metodiev/nikolaevo-house/3d/images/10-vatreshna-kuhnya-s-mebel.png

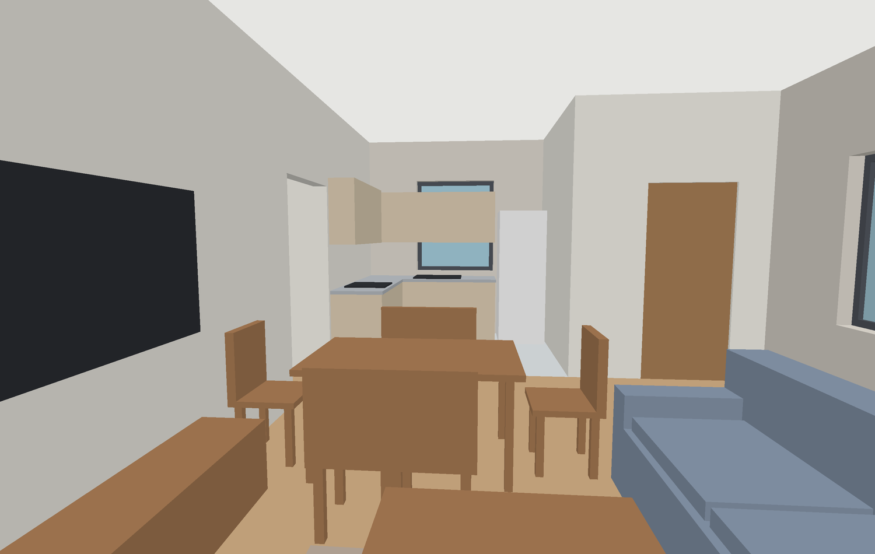
3d/images/10-vatreshna-kuhnya-s-mebel.png
