metodiev/nikolaevo-house/README.md

# Nikolaevo House

Проект за едноетажна ICF къща в Николаево.

## Концепция

Едноетажна, самостоятелна къща с ICF (изолирани бетонни кофражни) стени, максимално
правоъгълна форма, спални и хол на юг, вход от изток.

| Параметър | Стойност |
|---|---|
| Габарит | 12,00 × 8,20 m |
| Застроена площ | 98,4 m² |
| Чиста използваема площ | ≈ 80,3 m² |
| Спални | 2, двете с южно изложение |
| Хол + кухня | 30,8 m² отворено пространство |
| Баня | 1 |
| Мокро помещение / килер | 1 (пералня, съхранение, техника) |
| Ориентация | спални и хол – юг; кухня, баня, мокро – север; вход – изток |
| Покрив | двускатен, било изток–запад |
| Веранда (изток) | 1,80 × 8,20 = 14,76 m², отворена, дървена, собствен покрив |

## Площи на къщата

Едноетажна сграда, габарит **12,00 × 8,20 m** по външните стени.

| Показател | Как се получава | Площ |
|---|---|---|
| **Застроена площ (по външен контур)** | 12,00 × 8,20 | **98,40 m²** |
| Вътрешна площ в светли отвори | 11,30 × 7,50 | **84,75 m²** |
| **Чиста използваема площ** | сума на помещенията | **≈ 80,3 m²** |

Разликата от 98,40 до 80,3 m² е 18,1 m²: външните ICF стени (0,35 m по периметъра)
заемат ~13,7 m², а вътрешните прегради — ~4,4 m².

### По помещения

| Помещение | Размери (m) | Площ |
|---|---|---|
| Хол + трапезария | 4,70 × 5,28 | 24,8 m² |
| Кухня (отворена зона) | 2,68 × 2,22 | 5,95 m² |
| **Хол + кухня общо** | **отворено пространство** | **30,8 m²** |
| Спалня 1 | 3,15 × 4,10 | 12,9 m² |
| Спалня 2 | 3,15 × 4,10 | 12,9 m² |
| Коридор | 6,45 × 1,10 | 7,1 m² |
| Баня | 3,15 × 2,00 | 6,3 m² |
| Мокро помещение / килер | 3,15 × 2,00 | 6,3 m² |
| Антре | 1,90 × 2,10 | 4,0 m² |
| **Общо (чиста използваема)** | | **80,3 m²** |

Пълна площна сметка и координатна мрежа: [architecture/02-areas.md](./architecture/02-areas.md)

Всички числа се проверяват автоматично с `python tools/check_areas.py` —
скриптът изчислява площите от геометрията и обхожда целия проект за остарели
стойности ([tools/check_areas.py](./tools/check_areas.py)).

### За общината

Общината иска **застроена площ** и **разгъната застроена площ (РЗП)**. За тази
едноетажна къща двете са практически еднакви — няма втори етаж.

| Показател | Стойност |
|---|---|
| Застроена площ по външен контур (за нашия проект) | **98,40 m²** |
| РЗП (едноетажна, без сутерен и таван) | ≈ 98,40 m² |
| Веранда — по външен контур | 14,76 m² |
| **Общо с верандата** | **113,16 m²** |

> Верандата е **долепена и отворена**, не вградена. Дали влиза в застроената площ
> зависи от начина на отчитане — виж
> [architecture/05-veranda.md](./architecture/05-veranda.md).

> **Внимание:** точната дефиниция на „застроена площ“ и начинът на отчитане
> (по външен контур или по вътрешни стени, как се броят терасата и навесът) се
> определят от **проектанта по действащия ЗУТ и ПУП** — това **не е сигурно** без
> проверка и **се препоръчва консултация с общината**. Не попълвай тези числа в
> документи сам.

Плюс това общината следи и **процент на застрояване** и **КИНТ** за парцела — те
зависят от неговата площ, която още не е известна (виж
[отворените въпроси](./documentation/02-open-questions.md)).

## Структура на repository-то

| Папка | Съдържание |
|---|---|
| [architecture](./architecture) | Концептуален план, площи, дограма, диаграми, чертежи |
| [furniture](./furniture) | Обзавеждане — схеми и списък с размери |
| [electrical](./electrical) | Електроинсталация — план, табло, кръгове |
| [icf](./icf) | Пакет за доставчика на ICF панелите (задание, количества, скици) |
| [structure](./structure) | ICF конструктивна логика и детайли |
| [budget](./budget) | Оценка на разходите и бюджет „до ключ“ |
| [3d](./3d) | **3D модел** — интерактивен изглед, OBJ файлове, рендери |
| [materials](./materials) | Спецификация на основните материали |
| [documentation](./documentation) | Задание за проектанта, отворени въпроси |
| [plumbing](./plumbing) | ВиК (предстои) |
| [hvac](./hvac) | Отопление и вентилация (предстои) |
| [landscaping](./landscaping) | Двор и ландшафт (предстои) |
| [site](./site) | Парцел: кадастър, карти, измервания |
| [photos](./photos) | Снимки |

## Бърз достъп

**Архитектура**
- [Концептуален план](./architecture/01-concept-plan.md)
- [Площи](./architecture/02-areas.md)
- [Дограма и отвори](./architecture/03-openings.md)
- [Диаграми](./architecture/04-diagrams.md)
- [План 1:100 (SVG)](./architecture/plans/floor-plan.svg)
- [Ориентация в парцела (SVG)](./architecture/plans/site-orientation.svg)
- [Дограма и врати (SVG)](./architecture/plans/A-03-dograma.svg)
- [Веранда — описание и площи](./architecture/05-veranda.md)
- [Веранда — план 1:100 (SVG)](./architecture/plans/A-04-veranda.svg)
- [CAD план (DXF + PNG/SVG)](./architecture/cad/README.md) — генератор с ezdxf

**Обзавеждане**
- [Схеми и списък](./furniture/README.md)
- [Общ план (SVG)](./furniture/plans/F-01-obzor.svg)
- [Дневна зона (SVG)](./furniture/plans/F-02-dnevna.svg)
- [Спални (SVG)](./furniture/plans/F-03-spalni.svg)
- [Баня, мокро, антре (SVG)](./furniture/plans/F-04-mokri.svg)

**Електро**
- [Електро план и кръгове](./electrical/01-elektro-plan.md)
- [План на контактите (SVG)](./electrical/plans/E-01-plan.svg)
- [Схема на таблото (SVG)](./electrical/plans/E-02-tablo.svg)

**Конструкция**
- [ICF конструктивна логика](./structure/01-icf-structure.md)
- [Разрез на стена и подова плоча (SVG)](./structure/details/wall-section.svg)

**ICF доставчик**
- [Пакет за ICF доставчика](./icf/README.md)
- [Задание](./icf/01-zadanie.md) · [Стени и отвори](./icf/02-steni-i-otvori.md) · [Количества](./icf/03-kolichestva.md)
- [План на ICF стените (SVG)](./icf/plans/icf-plan.svg)
- [Фасади с отворите (SVG)](./icf/plans/icf-elevations.svg)
- [Детайли (SVG)](./icf/plans/icf-details.svg)

**3D модел**
- [Интерактивен 3D изглед](./3d/model.html) — отваря се в браузър, без интернет
- [3D модел (OBJ) с обзавеждане](./3d/house-full.obj) · [без обзавеждане](./3d/house-shell.obj)
- [Рендери: вън/вътре, с и без обзавеждане](./3d/README.md)

**Бюджет и документи**
- [Оценка на разходите (строителство)](./budget/01-cost-estimate.md)
- [Бюджет „до ключ“ с обзавеждане — таван ≈ 250 000 €](./budget/02-turnkey-max.md)
- [Задание за проектанта](./documentation/01-design-brief.md)
- [Отворени въпроси](./documentation/02-open-questions.md)

## Статус

Концепция — за обсъждане с проектант. Не е строителен проект и не замества
архитектурен и конструктивен проект по действащите изисквания.
