metodiev/nikolaevo-house/architecture/README.md

# Архитектура

Концептуален план на едноетажна ICF къща, 12,00 × 8,20 m (98,4 m² застроена площ).

## Документи

| Файл | Съдържание |
|---|---|
| [01-concept-plan.md](./01-concept-plan.md) | Концептуален план — зониране, разположение на помещенията, обосновка |
| [02-areas.md](./02-areas.md) | Списък на площите и площна сметка |
| [03-openings.md](./03-openings.md) | Дограма — прозорци, врати, позиции, размери |
| [04-diagrams.md](./04-diagrams.md) | Диаграми: зониране, циркулация, разпределение на площта |
| [05-veranda.md](./05-veranda.md) | Отворена веранда 1,80 × 8,20 m по цялата източна фасада |

## Чертежи

| Файл | Съдържание |
|---|---|
| [plans/floor-plan.svg](./plans/floor-plan.svg) | План на разположението, мащаб 1:100 при печат, с размери |
| [plans/site-orientation.svg](./plans/site-orientation.svg) | Ориентация и положение в парцела (схема, не е в мащаб) |
| [plans/A-03-dograma.svg](./plans/A-03-dograma.svg) | Дограма и врати — фасади на отворите с посока на отваряне |
| [plans/A-04-veranda.svg](./plans/A-04-veranda.svg) | Веранда — план 1:100 с обзавеждане за 6 души |

## CAD / DXF

| Файл | Съдържание |
|---|---|
| [cad/generate_plan.py](./cad/generate_plan.py) | Python скрипт (ezdxf) — генерира плана като DXF |
| [cad/house.dxf](./cad/house.dxf) | Генериран план, слоеве `WALLS` / `DOORS` / `WINDOWS` / `ROOMS` / `DIMENSIONS` |
| [cad/house.png](./cad/house.png) | Растерно изображение (200 dpi) |
| [cad/house.svg](./cad/house.svg) | Векторно изображение |

Скриптът чертае **същата къща** като останалите чертежи — 12,00 × 8,20 m и
стени 0,35 m. При стартиране проверява дали сметнатите площи съвпадат с
останалите документи и спира с грешка при разминаване. Подробности:
[cad/README.md](./cad/README.md).

## Основни решения

- Правоъгълник 12,00 × 8,20 m — без еркери, криви и ъгли, различни от 90°.
- Дългата ос е изток–запад: 12 m южен фасад за двете спални и хола.
- Вход от изток (достъпът до парцела е от изток), антре в североизточния ъгъл.
- Мокри функции (кухня, мокро помещение, баня) са групирани по северната стена —
  къси ВиК трасета.
- Спалните са отделени от дневната зона с коридор.

## Свързани папки

- [ICF пакет за доставчика](../icf) — задание, количества и скици за фирмата с панелите
- [Конструкция](../structure)
- [Бюджет](../budget)
- [Задание за проектанта](../documentation/01-design-brief.md)
