metodiev/nikolaevo-house/furniture/README.md

# Обзавеждане

Схеми и списък на обзавеждането за едноетажната ICF къща.

> Всички размери са **примерни** — показват, че мебелите се побират и че
> проходите са разумни. Не са проект за изработка на мебели.

---

## Схеми

| Лист | Съдържание | Мащаб |
|---|---|---|
| [F-01-obzor.svg](./plans/F-01-obzor.svg) | общ план с обзавеждане, всички помещения | 1:100 |
| [F-02-dnevna.svg](./plans/F-02-dnevna.svg) | хол + трапезария + кухня | 1:50 |
| [F-03-spalni.svg](./plans/F-03-spalni.svg) | двете спални | 1:50 |
| [F-04-mokri.svg](./plans/F-04-mokri.svg) | баня, мокро помещение, антре | 1:50 |

PNG версии за имейл и телефон: [images/](./images).

---

## Основна логика на разположението

| Помещение | Ключово решение |
|---|---|
| **Кухня** | Г-образен плот 600 mm: мивка под прозореца, котлони на западния плот, хладилник в североизточния ъгъл |
| **Трапезария** | Маса 1400 × 900 с 6 стола в западната част на хола, изтеглена на юг — проходът до коридора остава свободен |
| **Хол** | Диван 2200 mm с гръб на изток, срещу телевизора на западната преграда; северната ивица на хола е свободна за придвижване |
| **Спалня 1** | Легло 1600 × 2000 с табла на вътрешната преграда, гардероб 1600 mm, без скрин |
| **Спалня 2** | Легло 1600 × 2000 с табла на западната стена, гардероб 1200 mm, без скрин |
| **Баня** | Душ 1200 × 900, WC, мивка с шкаф 1000 mm |
| **Мокро** | Пералня, сушилня, плот с мивка, бойлер, вентилация |
| **Антре** | Гардероб 400 mm, пейка, електрическо табло |

Пълен списък с размери: [01-obzavezhdane.md](./01-obzavezhdane.md).

---

## Важни ограничения

1. **Гардеробите са с плъзгащи врати** — при 550 mm дълбочина крилата не могат да
   се отварят навън без да блокират прохода.
2. **Леглата са с табла на вътрешна стена** — не под прозорец.
3. **Пред плъзгащата врата на юг** се оставя свободна зона поне 1200 mm.
4. **Кухнята е на север** — плотът е под прозореца, но осветлението над плота
   трябва да е изкуствено и достатъчно.
5. Размерите на мебелите в схемите са типични за българския пазар — при поръчка
   се проверяват спрямо избрания модел.

---

## Как се генерират

```bash
python furniture/generate_furniture.py       # SVG в plans/
python tools/export_png.py furniture         # PNG в images/
```

Скриптът държи геометрията на сградата и обзавеждането на едно място — при
промяна на план се редактира само той.

---

**Виж още:** [концептуален план](../architecture/01-concept-plan.md) ·
[площи](../architecture/02-areas.md) ·
[дограма](../architecture/03-openings.md) ·
[електро](../electrical)
