metodiev/nikolaevo-house/3d/README.md

# 3D модел на къщата

Обемен модел на едноетажната ICF къща — за оглед отвън и отвътре, със и без
обзавеждане. Геометрията се строи от **същите размери**, използвани в 2D
чертежите, така че не може да се разминава с тях.

> Това е **концептуален обемен модел**, не работен проект. Мебелите са с
> примерни размери и форми; покривът е опростен; няма конструктивни детайли,
> инсталации и точно осветление.

---

## 1. Какво има в папката

| Файл | Какво е |
|---|---|
| [model.html](./model.html) | **Интерактивен 3D изглед** — отваря се с двоен клик в браузър |
| `model-data.js` | Геометрията, която `model.html` зарежда (генерира се) |
| `model-data.json` | Същата геометрия като JSON — за други инструменти |
| `house-full.obj` + `.mtl` | 3D модел **с обзавеждане** — за Blender, SketchUp, Revit и др. |
| `house-shell.obj` + `.mtl` | 3D модел **само конструкция** — без обзавеждане |
| [generate_3d.py](./generate_3d.py) | Скриптът, който строи всичко и рендира картинките |
| `images/` | Рендерите (виж по-долу) |

Всичко се пресъздава с една команда:

```
python generate_3d.py
```

---

## 2. Интерактивният изглед

Отвори [model.html](./model.html) с двоен клик — работи без интернет и без
инсталация (данните са в `model-data.js`).

- **Влачене с мишката** — завъртане
- **Колело** — увеличение
- **Десен бутон** — преместване
- Отметки: обзавеждане / покрив / таван / стени и дограма / основа и подове
- Бутони за готови гледни точки: външна югоизток и североизток, план отгоре,
  вътре в хол, кухня и спалня
> При избор на вътрешна гледна точка покривът се скрива автоматично, а таванът
> остава — иначе се вижда само небето.

---

## 3. Рендерите

| Файл | Какво показва |
|---|---|
| `01-aksonometriya-s-mebel.png` | разрез-аксонометрия от югоизток **с** обзавеждане |
| `02-aksonometriya-bez-mebel.png` | същата, **без** обзавеждане |
| `03-aksonometriya-severoiztok.png` | аксонометрия от североизток |
| `04-fasada-yug.png` | южна фасада (прав изглед) |
| `05-fasada-iztok.png` | източна фасада — входът |
| `06-perspektiva-yugoiztok.png` | външна перспектива от югоизток |
| `07-perspektiva-severoiztok.png` | външна перспектива от североизток |
| `08-vatreshna-dnevna-s-mebel.png` | хол + трапезария **с** обзавеждане |
| `09-vatreshna-dnevna-bez-mebel.png` | хол **без** обзавеждане |
| `10-vatreshna-kuhnya-s-mebel.png` | изглед към кухнята **с** обзавеждане |
| `11-vatreshna-kuhnya-bez-mebel.png` | кухня **без** обзавеждане |
| `12-vatreshna-spalnya-s-mebel.png` | спалня **с** обзавеждане |
| `13-vatreshna-spalnya-bez-mebel.png` | спалня **без** обзавеждане |
| `14-veranda-s-mebel.png` | отворената веранда отвън, с пейката |
| `15-veranda-otvorena.png` | верандата отгоре, без собствения покрив |

„Разрез-аксонометрия" означава, че стените са отрязани на 1,35 m — така се
вижда разпределението от птичи поглед.

---

## 4. Как е построен моделът

| Елемент | Стойност | Източник |
|---|---|---|
| Габарит | 12,00 × 8,20 m | [architecture/02-areas.md](../architecture/02-areas.md) |
| Външни стени | 0,35 m ICF | [structure/01-icf-structure.md](../structure/01-icf-structure.md) |
| Вътрешни прегради | 0,15 m и 0,12 m | същото |
| Височина до стреха | 3,00 m | [architecture/cad](../architecture/cad) |
| Покрив | двускатен, наклон 25°, надвес 0,60 / 0,50 m | [structure/01-icf-structure.md](../structure/01-icf-structure.md) |
| Отвори | П1–П9 и В1–В6 с точни размери и подпрозорци | [architecture/03-openings.md](../architecture/03-openings.md) |
| Обзавеждане | координатите от 2D листовете F-01…F-04 | [furniture/](../furniture) |
| Веранда | 1,80 × 8,20 m отворена, по цялата източна фасада | [architecture/05-veranda.md](../architecture/05-veranda.md) |

Дебелината на покрива (0,20 m) и надвесът са **работни допускания** —
окончателните стойности се определят от конструктор.

---

## 5. Ограничения

- **Покривът е опростен** — без ферми, улуци, снегозадържачи.
- **Обзавеждането е блоково** — правоъгълници с правилните размери и позиции,
  но без форми и детайли. За покупка се ползва [furniture/01-obzavezhdane.md](../furniture/01-obzavezhdane.md).
- **Няма инсталации** — тръби, кабели и въздуховоди не са моделирани.
- **Няма терен** — земята е равна равнина.
- **Осветлението е условно** — два посоки + околна светлина, не е фотореализъм.
- Файловете `.obj` са с метрични единици. Ако нормалите изглеждат обърнати в
  дадена програма, пусни „Recalculate Outside" (Blender: Shift+N).
