metodiev/nikolaevo-house/budget/README.md

# Бюджет

Ориентировъчна оценка на разходите за едноетажната ICF къща (98,4 m² застроена площ).

## Документи

| Файл | Съдържание |
|---|---|
| [01-cost-estimate.md](./01-cost-estimate.md) | Груба оценка: конструкция и базова завършеност, допускания, изключени разходи |
| [02-turnkey-max.md](./02-turnkey-max.md) | **Бюджет „до ключ“ с обзавеждане — таван ≈ 250 000 €** |

## Важно

Всички стойности са **ориентировъчни диапазони**, а не оферти.

> Това е само ориентировъчна стойност, действителната цена зависи от местната оферта.

## Свързани папки

- [Архитектура](../architecture)
- [Конструкция](../structure)
- [ICF оферта](../icf/README.md)
- [Обзавеждане](../furniture/01-obzavezhdane.md)
