metodiev/nikolaevo-house/electrical/README.md

# Електроинсталация

Концептуален план на електричеството — контакти, ключове, осветление и табло.

## Документи и схеми

| Файл | Съдържание |
|---|---|
| [01-elektro-plan.md](./01-elektro-plan.md) | описание: табло, кръгове, точки по помещения, ICF специфика |
| [plans/E-01-plan.svg](./plans/E-01-plan.svg) | план на контактите и осветлението, 1:75 |
| [plans/E-02-tablo.svg](./plans/E-02-tablo.svg) | едносхемна схема на таблото |

PNG версии: [images/](./images).

## Накратко

- **Табло:** в антрето, на южната стена до вратата, височина 1400–1800 mm.
- **12 кръга** в таблото (2 от тях резервни), две дефектнотокови защити.
- Кухнята е на отделен кръг — котлони и фурна не се комбинират с контактите.
- Баня, мокро и външните консуматори са на ДЗТ 2 (30 mA).

## ICF специфика

- В ICF стена **не се къртят канали** — трасетата се планират предварително.
- Контакти на външните стени изискват заложени тръби в кофража.
- Таблото е на вътрешна преграда — по-лесно обслужване.

## Виж още

- [Обзавеждане](../furniture) — как мебелите определят позициите на контактите
- [ICF конструкция](../structure/01-icf-structure.md)
- [Отворени въпроси](../documentation/02-open-questions.md)
- [Бюджет „до ключ“](../budget/02-turnkey-max.md)
