metodiev/nikolaevo-house/documentation/README.md

# Документация

Работни документи за комуникация с проектант, изпълнител и институции.

## Документи

| Файл | Съдържание |
|---|---|
| [01-design-brief.md](./01-design-brief.md) | Задание за проектанта — изисквания, приети решения, ограничения |
| [02-open-questions.md](./02-open-questions.md) | Отворени въпроси и липсваща информация (чеклист) |

## Свързани папки

- [Архитектура](../architecture)
- [Конструкция](../structure)
- [Бюджет](../budget)
- [Парцел](../site)
