metodiev/nikolaevo-house/landscaping/README.md

# Двор и ландшафт

Предстои.

## Връзка с концепцията

- Достъпът е от **изток** → паркинг и подход от изток.
- Южната фасада е свободна за **тераса** (препоръчително ~4,0 × 3,0 m) и градина.
- Засенчване на южните отвори — надвес или пергола.
- Западната фасада е минимално отворена.

## Виж още

- [Ориентация в парцела](../architecture/plans/site-orientation.svg)
- [Концептуален план](../architecture/01-concept-plan.md)
