metodiev/nikolaevo-house/photos/README.md

# Снимки

Снимки на терена, на съседни сгради и на референтни ICF обекти.

- Снимки на парцела (за контекст и засенчване)
- Снимки на подхода от изток
- Референтни сгради с ICF конструкция

**Все още няма качени снимки.**
