metodiev/nikolaevo-house/structure/README.md

# Конструкция

ICF (изолирани бетонни кофражни) конструкция на едноетажната къща.

## Документи

| Файл | Съдържание |
|---|---|
| [01-icf-structure.md](./01-icf-structure.md) | Конструктивна логика, слоеве, фундамент, покрив, отвори, инсталации |

## Чертежи

| Файл | Съдържание |
|---|---|
| [details/wall-section.svg](./details/wall-section.svg) | Схематичен разрез: външна стена, подова плоча, фундамент, покрив |

## Накратко

- **Външни стени** — носещи ICF стени с бетонно ядро, затворен правоъгълен контур.
- **Вътрешни стени** — неносещи прегради (газобетон или гипсокартон).
- **Покрив** — двускатен, дървена конструкция, стъпва само на външните стени.
- **Под** — плоча върху земя с непрекъсната топлоизолация под нея.

## Свързани папки

- [Архитектура](../architecture)
- [Бюджет](../budget)
