metodiev/nikolaevo-house/architecture/03-openings.md

# Дограма и отвори

Спецификация на прозорци и врати за концептуалния план.

> Размерите са **номинални** (отвор в светъл размер). Реалните размери зависят от
> избраната дограма, монтажната система и ICF системата. Всички отвори в ICF стена
> изискват проектирана надгреда и армировка — уточнява се от конструктор.

---

## 1. Координатна система

Позициите са в **mm**, мерени от външния северозападен ъгъл на сградата:

- `x` — на изток от западната фасада (0 → 12 000)
- `y` — на юг от северната фасада (0 → 8 200)

---

## 2. Прозорци

| № | Помещение | Фасада | Ш × В (mm) | Подпрозорец (mm) | Позиция | Функция |
|---|---|---|---|---|---|---|
| П1 | Спалня 1 | юг | 1 500 × 1 400 | 800 | x 1 175 – 2 675 | Основна светлина, изглед |
| П2 | Спалня 2 | юг | 1 500 × 1 400 | 800 | x 4 475 – 5 975 | Основна светлина, изглед |
| П3 | Хол / трапезария | юг | **плъзгаща врата 2 800 × 2 250** | 0 | x 7 900 – 10 700 | Изход към тераса, основна светлина |
| П4 | Кухня | север | 1 200 × 1 400 | 1 000 | x 7 690 – 8 890 | Над плота, работна светлина |
| П5 | Баня | север | 600 × 600 | 1 600 | x 1 625 – 2 225 | Вентилация + дискретна светлина |
| П6 | Мокро помещение | север | 600 × 600 | 1 500 | x 4 925 – 5 525 | Вентилация + светлина |
| П7 | Трапезария | изток | 1 600 × 1 400 | 800 | y 3 500 – 5 100 | Сутрешна светлина |
| П8 *(опция)* | Спалня 1 | запад | 1 000 × 1 400 | 800 | y 5 200 – 6 200 | Кръстосано проветряване |
| П9 | Хол (югоизток) | изток | 1 400 × 1 400 | 800 | y 5 900 – 7 300 | Допълнителна светлина в хола |

**Обща площ на остъкляването в южния фасад:** 2 × 2,10 + 6,30 = **10,5 m²**
(при южна стена ~12,0 × 3,0 m). Това е сериозно количество — виж т. 5.

**Източно остъкляване:** П7 (2,24 m²) + П9 (1,96 m²) = **4,2 m²**.
Общо за сградата (без опцията П8): **17,1 m²**; с П8 — 18,5 m².

---

## 3. Врати

| № | Помещение | Фасада / стена | Ш × В (mm) | Позиция | Бележка |
|---|---|---|---|---|---|
| В1 | Входна | изток | 1 050 × 2 100 | y 700 – 1 750 | Навес отвън, прагово осветление |
| В2 | Антре → хол | преграда | 900 × 2 100 | x 10 400 – 11 300 | Стъклена врата по избор |
| В3 | Коридор → спалня 1 | преграда | 900 × 2 000 | x 900 – 1 800 | Отваря се в стаята |
| В4 | Коридор → спалня 2 | преграда | 900 × 2 000 | x 4 700 – 5 600 | Отваря се в стаята |
| В5 | Коридор → баня | преграда | 900 × 2 000 | x 2 200 – 3 100 | Отваря се в банята |
| В6 | Коридор → мокро помещение | преграда | 900 × 2 000 | x 3 800 – 4 700 | Отваря се в помещението |
| – | Коридор → хол | преграда | **отвор 1 100, без врата** | y 2 500 – 3 600 | Широк проход |

Бележки по вратите:

- Всички вътрешни врати са с **праг, равен на пода** (без преход) — удобно за
  почистване и за достъпност.
- Входната врата е на **източната** фасада — предвижда се **навес** или издадена плоча,
  защото валежите и вятърът там са чести.
- В банята и мокрото помещение — влагоустойчиви врати с долен вентилационен процеп.

---

## 4. Изисквания към дограмата

| Аспект | Препоръка | Статус |
|---|---|---|
| Профил | PVC или алуминий с термомост; **по енергиен проект** | за уточняване |
| Стъклопакет | двоен или троен; **ниска слънчева пропускливост (g) на юг**, по-висока на север | за уточняване |
| Топлинни характеристики | по енергийния проект/сертификат на сградата | **не е сигурно** — изисква проект |
| Монтаж | в зоната на изолацията, с монтажни ленти и правилен преход към ICF слоевете | критично за херметичност |
| Сенници/ролетки | касета, скрита в преградата или в тавана — съгласува се с дебелината на стената | за уточняване |
| Подпрозоръчни первази | външен каперезлив профил + вътрешен перваз | – |

**Важно за ICF:** отворите се правят в кофража, а не се изрязват след бетониране.
Плъзгащата врата 2,80 m изисква стоманобетонна надгреда — нормално решение, но
трябва да е предвидено в конструктивния проект.

---

## 5. Слънце и засенчване

| Фасада | Риск | Мярка |
|---|---|---|
| Юг | лятно прегряване през 10,5 m² стъкло | надвес/пергола ≥ 1,0–1,2 m; външно засенчване; стъкло с нисък g |
| Изток | сутрешно нагряване | умерен отвор 1,60 m; щора/външна жалузия |
| Запад | следобедно прегряване | без отвор или само малък, със задължително засенчване |
| Север | топлинни загуби | малки отвори, високо разположени |

Точният размер на надвеса се изчислява от проектант според географската ширина и
желаното засенчване — **тук не се дават конкретни стойности, защото зависят от
изчисление**.

---

## 6. Вентилация

- Баня, мокро помещение и кухня: **механично изсмукване** (не разчитайте само на
  прозорците).
- ICF къщата е практически херметична → препоръчва се **вентилация с рекуперация**,
  като агрегатът се позиционира в мокрото помещение.
- Въздуховодите се планират предварително — в ICF стена не се къртят канали.

---

**Виж още:** [концептуален план](./01-concept-plan.md) · [площи](./02-areas.md) ·
[конструкция](../structure/01-icf-structure.md)
