metodiev/nikolaevo-house/architecture/05-veranda.md

# Веранда (изток) — отворена

Отворена дървена веранда по **цялата източна фасада** на къщата.
**1,80 × 8,20 m = 14,76 m²** — покрит навес с подова скара, подпори и парапет.

> Това е **концепция**, не строителен чертеж. Конструкцията, фундирането и
> захващането към къщата се оразмеряват от проектант.

---

## 1. Позиция

Координатите са в mm от северозападния ъгъл на къщата (x — изток, y — юг):

| Ръб | Координата |
|---|---|
| Западен (до къщата) | x = **12 000** |
| Източен | x = **13 800** |
| Северен | y = **0** |
| Южен | y = **8 200** |

Верандата минава по цялата дължина на сградата и **покрива входната врата В1**
(y 700–1 750) — входът става защитен от дъжд и сняг. Прозорците **П7** и **П9**
също са под навеса, което ги пази от пряко слънце и валежи.

Не изменя ICF стените — долепена е, с дилатационна фуга.

---

## 2. Площи

| Показател | Стойност |
|---|---|
| Къща (застроена) | 98,40 m² |
| Веранда (по външен контур) | **14,76 m²** |
| **Общо с верандата** | **113,16 m²** |

**За общината:** отворената веранда **обикновено не се брои** към застроената
площ по същия начин, както затворено помещение, но точната дефиниция и начинът
на отчитане **не са сигурни** — уточняват се с проектанта и общината. Затова
двете числа са дадени отделно. Не попълвай тези числа в документи сам.

---

## 3. Конструкция

| Елемент | Решение |
|---|---|
| Основа | точкови фундаменти под подпорите — **не е оразмерено** |
| Под | дървена скара с дъски, ~80 mm под котата на къщата |
| Подпори | дървени **100 × 100 mm**, на ~2,0 m (5 бр.) |
| Парапет | дървен, **1,00 m**, по външния ръб; започва след входа (y > 2,30) |
| Покрив | **собствен едноскатен**: 2,90 m при къщата → 2,45 m при външния ръб |
| Покривно покритие | по избор — битумни керемиди, метал, поликарбонат |
| Стъпало | при северния край, до входната врата |
| Връзка с къщата | дилатационна фуга; **без пробиване на ICF стената** |

Покривът на верандата минава **под** стрехата на къщата — двете покривни
плоскости не се пресичат. Проверява се на място според изпълнението.

---

## 4. Обзавеждане

| # | Артикул | Размер | Бр. |
|---|---|---|---|
| 1 | Пейка до стената | 440 × 1500 | 1 |

> **Внимание:** при дълбочина 1,80 m **маса за 6 души не се побира** — за
> хранене трябва или по-дълбока веранда (≥ 2,60 m), или масата остава в хола.
> Верандата е за сянка, кафе и престой, не за хранене.

---

## 5. Какво печели къщата

- **Покрит вход** — В1 е защитен от валежи, а изтокът е ветровит.
- **Сянка** за източната фасада през лятото → по-малко прегряване на хола.
- **Връзка двор ↔ хол** без стъпала и кал по пода.
- Навесът пази дограмата от пряко слънце и удължава живота ѝ.

---

## 6. Ограничения и отворени въпроси

- [ ] **Достъп от вътре** — сега от хола се излиза само през прозорци. Ако искаш
      врата, **П7 трябва да стане врата** (1600 × 2200) — това променя ICF пакета
      и надгредата.
- [ ] **Ширина 1,80 m** — достатъчна за проход и пейка, но не за маса.
      Ако искаш хранене навън, нужна е дълбочина ≥ 2,60 m.
- [ ] **Основа** — нивото на терена при източната фасада не е измерено.
- [ ] **Отводняване** — покривът на верандата събира вода; трябва улук и
      отвеждане, иначе пада на входа.
- [ ] **ПУП** — дали навесът е допустим на това разстояние от съседната граница,
  се проверява по ПУП.

---

**Виж още:** [концептуален план](./01-concept-plan.md) · [дограма](./03-openings.md) ·
[план на верандата (SVG)](./plans/A-04-veranda.svg) ·
[3D модел](../3d/README.md)
