metodiev/nikolaevo-house/architecture/01-concept-plan.md

# Концептуален план

Едноетажна, самостоятелна ICF къща · 12,00 × 8,20 m · 98,4 m² застроена площ ·
вход от изток · спални и хол на юг.

> Концепция за обсъждане с проектант. Не е строителен чертеж. Всички размери са
> номинални и подлежат на проверка и оразмеряване от лицензиран архитект и конструктор.

---

## 1. Обобщение

| Параметър | Стойност |
|---|---|
| Габарит (външен) | 12,00 m изток–запад × 8,20 m север–юг |
| Застроена площ | 98,40 m² |
| Вътрешна площ в светли отвори | 11,30 × 7,50 = 84,75 m² |
| Чиста използваема площ | ≈ 80,3 m² |
| Външни ICF стени | ≈ 350 mm (работно допускане) |
| Вътрешни прегради | 150 mm; 120 mm около антрето |
| Периметър на външните стени | 40,4 m |
| Покрив | двускатен, било по оста изток–запад |
| Етажност | 1 |

## 2. Защо 98,4 m², а не 96 m²

Първоначалната концепция беше 12,00 × 8,00 m = 96 m² с **вход от север**. След
уточнението, че **достъпът до парцела е от изток**, входът се мести на източната
фасада и това променя геометрията:

- Антрето трябва да е на източната фасада. То заема ~4,0 m² плюс преградите си от
  дневната зона.
- При 96 m² дневната зона е 4,30 × 7,30 m = 31,4 m². След отделяне на антре остават
  под 30 m² — не изпълнява изискването „хол + кухня ≥ 30 m²“.
- Затова къщата се увеличава с 0,20 m по дълбочина: **12,00 × 8,20 m = 98,4 m²**.
  Дневната зона става 4,70 × 7,50 m = 35,25 m², а след антрето остават **30,8 m²**
  отворено пространство.

98,4 m² е в горната част на зададения диапазон 75–99 m², но е най-малката площ,
при която всички изисквания се изпълняват без компромис.

## 3. Форма и ориентация

- **Правоъгълник**, съотношение 1,46 : 1 — компактен, нисък периметър спрямо площта.
- Само ъгли 90° → стандартни ICF ъглови блокове, без еркери, криви и скосявания.
- Дългата ос е **изток–запад**, за да се получи максимален южен фасад — 12 m.
- **Юг:** двете спални + холът (голяма плъзгаща врата към тераса).
- **Север:** кухня, мокро помещение, баня — малки отвори, без прегряване.
- **Изток:** вход + един прозорец за трапезарията (сутрешна светлина).
- **Запад:** почти затворен фасад (следобедно прегряване), само опционален малък
  прозорец в спалня 1.

Чертеж: [plans/floor-plan.svg](./plans/floor-plan.svg) · Схема на парцела:
[plans/site-orientation.svg](./plans/site-orientation.svg)

## 4. Зониране

Къщата е разделена на две зони по дължина и на три ленти по дълбочина.

| Зона | Ширина | Съдържание |
|---|---|---|
| **Източна — дневна** | 4,70 m | хол, трапезария, кухня, антре — едно отворено пространство |
| **Западна — спална и обслужваща** | 6,45 m | две спални, коридор, баня, мокро помещение |

| Лента (от север) | Дълбочина | Съдържание |
|---|---|---|
| Северна | 2,00–2,10 m | баня, мокро помещение, кухненска зона, антре |
| Средна | 1,10 m | коридор |
| Южна | 4,10 m | спалня 1, спалня 2, хол |

**Принцип на групиране:** всички мокри функции (кухня, мокро помещение, баня) лежат
на една линия по северната стена, съседни една на друга. Това дава къси ВиК трасета,
обща водопроводна стена и един излаз за канализационните сонди.

## 5. Разположение на помещенията

Координатите по-долу са в mm, измерени от **външния северозападен ъгъл**:
`x` — на изток от западната фасада, `y` — на юг от северната фасада.
Пълната координатна мрежа е в [02-areas.md](./02-areas.md).

### 5.1 Дневна зона — хол, трапезария, кухня (отворено)

**Източният край на къщата, 4,70 m широка, по цялата дълбочина 7,50 m.**
Без вътрешни прегради — едно пространство.

- **Хол + трапезария** (южна част, ≈ 24,8 m²): южният фасад е плъзгаща врата 2,80 m
  към тераса. Трапезната маса е в зоната пред кухнята, към източния прозорец.
- **Кухня** (северна част, ≈ 5,95 m² под + плотове): Г-образен плот по северната стена
  (~2,7 m) и по преградата към мокрото помещение (~2,0 m). Мивката е на преградата —
  плътно до мокрото помещение, за да е къс водопроводът. Плотът по северната стена е
  под прозореца.
- **Мека граница** между кухня и хол: маркирана само с линия на пода/таван — без
  преграда, за да остане пространството отворено.

### 5.2 Антре

**Североизточен ъгъл, 1,90 × 2,10 m (4,0 m²).**

- Входна врата на **източната** фасада (достъпът е от изток).
- Врата на юг към хола.
- Гардероб/закачалка по западната стена.
- Задължителен **навес** над входа отвън (източен вятър/дъжд).

Антрето е отделно затворено помещение — това е и топлинен шлюз за ICF къщата.

### 5.3 Спалня 1

**Югозападен ъгъл, 3,15 × 4,10 m (12,9 m²).**

- Южен прозорец 1,50 m.
- Опционален западен прозорец 1,00 m за кръстосано проветряване.
- Врата от коридора, в северната част на стаята.
- Място за двуспално легло с глава на западната или източната стена (без прозорец
  зад главата), гардероб по северната стена.

### 5.4 Спалня 2

**Южна лента, в средата, 3,15 × 4,10 m (12,9 m²).**

- Южен прозорец 1,50 m.
- Врата от коридора.
- Единствен фасад — юг (вж. ограниченията в т. 8).

### 5.5 Коридор

**Средна лента, 6,45 × 1,10 m (7,1 m²).**

- Свързва антрето/хола с двете спални, банята и мокрото помещение.
- Източният край се отваря широко (1,10 m) към хола.
- Възможно вградено ниско шкафче по дължината (дълбочина ~0,35 m).

### 5.6 Баня

**Северозападен ъгъл, 3,15 × 2,00 m (6,3 m²).**

- Душ (или вана), WC, мивка, шкаф.
- Малък северен прозорец 0,60 × 0,60 на високо ниво.
- Задължителна механична вентилация.
- Дължината 3,15 m позволява душът и WC да са в единия край, а мивката и шкафът —
  в другия.

### 5.7 Мокро помещение / килер

**Северна лента, до банята, 3,15 × 2,00 m (6,3 m²).**

- Пералня, сушилня (по избор), стелажи, техника.
- Тук се позиционират: бойлер/термопомпа, вентилационен агрегат с рекуперация,
  евентуален колектор.
- Малък северен прозорец 0,60 × 0,60 + механично изсмукване.
- Плот за пране и мивка за ръце (по избор).

## 6. Циркулация

```
Вход (изток) → антре → хол/трапезария/кухня (отворено)
                   ↘
                     хол → коридор → спалня 1
                                  → спалня 2
                                  → баня
                                  → мокро помещение
```

- Най-дългият път от входа до най-далечната стая е ~9 m.
- Коридорът е единственият „тъмен“ участък; осветява се от хола в източния си край.
  Ако е важно, може да се добави покривен тунел/светлинен тунел над коридора.

## 7. Връзка с парцела

- Достъпът е от **изток** → вход, паркинг и обслужване от изток.
- Южната фасада е свободна за тераса и градина.
- Северната фасада е „обслужваща“ — там са малките отвори; подходяща за
  климатични тела, ВиК разклонения и складиране.
- Западната фасада е минимално отворена — предпазва от следобедно слънце.
- Тераса: препоръчително ~4,0 × 3,0 m пред плъзгащата врата (извън 98,4 m²).

Разположението спрямо границите на парцела **не е определено** — изисква кадастрална
скица и проверка на отстоянията по ПУП.

## 8. Ограничения на концепцията

1. **Спалня 2 има само един фасад (юг).** Няма кръстосано проветряване — изтокът е
   зает от хола, северът от коридора. Компенсация: проветряване през вратата и
   вентилация с рекуперация.
2. **Коридорът е 7,1 m² (≈ 9 % от чистата площ)** — цената на отделянето на спалните
   от дневната зона. Ако приватността не е приоритет, спалните могат да се отворят
   директно към хола и да се спечелят ~5 m².
3. **Кухнята е на север** — по-малко пряко слънце, но и без прегряване; изисква добро
   изкуствено осветление над плота.
4. **Голямата южна плъзгаща врата (2,80 m)** създава риск от лятно прегряване.
   Задължително външно засенчване (надвес ≥ 1,0 m или пергола) и стъклопакет с ниска
   слънчева пропускливост. Точният размер на надвеса се изчислява от проектант.
5. **Площта е близо до горната граница на диапазона (99 m²).** Намаляване до ~88 m² е
   възможно само с отказ от едно от изискванията.
6. **12 m дължина** може да не се събере на тесен парцел с отстоянията по ПУП.
7. **Антрето е малко (1,90 × 2,10 m).** Достатъчно е за гардероб и обувки, но не за
   място за сядане.
8. Всичко, свързано с **геология, ниво на подпочвени води, ПУП, отстояния, височина
   и наклон на покрива**, е **неизвестно** и трябва да се провери.

Пълен списък: [02-open-questions.md](../documentation/02-open-questions.md).

## 9. Следващи стъпки

1. Проверка на разположението в парцела (кадастър + ПУП).
2. Избор на ICF система и на нейния геометричен модул.
3. Геоложки доклад.
4. Архитектурен проект (фази: идеен → технически → работен).
5. Конструктивен проект.
6. Оферти от 2–3 изпълнители с опит в ICF.

---

**Свързани документи:** [площи](./02-areas.md) · [дограма](./03-openings.md) ·
[диаграми](./04-diagrams.md) · [конструкция](../structure/01-icf-structure.md) ·
[бюджет](../budget/01-cost-estimate.md)
