metodiev/nikolaevo-house/architecture/02-areas.md

# Площи

Площна сметка на концепцията. Всички размери в **mm**, площите в **m²**.

> Номинални стойности по концептуалния план. Подлежат на преизчисляване в
> архитектурния проект (особено след избор на конкретна ICF система и нейната
> дебелина).

---

## 1. Обща площна сметка

| Показател | Изчисление | m² |
|---|---|---|
| Застроена площ | 12,00 × 8,20 | **98,40** |
| − Външни ICF стени (в план) | 98,40 − 84,75 | −13,65 |
| Вътрешна площ в светли отвори | 11,30 × 7,50 | **84,75** |
| − Преградни стени | 84,75 − 80,28 | ≈ −4,47 |
| **Чиста използваема площ** | | **≈ 80,3** |

---

## 2. Площи по помещения

| № | Помещение | Размери (mm) | Площ (m²) | Ориентация |
|---|---|---|---|---|
| 01 | Хол + трапезария | 4700 × 5280 | **24,8** | юг, изток |
| 02 | Кухня (отворена зона) | 2680 × 2220 | **5,95** | север |
| | **Общо отворено пространство 01 + 02** | 4700 × 7500 − антре − стени | **30,8** | |
| 03 | Спалня 1 | 3150 × 4100 | **12,9** | юг |
| 04 | Спалня 2 | 3150 × 4100 | **12,9** | юг |
| 05 | Коридор | 6450 × 1100 | **7,1** | – |
| 06 | Баня | 3150 × 2000 | **6,3** | север |
| 07 | Мокро помещение / килер | 3150 × 2000 | **6,3** | север |
| 08 | Антре | 1900 × 2100 | **4,0** | изток |
| | **Сума (чиста използваема)** | | **80,3** | |

Сума на чистата използваема площ:

24,80 + 5,95 + 12,92 + 12,92 + 7,10 + 6,30 + 6,30 + 3,99 = **80,28 ≈ 80,3 m²**

---

## 3. Преградни стени

| Преграда | Дебелина | Дължина | m² |
|---|---|---|---|
| Дневна зона / спална зона (с проход) | 150 | 7 500 | 1,13 |
| Баня / мокро помещение | 150 | 2 000 | 0,30 |
| Северна лента / коридор | 150 | 6 450 | 0,97 |
| Коридор / спални | 150 | 6 450 | 0,97 |
| Между спалните | 150 | 4 100 | 0,62 |
| Антре — стени (2 бр.) | 120 | ~3 950 | 0,47 |
| **Общо** | | | **≈ 4,45** |

Разликата от 4,47 в общата сметка идва от закръглянето на дължините в таблицата.

---

## 4. Координатна мрежа на осите

Начало: **външен северозападен ъгъл**. `x` расте на изток, `y` расте на юг.

### Вертикални оси (по x)

| Оса | x (mm) | Описание |
|---|---|---|
| A | 0 | външна фасада запад |
| B | 350 | вътрешна повърхност на западната стена |
| C | 3 500 | преграда баня / мокро (западна страна) |
| D | 3 650 | преграда баня / мокро (източна страна) |
| E | 6 800 | преграда дневна / спална зона (западна страна) |
| F | 6 950 | преграда дневна / спална зона (източна страна) |
| G | 9 630 | антре, западна стена |
| H | 9 750 | антре, вътрешна западна повърхност |
| I | 11 650 | вътрешна повърхност на източната стена |
| J | 12 000 | външна фасада изток |

### Хоризонтални оси (по y)

| Оса | y (mm) | Описание |
|---|---|---|
| 1 | 0 | външна фасада север |
| 2 | 350 | вътрешна повърхност на северната стена |
| 3 | 2 350 | преграда северна лента / коридор (северна страна) |
| 4 | 2 500 | преграда северна лента / коридор (южна страна) |
| 5 | 3 600 | преграда коридор / спални (северна страна) |
| 6 | 3 750 | преграда коридор / спални (южна страна) |
| 7 | 7 850 | вътрешна повърхност на южната стена |
| 8 | 8 200 | външна фасада юг |

Допълнително, само за антрето: `y = 2 450` (северна страна на антрейната стена),
`y = 2 570` (южна страна).

---

## 5. Полезна площ по зони

| Зона | m² | Дял |
|---|---|---|
| Дневна (хол, трапезария, кухня) | 30,8 | 38 % |
| Спални | 25,8 | 32 % |
| Мокри (баня + мокро) | 12,6 | 16 % |
| Циркулация (коридор + антре) | 11,1 | 14 % |
| **Общо** | **80,3** | 100 % |

Циркулация ~14 % е нормална стойност за компактна едноетажна къща. Под 10 % се
постига само ако спалните се отварят директно към дневната зона.

---

## 6. Обем и височина (за ориентир)

| Параметър | Стойност |
|---|---|
| Светла височина | 2,80–3,00 m (по избор) |
| Височина на стената до стрехата | ~3,20–3,50 m (следва модула на ICF блока) |
| Наклон на покрива | 20–30° (по ПУП и съседна застройка) |

Точната височина на стената се определя от **височината на ICF блока** — стената се
изгражда на цял брой редове. Това се уточнява с производителя/изпълнителя.

---

**Виж още:** [концептуален план](./01-concept-plan.md) · [дограма](./03-openings.md) ·
[диаграми](./04-diagrams.md)
