metodiev/nikolaevo-house/architecture/04-diagrams.md

# Диаграми

Схематични диаграми към концепцията. Рендират се директно в GitHub и в VS Code
(Markdown Preview). Чертежите в мащаб са в [plans/](./plans).

---

## 1. Зониране

Геометричното разположение е в [плана 1:100](./plans/floor-plan.svg). Тази диаграма
показва йерархията зона → лента → помещения.

```mermaid
flowchart TB
    K["ЕДНОЕТАЖНА ICF КЪЩА<br/>98,4 m² застроена · ≈ 80,3 m² чиста"]

    K --> W["ЗАПАДНА ЗОНА — 6,45 m<br/>спални и обслужване"]
    K --> E["ИЗТОЧНА ЗОНА — 4,70 m<br/>дневна"]

    W --> W1["северна лента · 2,00 m<br/>баня 6,3 + мокро 6,3 = 12,6 m²"]
    W --> W2["средна лента · 1,10 m<br/>коридор 7,1 m²"]
    W --> W3["южна лента · 4,10 m<br/>спалня 1 + спалня 2 = 25,8 m²"]

    E --> E1["север · кухня ≈ 5,95 m² — отворена"]
    E --> E2["юг · хол + трапезария ≈ 24,8 m²"]
    E --> E3["североизток · антре 4,0 m² — затворено"]

    E1 -.-> E4["ОТВОРЕНО ПРОСТРАНСТВО<br/>хол + кухня = 30,8 m²"]
    E2 -.-> E4
```

---

## 2. Циркулация

```mermaid
flowchart LR
    IN(["ВХОД<br/>изток"]) --> ANT["АНТРЕ<br/>4,0 m²"]
    ANT --> HOL["ХОЛ + ТРАПЕЗАРИЯ + КУХНЯ<br/>30,8 m² отворено"]
    HOL --> KOR["КОРИДОР<br/>7,1 m²"]
    KOR --> SP1["СПАЛНЯ 1<br/>12,9 m²"]
    KOR --> SP2["СПАЛНЯ 2<br/>12,9 m²"]
    KOR --> BANQ["БАНЯ<br/>6,3 m²"]
    KOR --> MOKRO["МОКРО / КИЛЕР<br/>6,3 m²"]
    HOL -.->|"плъзгаща врата"| TER["ТЕРАСА<br/>юг"]
```

Най-дълъг маршрут: вход → антре → хол → коридор → спалня 1 ≈ **9 m**.

---

## 3. Разпределение на чистата площ

```mermaid
pie showData
    title Чиста използваема площ по помещения (m²)
    "Хол + трапезария" : 24.8
    "Спалня 1" : 12.9
    "Спалня 2" : 12.9
    "Коридор" : 7.1
    "Баня" : 6.3
    "Мокро помещение" : 6.3
    "Антре" : 4.0
    "Кухненска зона (в отвореното)" : 5.95
```

---

## 4. Ориентация по фасади

```mermaid
flowchart LR
    subgraph S["ЮГ — 12,0 m фасад"]
        direction TB
        S1["Спалня 1<br/>прозорец 1,50 m"]
        S2["Спалня 2<br/>прозорец 1,50 m"]
        S3["Хол<br/>плъзгаща врата 2,80 m"]
    end
    subgraph N["СЕВЕР — 12,0 m фасад"]
        direction TB
        N1["Баня<br/>0,60 m, високо"]
        N2["Мокро помещение<br/>0,60 m, високо"]
        N3["Кухня<br/>1,20 m над плот"]
        N4["Антре<br/>входна врата + навес"]
    end
```

| Фасада | Отвори | Площ на стъклото | Стратегия |
|---|---|---|---|
| Юг | 3 броя | ≈ 10,5 m² | максимум светлина + задължително засенчване |
| Север | 3 малки + вход | ≈ 2,2 m² | минимум загуби, вентилация |
| Изток | вход + 1 прозорец | ≈ 2,2 m² | сутрешна светлина |
| Запад | 0–1 малък | 0–1,4 m² | защита от следобедно слънце |

---

## 5. Площна сметка (от застроена към чиста)

```mermaid
flowchart LR
    A["Застроена площ<br/>98,40 m²"] -->|"− 13,65 m²<br/>външни ICF стени"| B["Вътрешна площ<br/>84,75 m²"]
    B -->|"− 4,43 m²<br/>преградни стени"| C["Чиста използваема<br/>≈ 80,3 m²"]
```

---

## 6. Ориентировъчно разпределение на разходите

Средни стойности от диапазона в [бюджета](../budget/01-cost-estimate.md) — **само за
илюстрация на пропорциите**, не са оферта.

```mermaid
pie showData
    title Дял на разходите (средни стойности, хил. €)
    "Фундаменти и подова плоча" : 17.5
    "ICF стени" : 19.5
    "Покрив" : 15.5
    "Дограма" : 11.5
    "Инсталации" : 17.5
    "Довършителни работи" : 22.5
```

Общо ≈ 104 000 € — в средата на диапазона 72 000 – 136 000 €.

---

## 7. Алтернативи, които бяха разгледани

| Вариант | Площ | Причина да не се избере |
|---|---|---|
| 12,00 × 8,00 m, вход от север | 96,0 m² | не отговаря на достъпа от изток |
| 12,00 × 8,00 m, вход от изток | 96,0 m² | отвореното пространство пада на ~27 m² (под 30) |
| 11,00 × 8,00 m | 88,0 m² | хол + кухня ~29 m² или спални под 11 m² |
| 12,30 × 8,00 m | 98,4 m² | равностойно; по-дълъг фасад, по-плитки стаи |
| **12,00 × 8,20 m** | **98,4 m²** | **избран** — по-добри пропорции на стаите |
| Спални, отворени към хола | ~93 m² | губи се приватност и звукоизолация |
