metodiev/nikolaevo-house/documentation/01-design-brief.md

# Задание за проектанта

Едноетажна, самостоятелна ICF къща · Николаево

Този документ е кратко задание за архитект/проектант. Описва **какво искаме**, кое е
вече решено и кое оставяме за професионална преценка.

---

## 1. Обект

| Параметър | Изискване |
|---|---|
| Тип | едноетажна, самостоятелна, еднофамилна къща |
| Конструкция | ICF (изолирани бетонни кофражни) панели |
| Застроена площ | 75–99 m²; **предложено 98,4 m²** |
| Форма | максимално правоъгълна, без сложни ъгли и криви |
| Спални | 2, двете с южно изложение |
| Бани | 1 баня |
| Мокро помещение | 1 малко (пералня + съхранение + техника) |
| Хол + кухня | отворено пространство, **≥ 30 m²** |
| Покрив | двускатен, просто решение |

## 2. Парцел

| Данни | Статус |
|---|---|
| Местоположение | Николаево |
| Достъп | **от изток** (улица/алея) |
| Размери и граници | **неизвестни** — по кадастрална скица |
| Отстояния по ПУП | **неизвестни** — за проверка |
| Геология / подпочвени води | **неизвестни** — нужен сондаж |
| Ориентация на парцела | север–юг (приема се) |

## 3. Функционална програма

| Помещение | Изискване | В концепцията |
|---|---|---|
| Хол + трапезария | отворено с кухнята | ≈ 24,8 m² |
| Кухня | отворена към хола | ≈ 5,95 m² под + плотове |
| **Общо хол + кухня** | **≥ 30 m²** | **30,8 m²** |
| Спалня 1 | юг | 3,15 × 4,10 = 12,9 m² |
| Спалня 2 | юг | 3,15 × 4,10 = 12,9 m² |
| Баня | душ/WC/мивка + шкаф | 3,15 × 2,00 = 6,3 m² |
| Мокро помещение / килер | пералня, сушилня, съхранение, техника | 3,15 × 2,00 = 6,3 m² |
| Антре | вход от изток, гардероб | 1,90 × 2,10 = 4,0 m² |
| Коридор | достъп до спални и мокри | 6,45 × 1,10 = 7,1 m² |

Няма изискване за гараж, изба или втори етаж. Няма изискване за достъпност за
инвалидни колички — ако се налага, да се предвиди.

## 4. Ориентация и отвори

| Фасада | Изискване |
|---|---|
| **Юг** | спалните и холът; **голяма плъзгаща врата** от хола; стандартни прозорци в спалните |
| **Север** | кухня, баня, мокро помещение; **малки прозорци или само вентилация** |
| **Изток** | вход; допустим прозорец за трапезарията |
| **Запад** | без отвори или един малък (защита от прегряване) |

- Обща площ на остъкляването на юг ≈ 10,5 m² → **задължително външно засенчване**.
- Баня и мокро помещение: малки прозорци на високо ниво + механична вентилация.

Пълна спецификация: [03-openings.md](../architecture/03-openings.md)

## 5. Вече решено (да се запази)

1. Правоъгълна форма, ъгли само 90°.
2. Дългата ос изток–запад, южен фасад 12 m.
3. Вход от изток, антре в североизточния ъгъл.
4. Мокрите функции (кухня, мокро, баня) са групирани по северната стена.
5. Двете спални и холът са на юг.
6. Отвореното пространство хол + кухня е ≥ 30 m² и е без прегради.
7. Покрив: двускатен, било изток–запад.

## 6. Свободно за проектанта

- Точни размери на помещенията (в рамките на ±10 % от концепцията).
- Дебелина и вид на ICF системата (250–400 mm) — с отражение върху чистата площ.
- Конструкция на покрива, наклон, надвеси.
- Позиция и размери на отворите — в рамките на логиката по т. 4.
- Интериорни решения, настилки, цветове.
- Озеленяване и тераса (извън 98,4 m²).
- Отоплителна система и вентилация (в съгласуване с инженер).

## 7. Ограничения и рискове

| Тема | Бележка |
|---|---|
| Площ | 98,4 m² е близо до горната граница 99 m² — **да не се увеличава** |
| Спалня 2 | само един фасад; да се предвиди проветряване през вратата |
| Коридор | ~7,1 m²; да не се увеличава за сметка на стаите |
| ICF | отворите се правят в кофража — да се съобразят с модула на блока |
| Инсталации | не се къртят канали в ICF — да се планират предварително |
| Херметичност | задължителна вентилация с рекуперация |
| Топлинни мостове | изолацията на плочата трябва да е непрекъсната с тази на стената |

## 8. Очаквани резултати от проектанта

- [ ] Проверка на концепцията спрямо ПУП и парцела
- [ ] Идеен проект (планове, разфасади, разрези, визуализация)
- [ ] Технически проект — архитектура
- [ ] Конструктивен проект (с конструктор)
- [ ] Проект ВиК, Ел., ОВК
- [ ] Енергийна характеристика на сградата
- [ ] Количествени сметки за оферти
- [ ] Координация с изпълнител за ICF детайли

## 9. Първи въпроси към проектанта

1. Побира ли се 12,00 × 8,20 m в парцела при отстоянията по ПУП?
2. Какви са изискванията за височина, наклон на покрива и плътност?
3. Коя ICF система препоръчва и каква дебелина?
4. Какъв надвес е нужен за засенчване на южната плъзгаща врата?
5. Каква вентилационна схема е подходяща при тази херметичност?
6. Каква е ориентировъчната цена на проектирането?

---

**Приложения:** [концептуален план](../architecture/01-concept-plan.md) ·
[план 1:100](../architecture/plans/floor-plan.svg) ·
[площи](../architecture/02-areas.md) ·
[дограма](../architecture/03-openings.md) ·
[конструкция](../structure/01-icf-structure.md) ·
[бюджет](../budget/01-cost-estimate.md)
