metodiev/nikolaevo-house/budget/02-turnkey-max.md

# Бюджет „до ключ“ с обзавеждане — таван

Колко **най-много** може да струва къщата, ако се изпълни изцяло — от терена до
мебелите и уредите.

> ## ⚠️ Това е само ориентировъчна стойност, действителната цена зависи от местната оферта.
>
> Числата са **горна граница за планиране**, а не оферта. Реалната цена може да е
> значително по-ниска — виж и [01-cost-estimate.md](./01-cost-estimate.md) за
> диапазона само на строителството.

---

## 1. Отговорът накратко

| Въпрос | Отговор |
|---|---|
| Реалистичен диапазон „до ключ + обзавеждане“ | **≈ 135 000 – 250 000 €** |
| **Таван за планиране (най-високото)** | **≈ 250 000 €** |
| Таван **с верандата** (добавка, виж по-долу) | **≈ 262 000 €** |
| Цена на m² при тавана | ≈ 2 540 €/m² (при 98,4 m²) |
| Дата на оценката | 24.10.2026 |

**250 000 € е цифрата, с която е разумно да се планира**, ако искаш да си
сигурен, че няма да останеш без пари по средата на строежа. Всичко над нея е
резервен буфер.

---

## 2. Разбивка

| № | Позиция | Ниско (€) | Високо (€) | Бележка |
|---|---|---|---|---|
| 1 | Геология, геодезия, проект, разрешение, надзор | 8 000 | 18 000 | проектът е 5–10 % от строежа |
| 2 | Присъединявания (ток, вода, канал) | 3 000 | 10 000 | зависи от разстоянието до мрежите |
| 3 | Изкоп, фундамент, подова плоча | 13 000 | 22 000 | зависи от геологията |
| 4 | ICF стени | 13 000 | 26 000 | виж [icf](../icf) |
| 5 | Покрив | 10 000 | 21 000 | пролет 8,20 m |
| 6 | Дограма | 8 000 | 15 000 | виж [A-03](../architecture/plans/A-03-dograma.svg) |
| 7 | Инсталации (ВиК, ел, ОВК) | 12 000 | 23 000 | виж [electrical](../electrical) |
| 8 | Довършителни (замазки, мазилки, настилки) | 16 000 | 29 000 | |
| 9 | Кухня — мебели и плот | 3 500 | 9 000 | |
| 10 | Кухня — уреди | 2 500 | 9 000 | |
| 11 | Обзавеждане (хол, спални, баня, антре) | 7 000 | 26 000 | виж [furniture](../furniture) |
| 12 | Осветление и текстил | 800 | 3 000 | |
| 13 | Тераса, навес, ограда, двор | 6 000 | 20 000 | извън 98,4 m² |
| | **Междинна сума** | **102 800** | **231 000** | |
| 14 | Непредвидени (≈ 8 %) | 8 200 | 18 500 | **задължително** |
| | **Общо** | **≈ 111 000** | **≈ 250 000** | |

> **Веранда (по избор, извън сумата по-горе).** 14,76 m² отворена дървена
> веранда по цялата източна фасада (навес, подпори, парапет) — ориентировъчно
> **+6 000 – 12 000 €** (≈ 400–800 €/m²). Не е включена в тавана 250 000 €,
> защото е добавка след първоначалната оценка.
> Това е **само ориентировъчна стойност** — действителната цена зависи от
> избраното покритие и местната оферта. Виж
> [architecture/05-veranda.md](../architecture/05-veranda.md). |

Забележка: редовете 9–12 са разбивка на обзавеждането от
[furniture/01-obzavezhdane.md](../furniture/01-obzavezhdane.md).

---

## 3. Какво вдига цената към тавана

| Фактор | Ефект |
|---|---|
| Терен с наклон или високи подпочвени води | +20–40 % на фундамента |
| Липса на ICF екип в района | +20–30 % на труда |
| Троен стъклопакет и алуминий с термомост | дограмата стига горната граница |
| Подово отопление + термопомпа + вентилация с рекуперация | +8 000 – 15 000 € |
| Качествени настилки (естествен камък, масивен паркет) | +5 000 – 12 000 € |
| Кухня по поръчка с вградени уреди | 18 000 € вместо 6 000 € |
| Тераса с настилка и пергола | +8 000 – 15 000 € |
| Ограда, алеи, озеленяване | +5 000 – 12 000 € |
| Фотоволтаици | +6 000 – 12 000 € |
| Дълъг строеж (закъснения, зимни условия) | +5–10 % |

---

## 4. Какво НЕ влиза и в тавана

- Закупуване на парцела
- Данъци, нотариални такси, банкови разходи по кредит
- Допълнителни сгради (гараж, навес за кола, лятна кухня)
- Басейн
- Промени в проекта по време на строежа (те са основната причина за
  преразход — затова се плащат отделно)

---

## 5. Как да не се стигне до тавана

1. **Реши всичко преди да започнеш.** Промяна по време на строеж струва
   3–5 пъти повече от същата промяна на хартия.
2. **Вземи 3 оферти по един и същ обхват** — виж
   [icf/05-sravnenie.md](../icf/05-sravnenie.md).
3. **Договори фиксирана цена** с ясно описан обхват и клауза за непредвидени.
4. **Дръж 10 % резерв** отделно от бюджета и не го пипай до края.
5. **Купи обзавеждането след строежа**, не преди — размерите на стаите се
   уточняват с мазилките и замазката.
6. **Не пести от хидроизолация, покрив и дограма** — това са скъпите ремонти.

---

## 6. Ако бюджетът е под 135 000 €

Реалистичните варианти:

| Вариант | Ефект |
|---|---|
| Намали площта до ~85 m² | −10–15 % от строителството |
| Опростено обзавеждане (IKEA-клас) | −20 000 € спрямо горната граница |
| Откажи се от терасата в първия етап | −8 000 € |
| Направи двора сам, на етапи | −10 000 € |
| Изчакай с фотоволтаиците | −10 000 € |
| Кухня от готови модули | −10 000 € |

**Не намалявай:** фундамента, хидроизолацията, покрива и дограмата.

---

## 7. Контролна таблица

| Етап | Планирано | Договорено | Платено | Остатък |
|---|---|---|---|---|
| Проект и разрешителни | | | | |
| Присъединявания | | | | |
| Фундамент | | | | |
| ICF стени | | | | |
| Покрив | | | | |
| Дограма | | | | |
| Инсталации | | | | |
| Довършителни | | | | |
| Обзавеждане | | | | |
| Двор | | | | |
| **Общо** | | | | |

---

## 8. Източници на несигурност

Изрично **не е сигурно**:

- колко ще струва трудът в конкретния момент;
- дали има ICF екип в района и на каква цена;
- каква е геологията (без сондаж);
- какви са изискванията на ПУП и дали няма да наложат промени;
- какви ще са цените на материалите след 6–12 месеца.

За всичко това **се препоръчва консултация с местен изпълнител** и с проектант,
преди да се фиксира бюджет.

---

**Виж още:** [строителна оценка](./01-cost-estimate.md) ·
[обзавеждане](../furniture/01-obzavezhdane.md) ·
[ICF оферта](../icf/README.md) ·
[отворени въпроси](../documentation/02-open-questions.md)
