metodiev/nikolaevo-house/furniture/01-obzavezhdane.md

# Списък на обзавеждането

Подробен списък по помещения с размери и бележки за покупка.

> Размерите са **типични**, не са поръчкови. При избор на конкретен модел се
> проверява дали се побира в оставащото място (виж [схемите](./plans)).
> Всички размери в mm.

---

## 1. Кухня и трапезария

Помещение: отворена зона 4700 × 7500 (заедно с хола). Кухненският ъгъл е
2680 × 2220 в северната част.

| # | Артикул | Размер | Бр. | Бележка |
|---|---|---|---|---|
| 1.1 | Кухненски плот, северен ред | 1950 × 600 | 1 | под прозореца |
| 1.2 | Кухненски плот, западен ред | 1500 × 600 | 1 | Г-образно свързване |
| 1.3 | Мивка | 700 × 500 | 1 | под прозореца, център ~8050 |
| 1.4 | Котлони (4 зони) | 500 × 500 | 1 | на западен плот, не под прозорец |
| 1.5 | Хладилник | 650 × 700 | 1 | североизточен ъгъл |
| 1.6 | Горни шкафове | 1950 × 300 | 1 | височина 1400–2200 |
| 1.7 | Горни шкафове, западен ред | 1500 × 300 | 1 | височина 1400–2200 |
| 1.8 | Абсорбатор | 600 | 1 | над котлоните |
| 1.9 | Трапезна маса | 1400 × 900 | 1 | западната част на хола, южно от кухнята |
| 1.10 | Стол | 450 × 450 | 6 | по 2 на дългите страни, 1 на челата |

**Проверки:**
- Разстоянието мивка → котлони е ~1300 mm — достатъчно за работна зона.
- Хладилникът е до входа на антрето — отваря се без да пречи.
- Около масата остава ≥ 900 mm за придвижване.
- Северната ивица на хола (**y 2570–3560**) остава свободна — проходът от входа
  към коридора не се блокира от масата и столовете.

---

## 2. Хол

| # | Артикул | Размер | Бр. | Бележка |
|---|---|---|---|---|
| 2.1 | Диван 3-местен | 2200 × 900 | 1 | гръб на изток, срещу ТВ |
| 2.2 | Фотьойл | 850 × 850 | 1 | до източния прозорец |
| 2.3 | Холна маса | 1100 × 600 | 1 | пред дивана |
| 2.4 | ТВ шкаф / плот | 1650 × 400 | 1 | на западната преграда, изтеглен на юг |
| 2.5 | Телевизор | 1400 (55–60″) | 1 | стенен монтаж на преградата |
| 2.6 | Килим | 2100 × 1500 | 1 | под холната маса |
| 2.7 | Растение | ~400 | 1 | югоизточен ъгъл |
| 2.8 | Подова лампа | – | 1 | до фотьойла |

**Проверки:**
- Диван → телевизор: ~2450 mm — подходящо за 55–60″.
- Проходът от антрето към коридора минава по северната ивица на хола
  (y 2570–3560) и е свободен по цялата си дължина.
- Пред плъзгащата врата (юг) остава ≥ 950 mm.

---

## 3. Спалня 1 (3150 × 4100)

| # | Артикул | Размер | Бр. | Бележка |
|---|---|---|---|---|
| 3.1 | Легло 1600 × 2000 | 2000 × 1600 | 1 | табла на източната преграда |
| 3.2 | Нощно шкафче | 450 × 400 | 2 | от двете страни на таблата |
| 3.3 | Гардероб | 1600 × 550 | 1 | плъзгащи врати, северна стена |
| 3.4 | Килим | 700 × 1200 | 1 | до леглото |

**Проверки:**
- Леглото е до таблата на преградата — без прозорец зад главата.
- Гардеробът е извън зоната на вратата (врата на x 900–1800).
- Проходът западно от леглото е ~1150 mm; пред гардероба — ~450 mm.
- Скрин няма — съхранението е изцяло в гардероба.

---

## 4. Спалня 2 (3150 × 4100)

| # | Артикул | Размер | Бр. | Бележка |
|---|---|---|---|---|
| 4.1 | Легло 1600 × 2000 | 2000 × 1600 | 1 | табла на западната стена |
| 4.2 | Нощно шкафче | 400 × 450 | 2 | от двете страни на таблата |
| 4.3 | Гардероб | 1200 × 550 | 1 | плъзгащи врати, североизточен ъгъл |

**Проверки:**
- Вратата (x 4700–5600) се отваря в стаята без да удря леглото.
- Проходът източно от леглото е ~1150 mm; пред гардероба — ~450 mm.
- Скрин няма — съхранението е изцяло в гардероба.

---

## 5. Баня (3150 × 2000)

| # | Артикул | Размер | Бр. | Бележка |
|---|---|---|---|---|
| 5.1 | Душ с корито | 1200 × 900 | 1 | северозападен ъгъл |
| 5.2 | Душ параван (стъкло) | 1200 | 1 | |
| 5.3 | Тоалетна чиния | 400 × 800 | 1 | до западната стена |
| 5.4 | Мивка с шкаф | 1000 × 500 | 1 | срещу вратата, южна стена |
| 5.5 | Огледало | 1000 | 1 | над мивката |
| 5.6 | Дръжка за кърпи | 600 | 1 | |

**Проверки:**
- Вратата се отваря в банята без да удря мивката.
- Душът е далеч от вратата.
- Прозорецът е на високо ниво (подпрозорец 1600) — над душ зоната.

---

## 6. Мокро помещение / килер (3150 × 2000)

| # | Артикул | Размер | Бр. | Бележка |
|---|---|---|---|---|
| 6.1 | Пералня | 600 × 600 | 1 | до прозореца |
| 6.2 | Сушилня | 600 × 600 | 1 | до пералнята |
| 6.3 | Плот с мивка | 1300 × 600 | 1 | източен край |
| 6.4 | Стелаж | 400 × 400 | 1 | западна стена |
| 6.5 | Бойлер / термопомпа | 600 × 600 | 1 | югоизточен ъгъл |
| 6.6 | Вентилационен агрегат | 600 × 600 | 1 | на стена, височина > 1800 |

**Проверки:**
- Пералнята и сушилнята са близо до прозореца — вентилация.
- Бойлерът е до източния ъгъл — къс път до мивката и банята.
- Вратата се отваря в помещението; свободната зона пред нея е запазена.

---

## 7. Антре (1900 × 2100)

| # | Артикул | Размер | Бр. | Бележка |
|---|---|---|---|---|
| 7.1 | Гардероб за връхни дрехи | 900 × 400 | 1 | западна стена |
| 7.2 | Пейка за обувки | 500 × 450 | 1 | под гардероба |
| 7.3 | Огледало | 500 × 900 | 1 | до вратата |
| 7.4 | Електрическо табло | 500 × 250 | 1 | южна стена, височина 1400–1800 |

---

## 8. Обобщено — ориентировъчен бюджет на обзавеждането

Само за планиране. Реалните цени зависят от марката и модела.

| Група | Ниско (€) | Високо (€) |
|---|---|---|
| Кухня — мебели и плот | 3 500 | 9 000 |
| Кухня — уреди | 2 500 | 9 000 |
| Трапезария — маса и столове | 800 | 3 000 |
| Хол — диван, фотьойл, маси | 1 800 | 7 000 |
| Спални — легла, гардероби, шкафове | 2 500 | 9 000 |
| Баня — санитария и мебели | 1 500 | 5 000 |
| Мокро — пералня, сушилня, стелажи | 1 200 | 3 500 |
| Антре — гардероб, пейка, огледало | 400 | 1 500 |
| Осветление и текстил | 800 | 3 000 |
| **Общо** | **15 000** | **50 000** |

Пълният бюджет „до ключ“: [budget/02-turnkey-max.md](../budget/02-turnkey-max.md)

---

**Виж още:** [схеми](./plans) · [бюджет](../budget/02-turnkey-max.md) ·
[електро](../electrical/01-elektro-plan.md)
