metodiev/nikolaevo-house/icf/02-steni-i-otvori.md

# Стени и отвори

Пълна таблица на ICF стените и отворите в тях. Това е основният документ, по
който доставчикът калкулира.

> Всички размери са в **mm**. Височините се мерят от кота ±0,00 (готов под).
> Скиците са в [plans/](./plans): [план](./plans/icf-plan.svg) ·
> [фасади](./plans/icf-elevations.svg).

---

## 1. Стени

| Код | Стена | Дължина | Височина | Дебелина | Отвори | Мерени от |
|---|---|---|---|---|---|---|
| **W1** | Южна | 12 000 | 3 000 | 350 | O1, O2, O3 | западен ъгъл |
| **W2** | Северна | 12 000 | 3 000 | 350 | O4, O5, O6 | западен ъгъл |
| **W3** | Западна | 8 200 | 3 000 | 350 | O9 *(опция)* | северен ъгъл |
| **W4** | Източна | 8 200 | 3 000 | 350 | O7, O8 | северен ъгъл |

Дължините са по **външния габарит** на сградата. При изчисляване по оста на
стената: 2 × (11 650 + 7 850) = **39 000 mm**.

---

## 2. Отвори

`Отстъп` е разстоянието от референтния ъгъл на стената до **началото** на отвора
(виж колоната „Мерени от“ в таблицата на стените).

| Код | Стена | Отстъп | Ширина | Височина | Подпрозорец | Горен ръб | Площ | Вид |
|---|---|---|---|---|---|---|---|---|
| **O1** | W1 | 1 175 | 1 500 | 1 400 | 800 | 2 200 | 2,10 m² | прозорец — спалня 1 |
| **O2** | W1 | 4 475 | 1 500 | 1 400 | 800 | 2 200 | 2,10 m² | прозорец — спалня 2 |
| **O3** | W1 | 7 900 | 2 800 | 2 250 | 0 | 2 250 | 6,30 m² | **плъзгаща врата** — хол |
| **O4** | W2 | 1 625 | 600 | 600 | 1 600 | 2 200 | 0,36 m² | прозорец — баня |
| **O5** | W2 | 4 925 | 600 | 600 | 1 500 | 2 100 | 0,36 m² | прозорец — мокро помещение |
| **O6** | W2 | 7 690 | 1 200 | 1 400 | 1 000 | 2 400 | 1,68 m² | прозорец — кухня |
| **O7** | W4 | 700 | 1 050 | 2 100 | 0 | 2 100 | 2,21 m² | **входна врата** |
| **O8** | W4 | 3 500 | 1 600 | 1 400 | 800 | 2 200 | 2,24 m² | прозорец — трапезария |
| **O10** | W4 | 5 900 | 1 400 | 1 400 | 800 | 2 200 | 1,96 m² | прозорец — хол, югоизток |
| **O9** | W3 | 5 200 | 1 000 | 1 400 | 800 | 2 200 | 1,40 m² | прозорец — спалня 1 *(опция)* |

**Сумарно:** 9 отвора = **19,31 m²** · опция O9 = 1,40 m²

---

## 3. Проверка на размерните вериги

Всяка верига трябва да дава дължината на стената — това е контрола срещу
грешка в координатите.

**W1 (юг), от запад:**
1 175 + 1 500 + 1 800 + 1 500 + 1 925 + 2 800 + 1 300 = **12 000** ✓

**W2 (север), от запад:**
1 625 + 600 + 2 700 + 600 + 2 165 + 1 200 + 3 110 = **12 000** ✓

**W4 (изток), от север:**
700 + 1 050 + 1 750 + 1 600 + 800 + 1 400 + 900 = **8 200** ✓

**W3 (запад), от север:**
5 200 + 1 000 + 2 000 = **8 200** ✓

---

## 4. Сечение на стената

| № | Слой (отвън навътре) | Дебелина |
|---|---|---|
| 1 | външно фасадно покритие | ~20 mm |
| 2 | EPS — външен слой на блока | ~80 mm |
| 3 | стоманобетонно ядро + армировка | ~150 mm |
| 4 | EPS — вътрешен слой на блока | ~80 mm |
| 5 | вътрешна мазилка | ~20 mm |
| | **общо** | **≈ 350 mm** |

Дебелините на EPS и ядрото се **уточняват по конкретната система**. Дадените
стойности са работно допускане, не изискване.

---

## 5. Какво да НЕ се включва

| Елемент | Защо |
|---|---|
| Вътрешни прегради | не са ICF — газобетон / гипсокартон |
| Фронтони над кота +3000 | лека конструкция |
| Фундамент и подова плоча | друг изпълнител |
| Подпрозоръчни первази | част от дограмата |
| Дограма | отделна поръчка |

---

## 6. За доставчика — какво да върне

- [ ] Потвърждение на дебелината и модула на вашата система
- [ ] Схема за подреждане на блоковете (ако се различава от типовата)
- [ ] Указание за клас и консистенция на бетона
- [ ] Указание за армировката (за конструктора)
- [ ] Начин на изпълнение на надгредата над O3 (2 800 mm)
- [ ] Решение на ъглите и на ръбовете на отворите
- [ ] Количество и цена по позиции

---

**Виж още:** [задание](./01-zadanie.md) · [количества](./03-kolichestva.md) ·
[въпроси](./04-vaprosi.md) · [план](./plans/icf-plan.svg) ·
[фасади](./plans/icf-elevations.svg)
