metodiev/nikolaevo-house/icf/03-kolichestva.md

# Количества

Ориентировъчни количества за калкулация на офертата.

> **Всичко тук е изчислено по геометрията на концепцията, а не по работен
> проект.** Формулите са показани, за да може доставчикът да провери и коригира
> със своите данни. Окончателните количества се валидират от доставчика.

---

## 1. Обобщена таблица

| № | Позиция | Формула | Стойност | Мерна единица |
|---|---|---|---|---|
| 1 | Външен контур | 2 × (12,00 + 8,20) | **40,40** | m |
| 2 | Контур по ос на стената | 2 × (11,65 + 7,85) | **39,00** | m |
| 3 | Височина на стената | – | **3,00** | m |
| 4 | Брутна площ на стените (по ос) | 39,00 × 3,00 | **117,00** | m² |
| 5 | Площ на отворите (9 бр.) | виж т. 2 | **19,31** | m² |
| 6 | **Нетна площ ICF стена** | 117,00 − 19,31 | **≈ 97,69** | m² |
| 7 | Бетон в ядрото | 97,69 × 0,15 | **≈ 14,65** | m³ |
| 8 | EPS в стените (2 × 80 mm) | 97,69 × 0,16 | **≈ 15,63** | м³ |
| 9 | Външни ъгли 90° | – | **4** | бр. |
| 10 | Вертикални ръбове на отвори | 9 отвора × 2 | **18** | бр. |
| 11 | Отвори — общо | 9 + 1 опция | **9 (+1)** | бр. |

---

## 2. Площ на отворите

| Код | Ширина (m) | Височина (m) | Площ (m²) |
|---|---|---|---|
| O1 | 1,50 | 1,40 | 2,10 |
| O2 | 1,50 | 1,40 | 2,10 |
| O3 | 2,80 | 2,25 | 6,30 |
| O4 | 0,60 | 0,60 | 0,36 |
| O5 | 0,60 | 0,60 | 0,36 |
| O6 | 1,20 | 1,40 | 1,68 |
| O7 | 1,05 | 2,10 | 2,21 |
| O8 | 1,60 | 1,40 | 2,24 |
| O10 | 1,40 | 1,40 | 1,96 |
| | | **Сума** | **19,31** |
| O9 *(опция)* | 1,00 | 1,40 | 1,40 |

---

## 3. Брой блокове — само ориентир

Броят зависи изцяло от модула на конкретната система.

**Пример** при блок 0,50 × 0,25 m (0,125 m² лицева площ):

```
97,69 m² ÷ 0,125 m²/блок ≈ 782 блока
+ отпадък от рязане (обикновено 5–10 %) → ≈ 820–860 блока
```

**Това НЕ е поръчково количество.** Доставчикът изчислява по своя модул и по
схемата за подреждане. От нас се иска да посочи:

- точен брой по вид елемент;
- процент отпадък, който прилага;
- брой ъглови, челни и затварящи елементи.

---

## 4. Брой курсове

При модул **0,25 m** по височина:

```
3,00 m ÷ 0,25 m = 12 курса
```

При друг модул броят курсове е различен. Височината 3,00 m е избрана така, че да
се дели на 0,25 — ако вашата система е с друг модул, посочете най-близката
възможна височина.

---

## 5. Бетон и армировка

| Позиция | Стойност | Забележка |
|---|---|---|
| Обем на бетона в ядрото | ≈ 14,7 m³ | по нетна площ × 0,15 m |
| Клас на бетона | **не е определен** | по конструктивен проект |
| Армировка | **не е изчислена** | по конструктивен проект |
| Консистенция / максимална фракция | **не е определена** | по указание на доставчика |

Обемът включва и участъците над отворите (надгреди), защото нетната площ е
изчислена като брутна минус отворите — ивицата над всеки отвор остава в сметката.

**Армировката не се оценява тук.** Тя е задължение на конструктора и не трябва
да влиза в офертата на доставчика на блокове, освен ако изрично не е договорено.

---

## 6. Фронтони (габъли) — извън обхвата

| Параметър | Стойност |
|---|---|
| Основа на фронтона | 8,20 m |
| Височина при наклон 25° | ≈ 1,91 m |
| Площ на един фронтон | ≈ 7,8 m² |
| Два фронтона | ≈ 15,7 m² |

**Не е включено** в количествата по-горе. Ако се изпълнят с ICF — да се оферират
отделно.

> Височината на фронтона зависи от наклона на покрива, който **не е уточнен** с
> ПУП. Числото е ориентировъчно.

---

## 7. Контролна сметка

Ако доставчикът получи различно число, причината може да е в:

| Причина | Ефект |
|---|---|
| Друга дебелина на стената | промяна на контура по ос и на чистата площ |
| Друга височина (различен модул) | правопропорционална промяна на брутната площ |
| Мерене по външен контур вместо по ос | +3,6 % (40,40 вместо 39,00 m) |
| Включване на фронтоните | +15,7 m² |
| Включване на вътрешни прегради | **неправилно** — те не са ICF |

**Моля, посочете по кой начин мерите**, за да е сравнимо с други оферти.

---

**Виж още:** [задание](./01-zadanie.md) · [стени и отвори](./02-steni-i-otvori.md) ·
[въпроси](./04-vaprosi.md)
