metodiev/nikolaevo-house/icf/04-vaprosi.md

# Въпросник към доставчика

Изпраща се заедно с офертата. Целта е да се сравнят оферти при **еднакви
допускания** — иначе най-ниската цена често е най-скъпата.

Моля, отговорете писмено. Ако нещо не е приложимо — напишете „не“.

---

## 1. Система

| # | Въпрос | Отговор |
|---|---|---|
| 1.1 | Търговско име и производител на системата | |
| 1.2 | Дебелина на стената (mm) | |
| 1.3 | Дебелина на външния / вътрешния EPS (mm) | |
| 1.4 | Дебелина на бетонното ядро (mm) | |
| 1.5 | Модул на блока: дължина × височина (mm) | |
| 1.6 | Има ли ляво/дясно ориентирани елементи | |
| 1.7 | Температурен клас на EPS | |
| 1.8 | Има ли добавка срещу насекоми / гризачи | |
| 1.9 | Реакция на огън (клас по EN 13501-1) | |
| 1.10 | Топлопроводимост λ на системата (W/m·K) | |
| 1.11 | Колко години системата е на пазара в България | |
| 1.12 | Референтни обекти в района (адреси или снимки) | |

---

## 2. Доставка

| # | Въпрос | Отговор |
|---|---|---|
| 2.1 | Срок от поръчка до доставка (седмици) | |
| 2.2 | Минимално количество за поръчка | |
| 2.3 | Включен ли е транспортът до обекта | |
| 2.4 | Начин на разтоварване (кран, ръчно) | |
| 2.5 | Условия за съхранение на обекта | |
| 2.6 | Процент отпадък, който прилагате в сметката | |
| 2.7 | Могат ли да се поръчат допълнително малки количества | |

---

## 3. Монтаж

| # | Въпрос | Отговор |
|---|---|---|
| 3.1 | Предлагате ли монтаж с ваш екип | |
| 3.2 | Цена за м² монтаж | |
| 3.3 | Колко души и колко дни за ≈ 100 m² стена | |
| 3.4 | Как се осигурява вертикалността на първия ред | |
| 3.5 | Как се решават ъглите (ъглови блокове или рязане) | |
| 3.6 | Как се оформят ръбовете на отворите | |
| 3.7 | Как се изпълнява надгреда над отвор 2 800 mm | |
| 3.8 | Как се укрепва кофражът срещу изкривяване при бетониране | |
| 3.9 | Максимална височина на един етап на бетониране | |
| 3.10 | Давате ли схема за подреждане на блоковете | |

---

## 4. Бетон и армировка

| # | Въпрос | Отговор |
|---|---|---|
| 4.1 | Клас бетон, който препоръчвате | |
| 4.2 | Максимална фракция на добавъчните материали | |
| 4.3 | Консистенция (слягане / клас) | |
| 4.4 | Изисквания към вибрирането | |
| 4.5 | Диаметър и стъпка на вертикалната армировка | |
| 4.6 | Диаметър и брой на хоризонталната армировка в ред | |
| 4.7 | Допълнителна армировка около отворите | |
| 4.8 | Допълнителна армировка в ъглите | |
| 4.9 | Нужна ли е армировка в надгредата над O3 | |
| 4.10 | Има ли изискване за защитен слой на бетона | |

---

## 5. Цени

Моля, попълнете **по позиции**. Обща сума без разбивка не може да се сравни.

| # | Позиция | Единица | Количество | Ед. цена | Общо |
|---|---|---|---|---|---|
| 5.1 | Прави блокове | m² стена | ≈ 97,69 | | |
| 5.2 | Ъглови елементи | бр. | 4 | | |
| 5.3 | Челни / затварящи елементи | бр. | 16 | | |
| 5.4 | Елементи за надгреда | m | ≈ 10,85 | | |
| 5.5 | Транспорт до обекта | курс | 1 | | |
| 5.6 | Монтаж | m² | ≈ 97,69 | | |
| 5.7 | **Опция O9** (доп. прозорец) | бр. | 1 | | |
| 5.8 | Фронтони с ICF (по избор) | m² | ≈ 15,7 | | |
| | **Общо** | | | | |

Дължината по 5.4 е сумата от ширините на 8-те отвора (10,85 m) — ориентировъчно.

---

## 6. Търговски условия

| # | Въпрос | Отговор |
|---|---|---|
| 6.1 | Валидност на офертата | |
| 6.2 | Начин на плащане | |
| 6.3 | Авансово плащане (%) | |
| 6.4 | Гаранция — срок | |
| 6.5 | Какво покрива гаранцията | |
| 6.6 | Кой отговаря при дефект в блока | |
| 6.7 | Кой отговаря при грешка в монтажа | |
| 6.8 | ДДС включено ли е | |

---

## 7. Свободни бележки на доставчика

_(място за вашите коментари, резерви и алтернативни предложения)_

---

## 8. Какво правим ние след това

1. Попълваме [05-sravnenie.md](./05-sravnenie.md) с всички получени оферти.
2. Сравняваме **при еднакъв обхват** — ако някоя оферта включва повече или помалко, коригираме.
3. Избираме доставчик и го въвеждаме в проекта през проектанта.
4. Финалните количества се потвърждават по работен проект.

---

**Виж още:** [задание](./01-zadanie.md) · [стени и отвори](./02-steni-i-otvori.md) ·
[количества](./03-kolichestva.md)
