metodiev/nikolaevo-house/icf/05-sravnenie.md

# Сравнение на оферти

Работен документ за теб — не се изпраща на доставчиците.

> Попълва се след като получиш офертите. Целта е да се сравни **един и същ
> обхват**, а не обща сума.

---

## 1. Кой е в обхвата

| Критерий | Доставчик A | Доставчик B | Доставчик C |
|---|---|---|---|
| Име на фирмата | | | |
| Система / производител | | | |
| Дебелина на стената (mm) | | | |
| Брутна площ, която оферира (m²) | | | |
| Включва ли транспорт | | | |
| Включва ли монтаж | | | |
| Включва ли ъглови елементи | | | |
| Включва ли челни елементи | | | |
| Включва ли надгреди | | | |
| Включва ли опция O9 | | | |
| Включва ли фронтони | | | |
| Срок на доставка | | | |
| Гаранция | | | |
| Валидност на офертата | | | |

**Правило:** ако някоя оферта не включва позиция, която другите включват —
добави приблизителна стойност, преди да сравниш общите суми.

---

## 2. Цени по позиции

| Позиция | Ед. | Кол. | A — ед. цена | A — общо | B — ед. цена | B — общо | C — ед. цена | C — общо |
|---|---|---|---|---|---|---|---|---|
| Прави блокове | m² | ≈ 97,69 | | | | | | |
| Ъглови елементи | бр. | 4 | | | | | | |
| Челни елементи | бр. | 16 | | | | | | |
| Елементи за надгреда | m | ≈ 10,85 | | | | | | |
| Транспорт | курс | 1 | | | | | | |
| Монтаж | m² | ≈ 97,69 | | | | | | |
| Опция O9 | бр. | 1 | | | | | | |
| Фронтони *(по избор)* | m² | ≈ 15,7 | | | | | | |
| **Общо** | | | | | | | | |
| **Цена на m² стена** | €/m² | | | | | | | |

Цената на m² е най-добрият пряк показател, но само ако обхватът е еднакъв.

---

## 3. Качествени критерии

Оценка по скала 1–5 (5 = най-добре). Обоснови всяка оценка с факт от офертата.

| Критерий | Тежест | A | B | C |
|---|---|---|---|---|
| Пълнота на офертата (всички позиции) | ×3 | | | |
| Яснота на техническите данни | ×2 | | | |
| Опит с ICF в района (референтни обекти) | ×3 | | | |
| Наличие на собствен монтажен екип | ×2 | | | |
| Качество на документацията (схеми, инструкции) | ×2 | | | |
| Срок на доставка | ×2 | | | |
| Гаранция и условия | ×2 | | | |
| Комуникация по време на запитването | ×1 | | | |
| **Претеглена оценка** | | | | |

---

## 4. Червени флагове

Отбележи, ако е налично:

| Сигнал | A | B | C |
|---|---|---|---|
| Дава само обща сума без разбивка | | | |
| Не посочва дебелина и модул | | | |
| Не дава сертификати | | | |
| Няма референтни обекти | | | |
| Оферира вътрешни прегради като ICF (неправилно) | | | |
| Оферира фронтони без да е поискано | | | |
| Цена значително под останалите | | | |
| Отказва да отговори на въпросника | | | |
| Иска голям аванс без гаранция | | | |
| Няма писмена гаранция | | | |

Цена значително под останалите обикновено означава **различен обхват**, а не
по-добра сделка.

---

## 5. Въпроси преди подписване

- [ ] Всички допускания са записани в офертата (дебелина, модул, клас бетон)
- [ ] Ясно е кой носи отговорност при дефектен блок
- [ ] Ясно е кой носи отговорност при грешен монтаж
- [ ] Срокът е обвързан с готовността на фундамента
- [ ] Условията за плащане са разумни
- [ ] Гаранцията е писмена
- [ ] Количествата ще се актуализират по работен проект
- [ ] Проектантът е запознат с избраната система

---

## 6. Решение

| | |
|---|---|
| Избран доставчик | |
| Основание | |
| Дата | |
| Следваща стъпка | въвеждане на системата в проекта при проектанта |

---

**Виж още:** [задание](./01-zadanie.md) · [количества](./03-kolichestva.md) ·
[въпросник](./04-vaprosi.md) · [бюджет](../budget/01-cost-estimate.md)
