metodiev/nikolaevo-house/electrical/01-elektro-plan.md

# Електроинсталация

Концептуален план на електрическата инсталация — разположение на контакти,
ключове, осветление и табло, плюс едносхемна схема.

> Това е **концепция за разполагане**, не работен проект. Оразмеряването на
> кабелите, защитите и сеченията се прави от **лицензиран проектант** по
> действащите норми, съгласувано с ЕРП.

---

## Схеми

| Лист | Съдържание | Мащаб |
|---|---|---|
| [E-01-plan.svg](./plans/E-01-plan.svg) | план на контактите, ключовете и осветлението | 1:75 |
| [E-02-tablo.svg](./plans/E-02-tablo.svg) | едносхемна схема на таблото + кръгове | без мащаб |

PNG версии: [images/](./images).

---

## Къде е таблото

**В антрето, на южната стена, западно от вратата към хола.**
Координати: x ≈ 9850–10350, y = 2450 (на стената). Височина на монтаж
**1400–1800 mm** от готовия под.

Защо там:

| Причина | Обяснение |
|---|---|
| Близо до входа | къс въвод, лесен достъп при авария |
| Вътрешна стена | не е на външната ICF стена — по-лесно обслужване |
| Сухо помещение | не е в мокрото помещение |
| До вратата | вижда се веднага при влизане |
| Извън пътя | не пречи на гардероба и пейката |

**Резерв:** ако предпочиташ таблото в мокрото помещение — възможно е, но там е
влажно и далеч от входа. Не се препоръчва.

---

## Кръгове (концепция)

| № | Кръг | Защита | Кабел |
|---|---|---|---|
| C1 | Осветление — спални, баня, мокро | 10 A | 1,5 mm² |
| C2 | Осветление — хол, кухня, антре, вън | 10 A | 1,5 mm² |
| C3 | Контакти — хол и трапезария | 16 A | 2,5 mm² |
| C4 | Контакти — кухня (плот) | 16 A | 2,5 mm² |
| C5 | Кухня — фурна и котлони | 16 A | 2,5 mm² |
| C6 | Контакти — спални | 16 A | 2,5 mm² |
| C7 | Баня + мокро (пералня, сушилня) | 16 A | 2,5 mm² |
| C8 | Бойлер / термопомпа | 16 A | 2,5 mm² |
| C9 | Вентилация с рекуперация | 10 A | 1,5 mm² |
| C10 | Външни контакти и осветление | 16 A | 2,5 mm² |
| C11–C12 | Резерв | 16 A | 2,5 mm² |

Табло: главен прекъсвач 40 A / 3P, защита от пренапрежение тип 2, две
дефектнотокови защити 40 A / 30 mA — ДЗТ 1 за общите кръгове, ДЗТ 2 за мокрите
помещения и външните консуматори.

**Сеченията и стойностите са ориентировъчни.** Окончателните се определят от
проектант по натоварване и дължина на трасетата.

---

## Брой точки по помещения

| Помещение | Контакти | Ключове | Осветление | Друго |
|---|---|---|---|---|
| Кухня | 5 двойни + 2 единични | 1 | 2 таванни + 1 акцент | – |
| Хол / трапезария | 5 двойни | 2 | 2 таванни | ТВ + LAN |
| Спалня 1 | 3 двойни | 1 | 1 таванно | ТВ |
| Спалня 2 | 3 двойни | 1 | 1 таванно | – |
| Баня | 1 (IP44) | 1 (отвън) | 1 таванно + 1 акцент | вентилатор |
| Мокро | 2 (IP44) + 1 | 1 | 1 таванно | вентилатор, бойлер |
| Антре | – | 1 | 1 таванно | табло, звънец |
| Вън | 2 (IP44) | – | 1 | – |

---

## Специфика при ICF

1. **В ICF стена не се къртят канали.** Всички трасета минават в преградите,
   в замазката и в окачения таван.
2. Контакти и ключове на **външните стени** изискват предварително заложени
   тръби в кофража — това се съгласува с ICF доставчика **преди бетонирането**.
3. Таблото е на **вътрешна преграда** — това е удобство, не случайност.
4. Вентилацията с рекуперация има собствен кръг и място в мокрото помещение.

---

## Какво трябва да потвърди проектантът

- [ ] Отделена мощност и вид на въвеждането (монофазно / трифазно)
- [ ] Сечения на кабелите по всеки кръг
- [ ] Номинали на автоматичните прекъсвачи
- [ ] Селективност между главния прекъсвач и ДЗТ
- [ ] Необходимост от защита от пренапрежение и нейния тип
- [ ] Заземителна инсталация и мярка за съпротивление
- [ ] Съгласуване с ЕРП

Пълен списък на отворените въпроси: [documentation/02-open-questions.md](../documentation/02-open-questions.md)

---

## Как се генерират

```bash
python electrical/generate_electrical.py     # SVG в plans/
python tools/export_png.py electrical        # PNG в images/
```

---

**Виж още:** [обзавеждане](../furniture) ·
[концептуален план](../architecture/01-concept-plan.md) ·
[ICF конструкция](../structure/01-icf-structure.md) ·
[бюджет](../budget/02-turnkey-max.md)
