metodiev/nikolaevo-house/documentation/02-open-questions.md

# Отворени въпроси

Чеклист на липсващата информация и на нещата, които трябва да се проверят, преди
концепцията да стане проект.

Означения: ❓ неизвестно · ⚠️ проверка · ⬜ за решение

---

## 1. Парцел

| # | Въпрос | Статус | Кой отговаря |
|---|---|---|---|
| 1.1 | Точни размери и граници на парцела | ❓ | кадастрална скица |
| 1.2 | Лице към улицата и посока на достъпа (приема се изток) | ⚠️ | документи |
| 1.3 | Отстояния от границите по ПУП | ❓ | община / проектант |
| 1.4 | Максимална височина, кота 0,00, плътност, КИНТ | ❓ | ПУП |
| 1.5 | Изисквания за наклон и вид на покрива | ❓ | ПУП |
| 1.6 | Побира ли се 12,00 × 8,20 m с отстоянията | ❓ | проектант |
| 1.7 | Наличие на ток, вода, канализация, газ на границата | ❓ | ВиК / ЕРП |
| 1.8 | Денивелация на терена | ❓ | геодезия |
| 1.9 | Достъп за тежка техника (бетоновоз, кран) | ❓ | оглед |
| 1.10 | Съседни сгради и засенчване от тях | ❓ | оглед |

## 2. Геология и терен

| # | Въпрос | Статус |
|---|---|---|
| 2.1 | Носеща способност на почвата | ❓ нужен сондаж |
| 2.2 | Ниво на подпочвените води | ❓ |
| 2.3 | Агресивност на почвата към бетон | ❓ |
| 2.4 | Необходимост от дренаж | ❓ |
| 2.5 | Дълбочина на фундиране и кота на дъното | ❓ |

## 3. ICF система

| # | Въпрос | Статус |
|---|---|---|
| 3.1 | Коя система / производител | ⬜ решение |
| 3.2 | Дебелина на стената (250–400 mm) → влияние върху чистата площ | ⬜ |
| 3.3 | Модул на блока (височина на реда, дължина) | ❓ |
| 3.4 | Сертификат за реакция на огън | ❓ |
| 3.5 | Устойчивост на насекоми/гризачи на EPS | ❓ |
| 3.6 | Наличие на опитен монтажен екип в района | ❓ |
| 3.7 | Гаранция на системата | ❓ |
| 3.8 | Цена на блоковете за m² стена | ❓ оферта |

## 4. Конструкция

| # | Въпрос | Статус |
|---|---|---|
| 4.1 | Оразмеряване на армировката и бетона | ❓ конструктор |
| 4.2 | Надгреда над плъзгащата врата 2,80 m | ❓ |
| 4.3 | Закрепване на покрива към стените | ❓ |
| 4.4 | Ветрово и сеизмично оразмеряване | ❓ |
| 4.5 | Детайл на връзката стена – подова плоча | ❓ |

## 5. Инсталации

| # | Въпрос | Статус |
|---|---|---|
| 5.1 | Отоплителна система (подово, термопомпа, радиатори) | ⬜ решение |
| 5.2 | Вентилация с рекуперация — задължителна при ICF | ⬜ решение |
| 5.3 | Трасе на въздуховодите (в прегради/окачен таван) | ❓ инженер |
| 5.4 | Електрическо захранване — мощност, табло | ❓ |
| 5.5 | ВиК — налягане, дебит, канализация | ❓ |
| 5.6 | Соларни панели / фотоволтаици на южния скат | ⬜ решение |
| 5.7 | Климатизация — да/не, позиция на външните тела | ⬜ решение |

## 6. Бюджет и изпълнение

| # | Въпрос | Статус |
|---|---|---|
| 6.1 | Реален бюджет (над диапазона 72–136 хил. €) | ⬜ решение |
| 6.2 | Ниво на завършеност („до шпакловка“ / „до ключ“) | ⬜ решение |
| 6.3 | Срок на строежа | ⬜ |
| 6.4 | Оферти от 2–3 изпълнители | ❓ |
| 6.5 | Кой води строителния надзор | ❓ |
| 6.6 | Финансиране (собствени средства, кредит) | ⬜ |

## 7. Клиентски решения

| # | Въпрос | Статус |
|---|---|---|
| 7.1 | Едноетажна — окончателно? (влияе на покрива и фундамента) | ✅ да |
| 7.2 | Две спални — окончателно? | ✅ да |
| 7.3 | Отделен коридор или спални, отворени към хола | ⬜ |
| 7.4 | Душ или вана в банята | ⬜ |
| 7.5 | Сушилня в мокрото помещение | ⬜ |
| 7.6 | Камина / печка на дърва | ⬜ |
| 7.7 | Тераса — размер и настилка | ⬜ |
| 7.8 | Стил на фасадата (мазилка, дърво, камък) | ⬜ |
| 7.9 | Покрив — керемиди, метал, друго | ⬜ |
| 7.10 | Паркинг / навес за автомобил | ⬜ |

## 8. Неща, за които изрично не е сигурно

- Всички **цени** — виж [бюджета](../budget/01-cost-estimate.md).
- Всички **нормативни изисквания** (ПУП, наредби, енергийни изисквания) —
  **проверяват се от проектант в общината**.
- **Геоложките условия** — без сондаж не може да се каже нищо надеждно.
- **Топлотехническите характеристики** на конкретната ICF система — по сертификат.
- **Цената и срокът** на самото проектиране.

---

**Свързани документи:** [задание за проектанта](./01-design-brief.md) ·
[концептуален план](../architecture/01-concept-plan.md) ·
[конструкция](../structure/01-icf-structure.md)
