metodiev/nikolaevo-house/icf/01-zadanie.md

# Задание към ICF доставчика

Документът описва **обхвата**: какво очакваме да достави фирмата и какво остава
извън нейната отговорност.

---

## 1. Обект

| Параметър | Стойност |
|---|---|
| Обект | едноетажна самостоятелна жилищна къща |
| Местоположение | Николаево |
| Конструктивна система | ICF (изолирани бетонни кофражни блокове) |
| Форма | правоъгълник 12,00 × 8,20 m, ъгли само 90° |
| Етажност | 1 |
| Височина на стената до стреха | 3,00 m |
| Покрив | двускатен, било по оста изток–запад |

---

## 2. Обхват на доставката — какво искаме

### 2.1 Задължително

| Позиция | Описание |
|---|---|
| 1 | ICF кофражни блокове за **4 външни стени** — количество по [03-kolichestva.md](./03-kolichestva.md) |
| 2 | **Ъглови елементи** за 4 външни ъгъла 90° |
| 3 | **Затварящи / челни елементи** за 16 вертикални ръба на отворите |
| 4 | Елементи за оформяне на **надгреди** над отворите (или ясно указание как се изпълняват) |
| 5 | Елементи за **Т-възли**, ако преградите се изпълняват с ICF (в нашия случай — не) |
| 6 | **Технически лист** на системата: дебелини, модул, разход на бетон и армировка за m² |
| 7 | **Монтажна инструкция** и схема за подреждане на блоковете |
| 8 | **Сертификати**: реакция на огън, топлопроводимост, устойчивост на насекоми/гризачи |
| 9 | Указание за **клас и консистенция на бетона** и начина на полагане |
| 10 | **Гаранция** — срок и обхват |

### 2.2 По избор (да се оферира отделно)

| Позиция | Описание |
|---|---|
| A | **Монтаж** на кофража от ваш екип (с цени за труд) |
| B | Доставка до обекта (с цена за транспорт) |
| C | Опция **O9** — допълнителен западен прозорец (1,00 × 1,40 m) |
| D | **Фронтони** (габъли) с ICF, ако препоръчате — виж т. 4 |
| E | Бетон и армировка — ако ги доставяте вие |

---

## 3. Обхват — какво НЕ е включено

За да няма разминаване в офертите, изрично **не** очакваме в тази оферта:

- Вътрешни прегради — газобетон / керамика / гипсокартон (доставят се отделно)
- Фундамент и подова плоча — отделен подизпълнител
- Покривна конструкция и покритие
- Дограма, входна врата
- ВиК, електро, ОВК инсталации
- Външна и вътрешна мазилка
- Фасадно покритие
- Геоложки доклад, проект, разрешителни
- Тераса, навес, ограда, озеленяване

Ако някоя от тези позиции влиза в офертата ви — **посочете я отделно**, за да не
се дублира с други изпълнители.

---

## 4. Специфични изисквания

### 4.1 Стени

- Дебелина **350 mm** — работно допускане. Ако вашата система е друга, посочете
  точната дебелина и нейното отражение върху чистата площ.
- Височина на стената **3000 mm**. Ако модулът на блока не позволява точно
  3000 mm, посочете най-близката възможна височина (3000 mm се дели на 250 mm =
  12 курса; при друг модул може да е различно).
- **Всички ъгли са 90°** — без еркери, криви и скосявания.

### 4.2 Отвори

- **8 основни + 1 опция** — пълен списък в [02-steni-i-otvori.md](./02-steni-i-otvori.md).
- Отворите се оформят **в кофража**, не се изрязват след бетониране.
- Най-големият отвор е **плъзгаща врата 2800 × 2250 mm** (хол → тераса). Нужна е
  надгреда — моля да я включите или да укажете как се изпълнява.
- Размерите на отворите да се съобразят с модула на блока, ако има конфликт —
  **посочете го**, преди да оферирате.

### 4.3 Фронтони

Стената е до кота **+3000** (стреха). Фронтоните над нея **не са ICF** — предвижда
се лека конструкция.

Ако препоръчвате изпълнение с ICF и за фронтоните, посочете:
- възможна ли е триъгълна форма с вашата система;
- ориентировъчна цена за ≈ 2 × 7,8 m²;
- как се решава връзката с покривната конструкция.

---

## 5. Какво искаме да получим от вас

| # | Резултат |
|---|---|
| 1 | Оферта **по позиции** (не обща сума) — по структурата от [05-sravnenie.md](./05-sravnenie.md) |
| 2 | Технически лист и сертификати на системата |
| 3 | Схема за подреждане на блоковете, ако е различна от типовата |
| 4 | Указание за бетон и армировка (за конструктора) |
| 5 | Срок на доставка |
| 6 | Условия за плащане |
| 7 | Гаранция |
| 8 | Отговори на въпросника от [04-vaprosi.md](./04-vaprosi.md) |

---

## 6. График

| Стъпка | Кога |
|---|---|
| Изпращане на този пакет | – |
| Въпроси и уточнения от ваша страна | до 1 седмица |
| Оферта | до 2 седмици |
| Избор на доставчик | след сравнение по [05-sravnenie.md](./05-sravnenie.md) |
| Доставка | по договаряне, след готовност на фундамента |

---

## 7. Особено важно

- **Не приемаме промени в обхвата без писмено потвърждение.**
- Всички допускания, на които е базирана офертата (дебелина, модул, клас бетон),
  трябва да са изрично записани.
- Ако нещо в този пакет е непълно или противоречиво — **кажете го**, вместо да
  правите допускане.

---

**Приложения:** [стени и отвори](./02-steni-i-otvori.md) ·
[количества](./03-kolichestva.md) ·
[план 1:100](./plans/icf-plan.svg) ·
[фасади](./plans/icf-elevations.svg) ·
[детайли](./plans/icf-details.svg) ·
[редене](./plans/icf-courses.svg)
