metodiev/nikolaevo-house/structure/01-icf-structure.md

# ICF конструкция

Конструктивна логика на едноетажната ICF къща.

> Този документ описва **принципи**, не оразмеряване. Всички дебелини, класове бетон,
> армировка, размери на фундаменти и надгреди се определят от **лицензиран
> конструктор** по действащите норми и по геоложки доклад. Посочените стойности са
> работни допускания за концепцията.

Чертеж: [details/wall-section.svg](./details/wall-section.svg)

---

## 1. Стенен разрез (работно допускане)

| № | Слой (отвън навътре) | Дебелина |
|---|---|---|
| 1 | Външно фасадно покритие (мазилка/фасадна система) | ~20 mm |
| 2 | EPS — външен слой на ICF блока | ~80 mm |
| 3 | Стоманобетонно ядро + армировка | ~150 mm |
| 4 | EPS — вътрешен слой на ICF блока | ~80 mm |
| 5 | Вътрешна мазилка | ~20 mm |
| | **Общо** | **≈ 350 mm** |

Дебелината **не е фиксирана** — различните ICF системи дават 250–400 mm. Изборът на
система променя чистата площ с 1–3 m² и трябва да се направи **преди** окончателния
архитектурен проект.

---

## 2. Конструктивна логика

**Външни стени — носещи.**

- Четири прави стени във **затворен правоъгълен контур** работят като корава кутия:
  поемат покрива, вятъра и хоризонталните въздействия.
- Бетонното ядро е непрекъснато по целия периметър — няма прекъсвания освен отворите.
- Вертикална армировка на стъпка по проект; хоризонтална армировка във всеки ред
  блокове; стоманобетонни колони се оформят в ъглите и в краищата на отворите.
- Точното оразмеряване (клас бетон, диаметри, стъпки) — **по конструктивен проект**.

**Защо правоъгълник:**

| Причина | Ефект |
|---|---|
| Само ъгли 90° | стандартни ъглови блокове, без специални детайли |
| Няма криви/еркери | без изрязване на блокове, без слаби места |
| Компактен периметър (40,4 m за 98,4 m²) | минимум мост на топлина и минимум материал |
| Прост покрив | дървени ферми на 8,20 m пролет, без сложни възли |

**Вътрешни стени — неносещи.**

Покривната конструкция стъпва само на външните ICF стени. Затова вътрешните прегради
могат да се променят по-късно и не е нужно да са ICF.

| Помещение / стена | Препоръчан материал | Причина |
|---|---|---|
| Баня и мокро помещение | газобетон или керамика 100–120 mm | плочки, висящ WC, бойлер, влага |
| Стени с кухненски шкафове | газобетон 100–120 mm | носеща способност за шкафове |
| Останали прегради | гипсокартон на метална конструкция + минерална вата | бързо, евтино, добра звукоизолация, скрити инсталации |
| Тънък ICF за прегради | възможно, но не се препоръчва | по-скъпо без конструктивна полза |

---

## 3. Фундамент и под

- **Ивичен фундамент** от стоманобетон под всяка външна ICF стена.
  Размери и кота на дъното — **по геоложки доклад** (не е известно)
- **Подова плоча върху земя**, стоманобетон, с:
  - **XPS 100–150 mm под плочата**;
  - **вертикална XPS ивица по периметъра** под вътрешната повърхност на стената,
    непрекъснато свързана с изолацията на стената;
  - хидроизолация и дренаж около фундамента.
- Кофaта на пода — над терена (препоръчително ≥ 0,30–0,45 m), за да се избегне
  капилярна влага. Точната кота — по проект.

**Критично:** ако изолацията на плочата не се свърже с изолацията на стената, по ръба
на плочата остава студен мост и вътрешната повърхност кондензира. Това е най-честата
грешка при ICF сгради.

---

## 4. Отвори и надгреди

- Отворите се оформят **в кофража** — не се изрязват след бетониране.
- Над всеки отвор — стоманобетонна надгреда, изляна в ICF, или предварително
  изготвена. За плъзгащата врата 2,80 m надгредата е задължително проектирана.
- Около отворите се добавя допълнителна армировка (ъглово рамо).
- Размерите на отворите се съобразяват с **модула на блока** (обикновено кратни на
  50 mm) — това намалява рязането и отпадъка.
- Подпрозоречните первази: външен каперезлив профил, вътрешен перваз, и **преход към
  дограмата в зоната на изолацията**.

---

## 5. Покрив

- **Двускатен**, било по оста **изток–запад** (късата пролет 8,20 m).
- Дървени ферми или гредова конструкция — по конструктивен проект.
- Наклон 20–30° — съгласува се с ПУП и съседната застройка (**не е проверено**).
- Топлоизолация на тавана/покрива — по енергиен проект.
- **Надвес ≥ 0,60 m** (и ≥ 1,0 m над южната плъзгаща врата за засенчване).
- Габълните стени (фронтоните) могат да са лека конструкция, а не ICF — по-евтино.
- Водоотвеждане: улуци и водосточни тръби по ъглите.

---

## 6. Инсталации в ICF къща

| Проблем | Решение |
|---|---|
| В ICF не се къртят канали | Електрическите и ВиК трасета се планират **предварително**, в преградите, в замазката и в окачен таван |
| Точки на стената (ключове, контакти) | разполагат се на вътрешните прегради; на ICF стена — с накладни кутии и предварително заложени тръби |
| Висящи шкафове / WC | закрепване в газобетон или предварително заложени дюбели/шини |
| Херметичност | **планирана вентилация с рекуперация**; агрегат в мокрото помещение |
| Топлене | подово отопление в замазката е най-съвместимо с ICF (ниска температура на топлоносителя) |

Не се приемат решения „ще го измислим на обекта“ — при ICF това е скъпо.

---

## 7. Какво трябва да потвърди конструкторът

- [ ] Дебелина и клас на бетона, диаметри и стъпки на армировката
- [ ] Оразмеряване на надгредите (особено 2,80 m плъзгаща врата)
- [ ] Размери на ивичните фундаменти и кота на дъното (след геоложки доклад)
- [ ] Дебелина и армировка на подовата плоча
- [ ] Конструкция и закрепване на покрива към ICF стените
- [ ] Ветрово и сеизмично оразмеряване
- [ ] Детайли на ъгли, Т- и кръстовища, отвори
- [ ] Съвместимост с избраната ICF система и нейните сертификати

---

## 8. Рискове и неясноти

| Тема | Статус |
|---|---|
| Геология и подпочвени води | **не е известно** — нужен сондаж |
| Реакция на огън на конкретната ICF система | **не е сигурно** без сертификат на производителя |
| Устойчивост на насекоми/гризачи на EPS | **не е сигурно** — проверява се в документацията на системата |
| Наличие на опитни ICF екипи в района | **не е известно** — 2–3 оферти |
| Изисквания по ПУП (височина, наклон, отстояния) | **не е проверено** |

Пълен списък: [02-open-questions.md](../documentation/02-open-questions.md).

---

**Виж още:** [концептуален план](../architecture/01-concept-plan.md) ·
[бюджет](../budget/01-cost-estimate.md)
