metodiev/nikolaevo-house/3d/images/01-aksonometriya-s-mebel.png

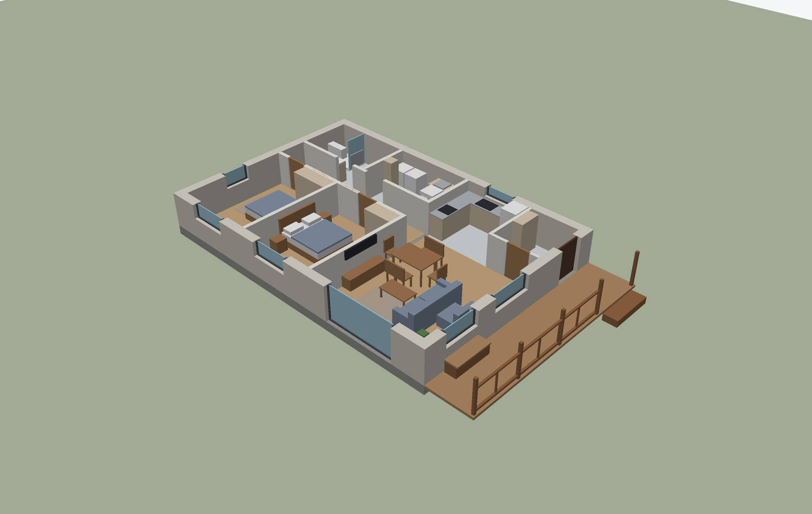
3d/images/01-aksonometriya-s-mebel.png
