metodiev/nikolaevo-house/3d/images/02-aksonometriya-bez-mebel.png

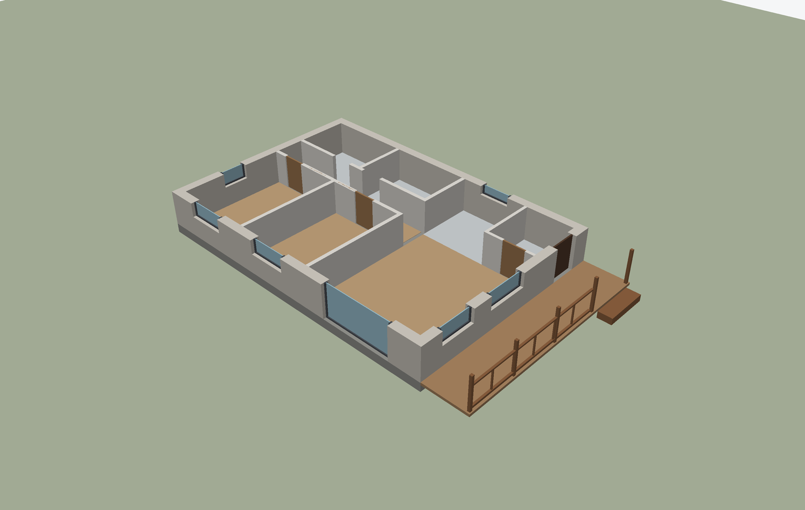
3d/images/02-aksonometriya-bez-mebel.png
