metodiev/nikolaevo-house/3d/images/03-aksonometriya-severoiztok.png

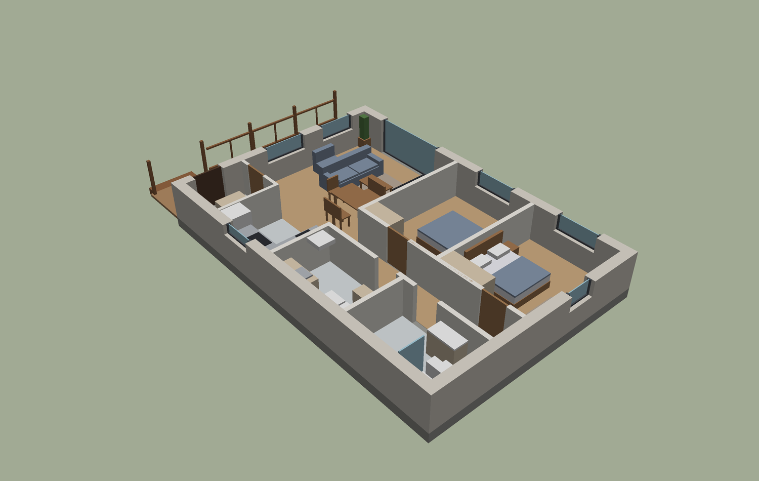
3d/images/03-aksonometriya-severoiztok.png
