metodiev/nikolaevo-house/3d/images/04-fasada-yug.png

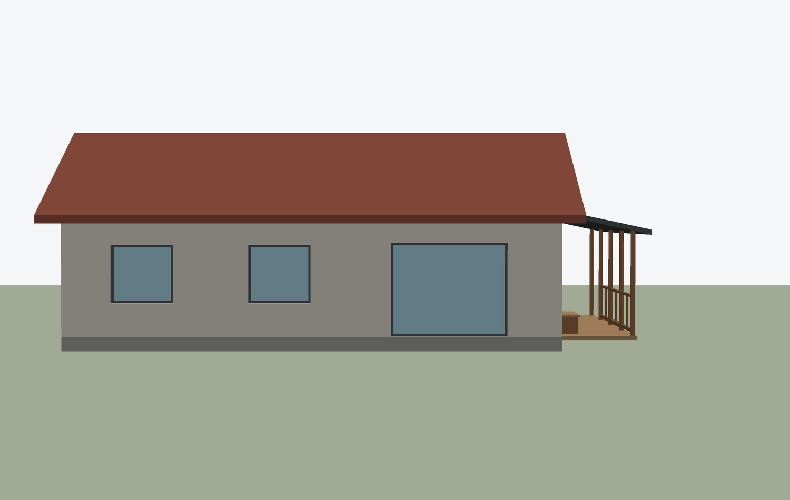
3d/images/04-fasada-yug.png
