metodiev/nikolaevo-house/3d/images/05-fasada-iztok.png

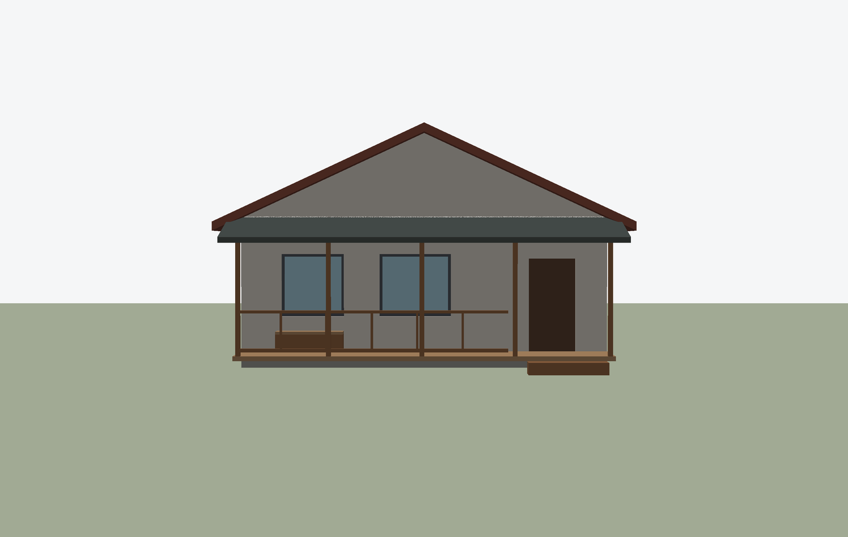
3d/images/05-fasada-iztok.png
