metodiev/nikolaevo-house/3d/images/06-perspektiva-yugoiztok.png

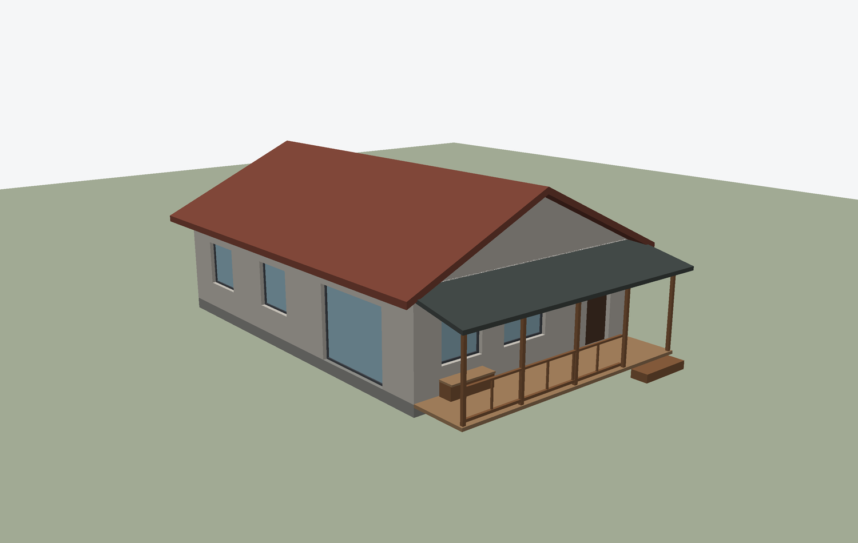
3d/images/06-perspektiva-yugoiztok.png
