metodiev/nikolaevo-house/3d/images/07-perspektiva-severoiztok.png

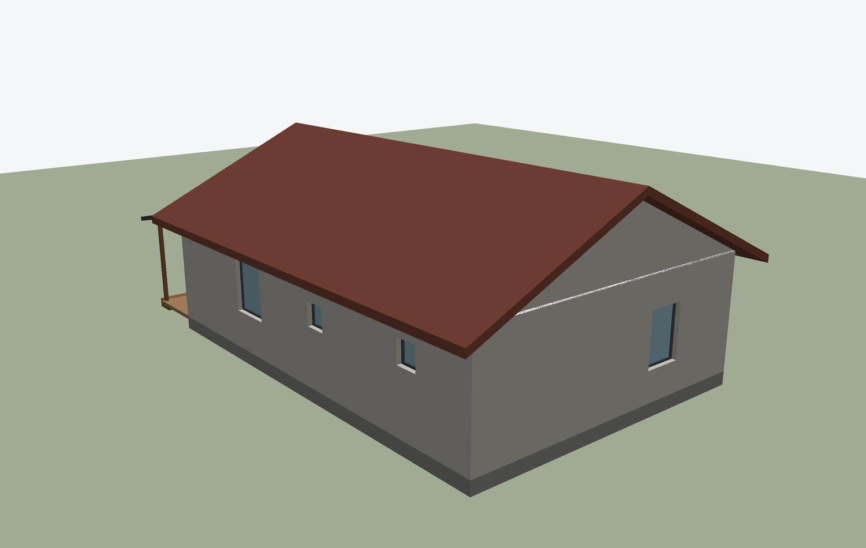
3d/images/07-perspektiva-severoiztok.png
