metodiev/nikolaevo-house/3d/images/08-vatreshna-dnevna-s-mebel.png

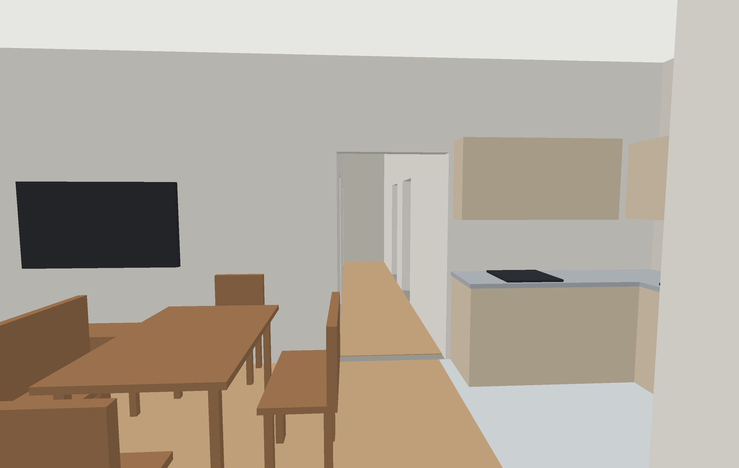
3d/images/08-vatreshna-dnevna-s-mebel.png
