metodiev/nikolaevo-house/3d/images/09-vatreshna-dnevna-bez-mebel.png

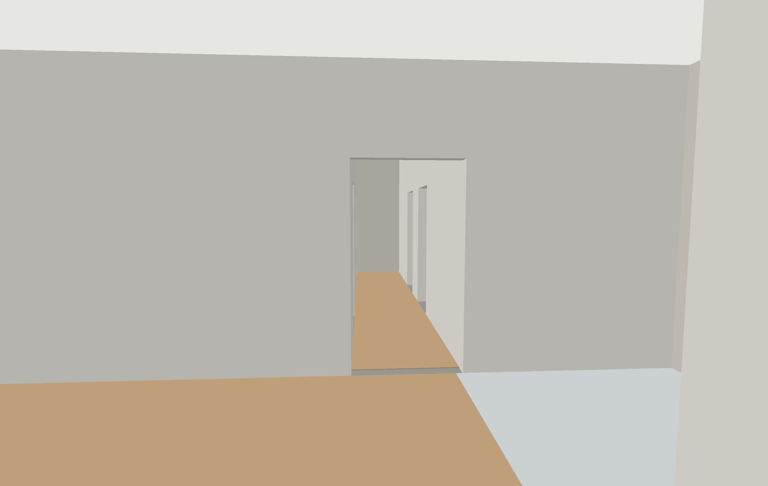
3d/images/09-vatreshna-dnevna-bez-mebel.png
