metodiev/nikolaevo-house/3d/images/11-vatreshna-kuhnya-bez-mebel.png

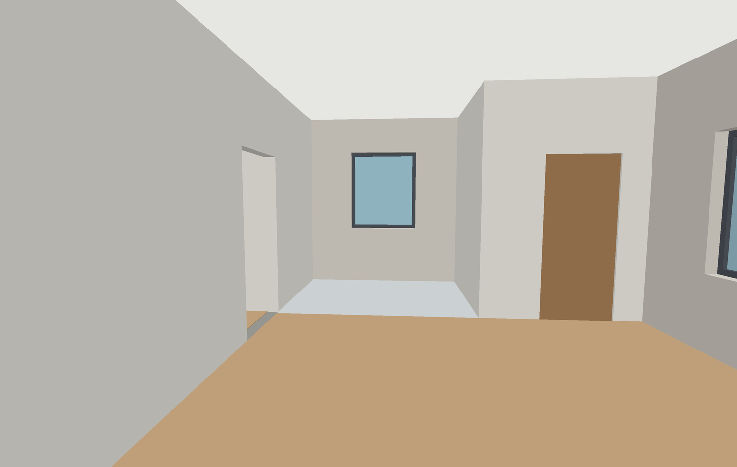
3d/images/11-vatreshna-kuhnya-bez-mebel.png
