metodiev/nikolaevo-house/3d/images/12-vatreshna-spalnya-s-mebel.png

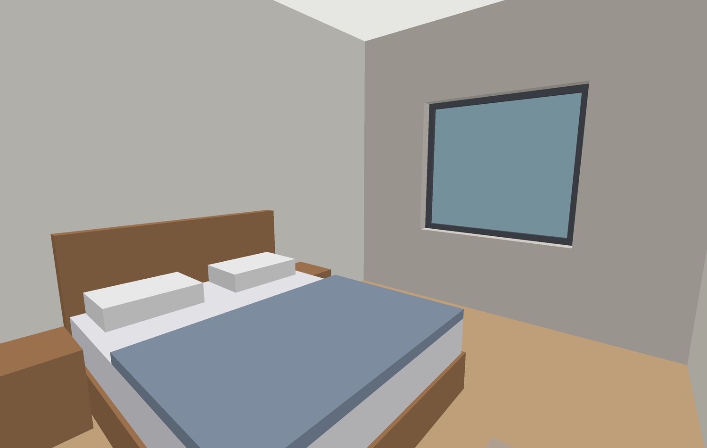
3d/images/12-vatreshna-spalnya-s-mebel.png
