metodiev/nikolaevo-house/3d/images/13-vatreshna-spalnya-bez-mebel.png

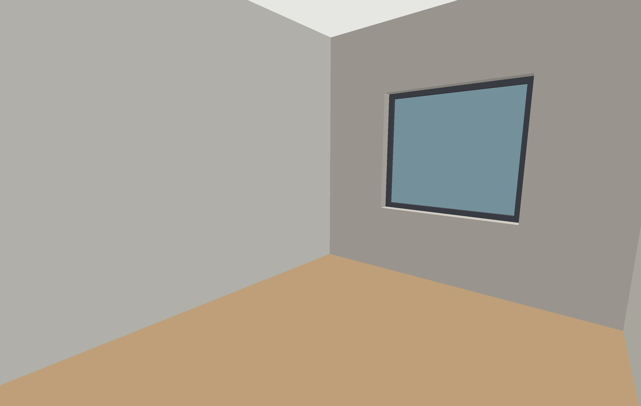
3d/images/13-vatreshna-spalnya-bez-mebel.png
