metodiev/nikolaevo-house/3d/images/14-veranda-s-mebel.png

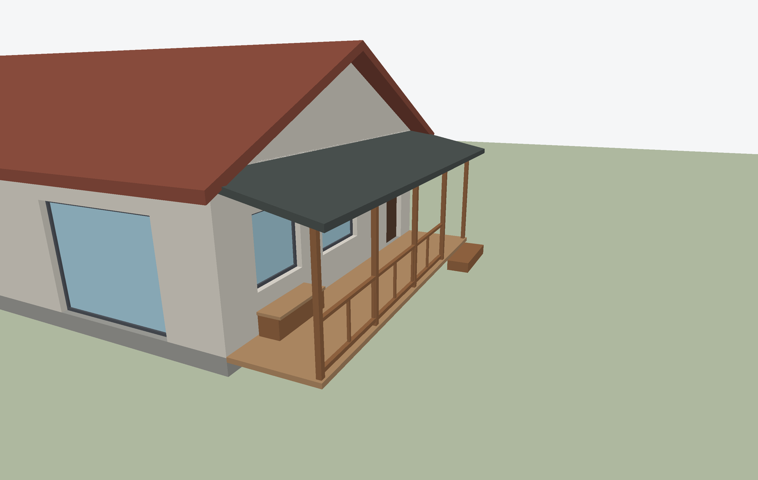
3d/images/14-veranda-s-mebel.png
