metodiev/nikolaevo-house/3d/images/15-veranda-otvorena.png

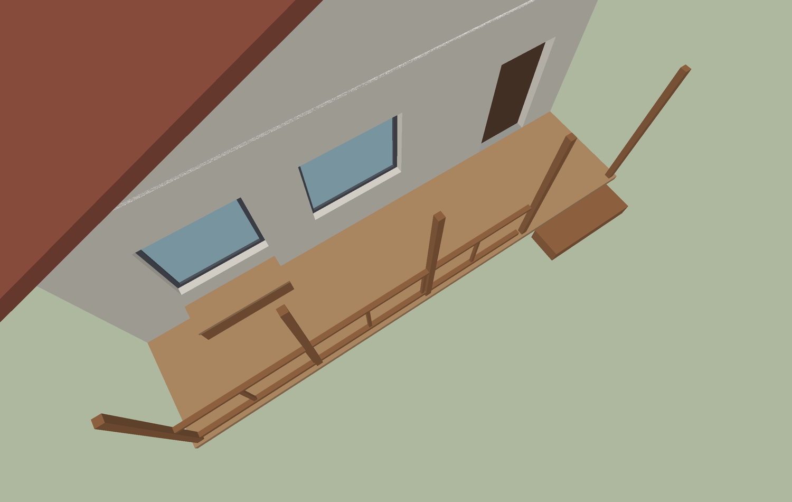
3d/images/15-veranda-otvorena.png
