metodiev/nikolaevo-house/architecture/cad/house.png

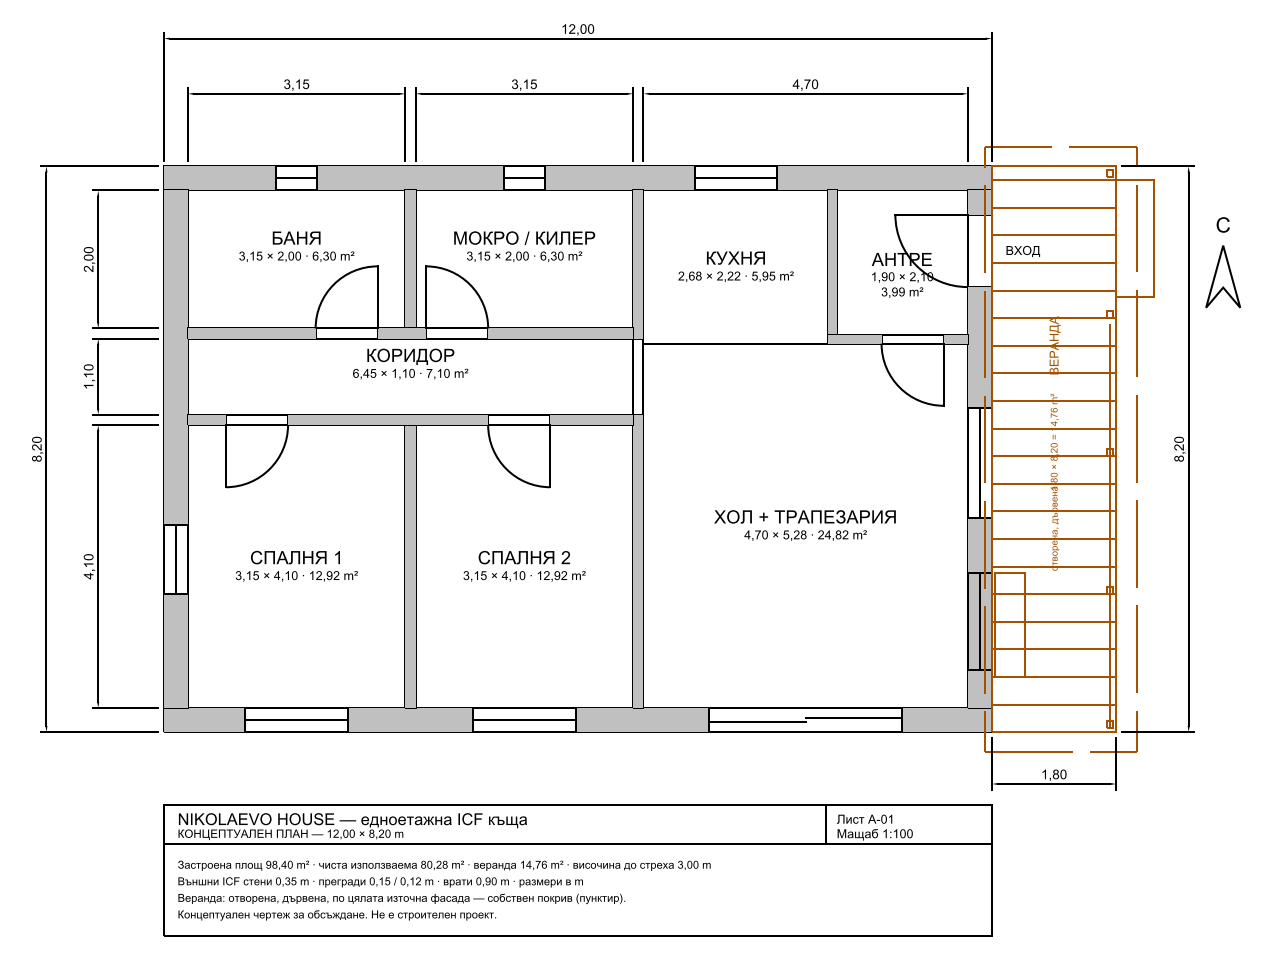
architecture/cad/house.png
