metodiev/nikolaevo-house/architecture/images/A-03-dograma.png

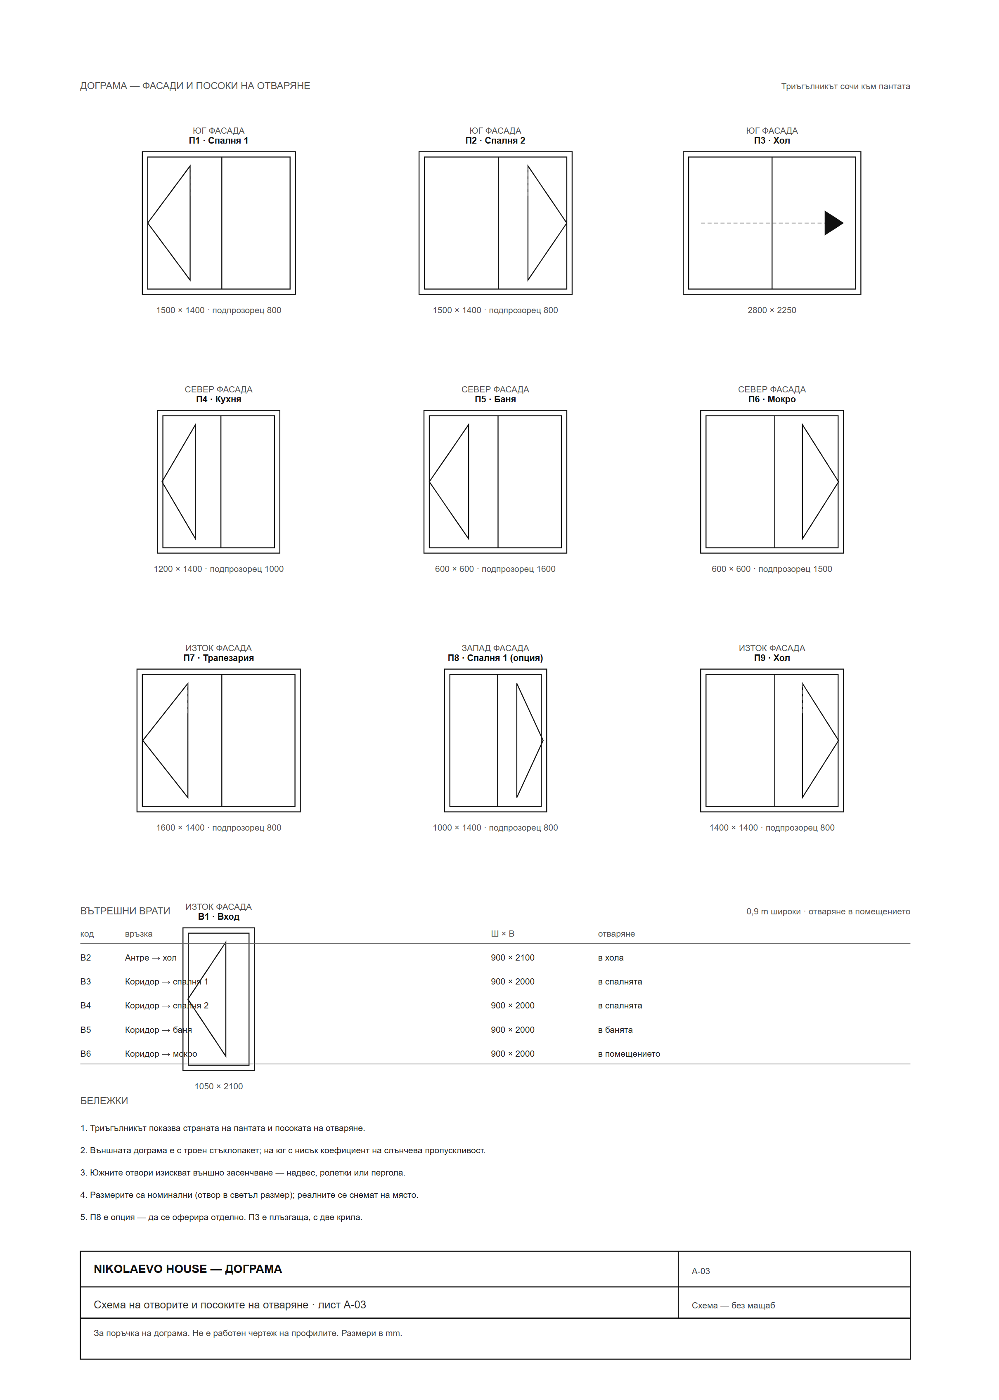
architecture/images/A-03-dograma.png
