metodiev/nikolaevo-house/architecture/images/A-04-veranda.png

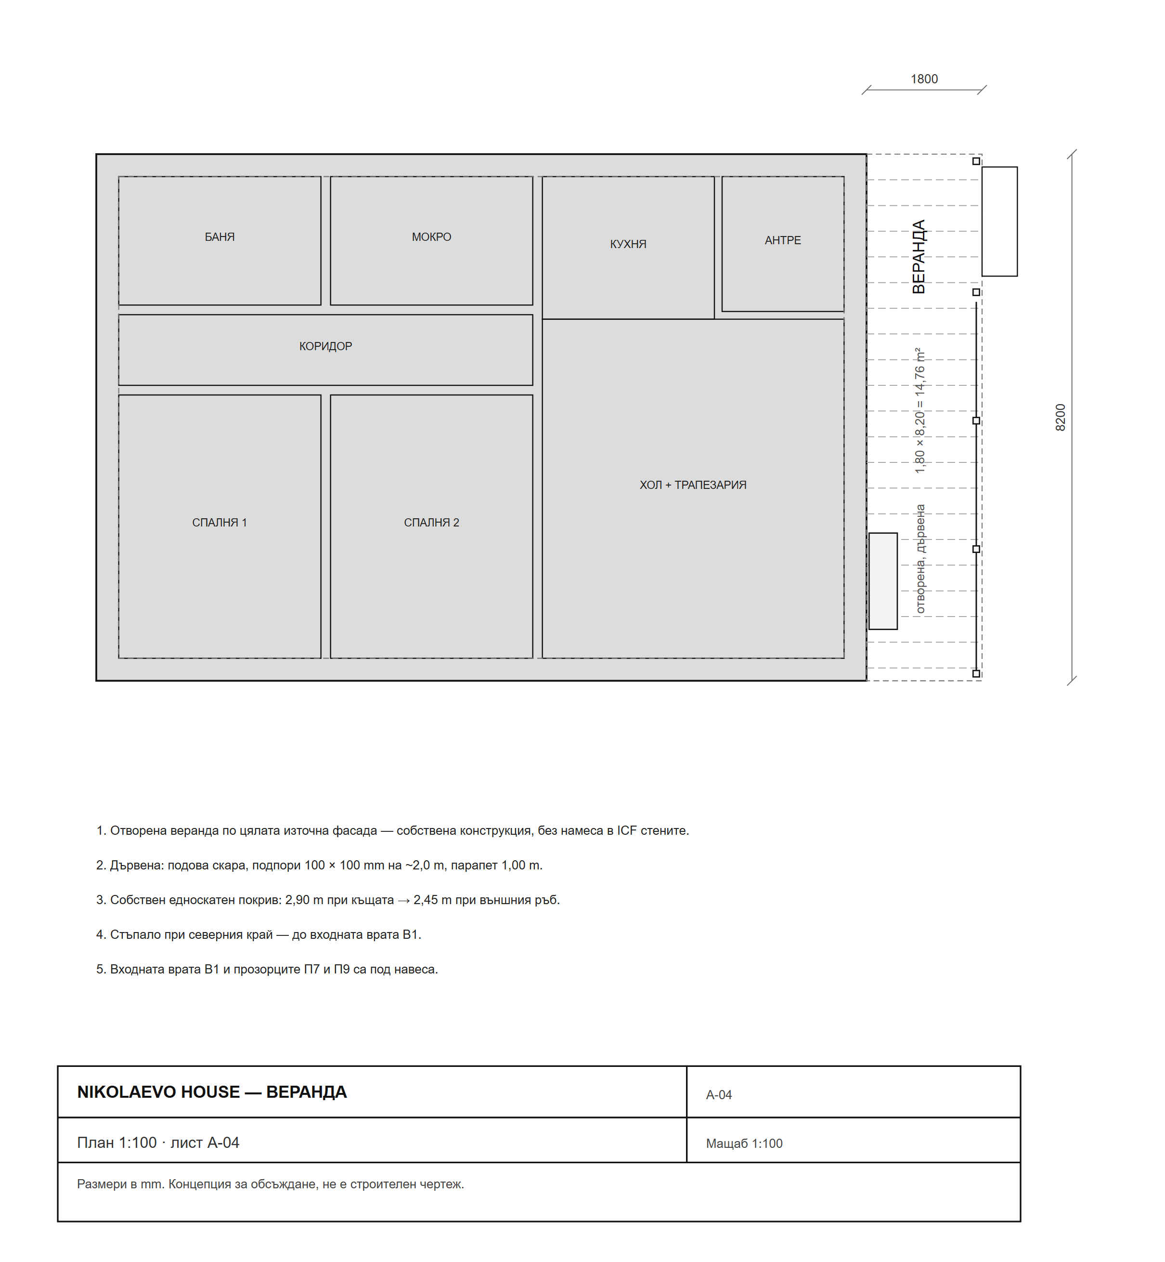
architecture/images/A-04-veranda.png
