metodiev/nikolaevo-house/architecture/images/floor-plan.png

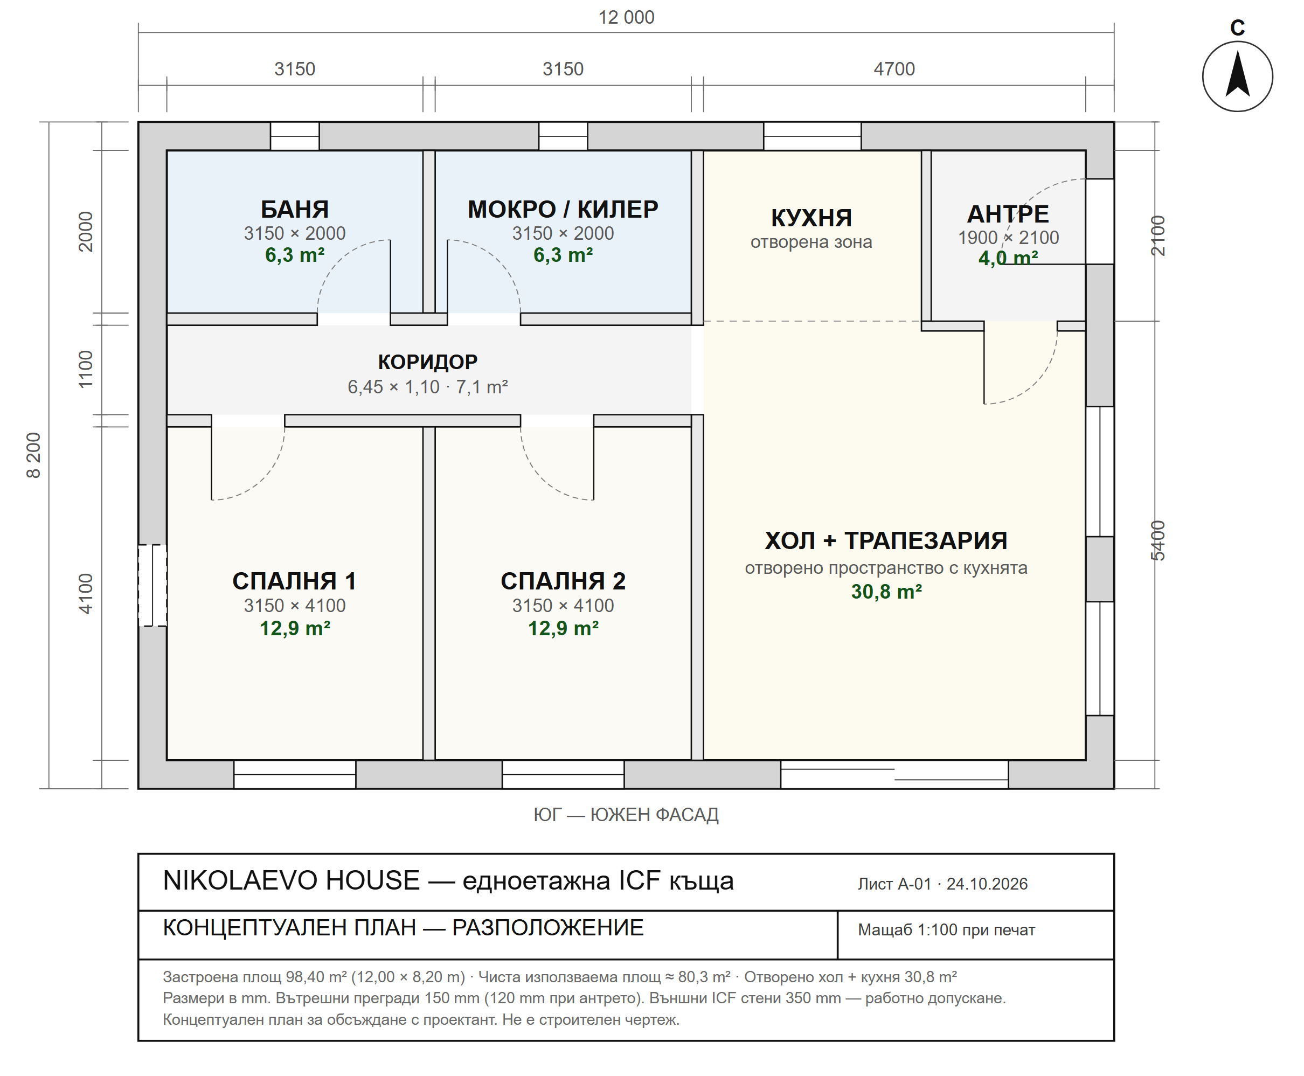
architecture/images/floor-plan.png
