metodiev/nikolaevo-house/architecture/images/site-orientation.png

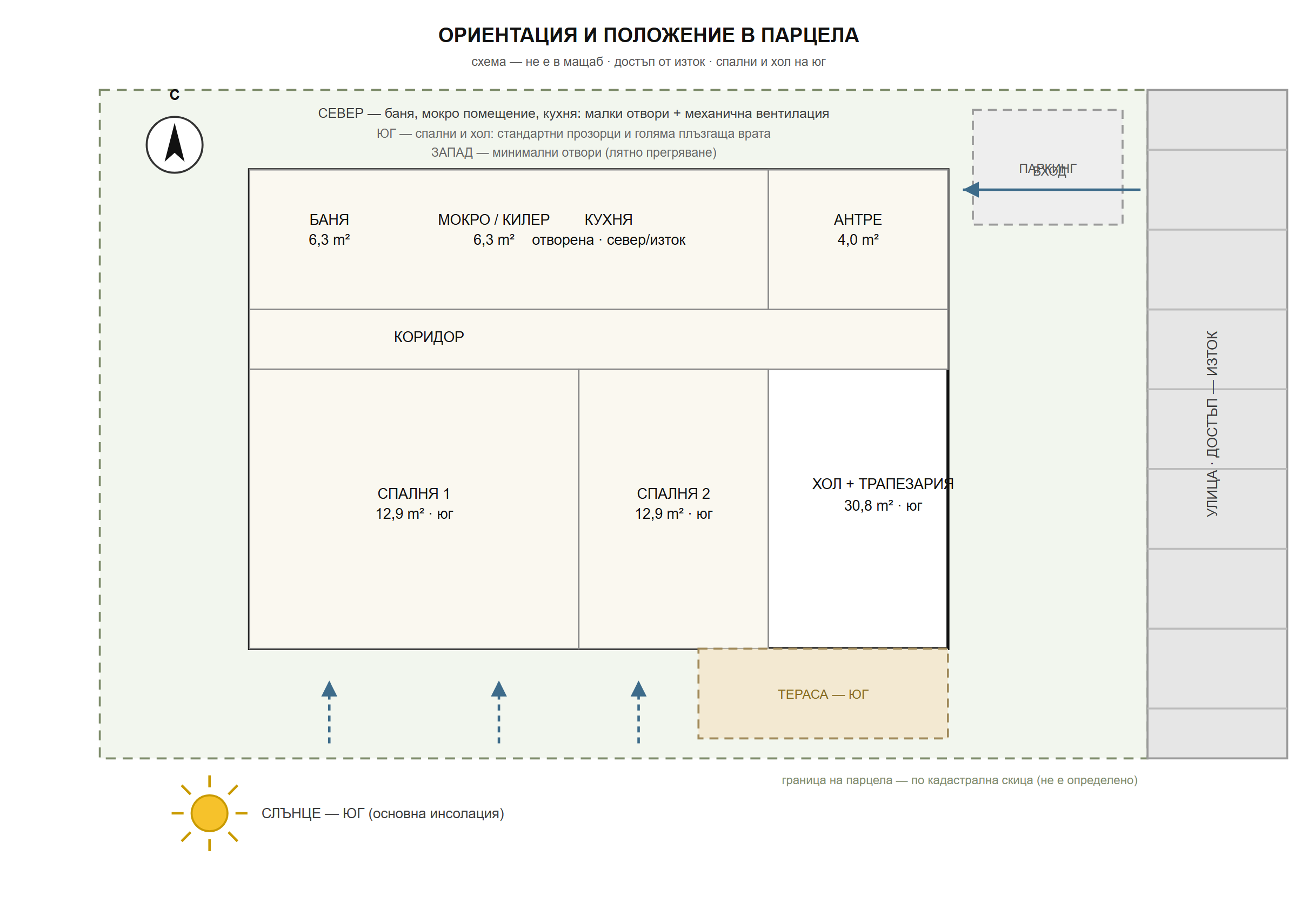
architecture/images/site-orientation.png
