metodiev/nikolaevo-house/electrical/images/E-01-plan.png

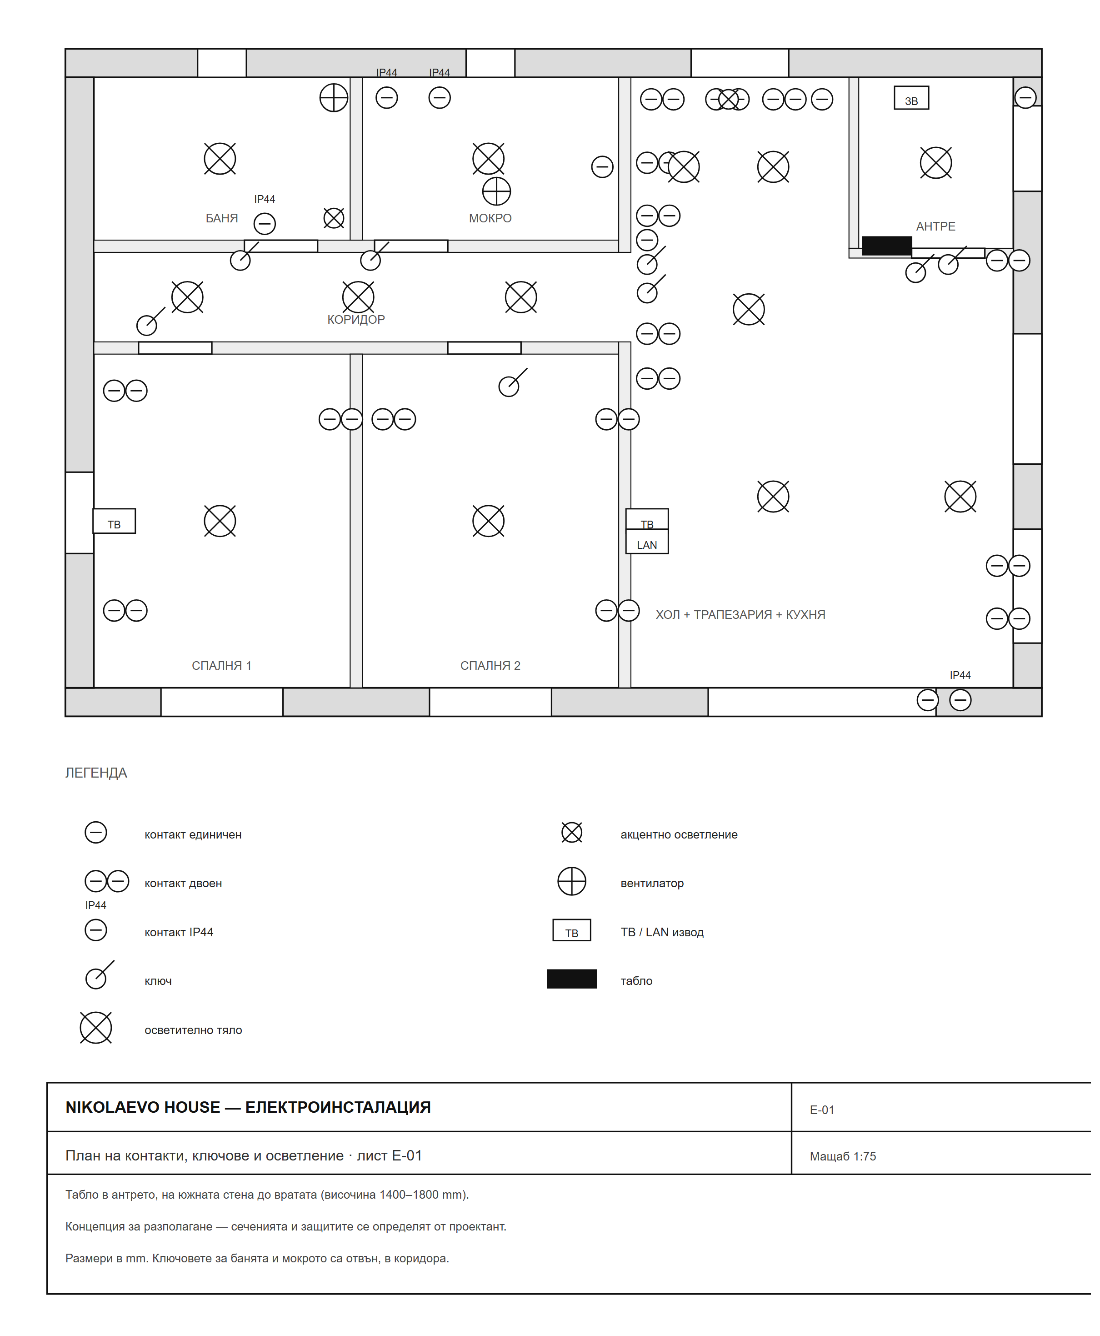
electrical/images/E-01-plan.png
