metodiev/nikolaevo-house/electrical/images/E-02-tablo.png

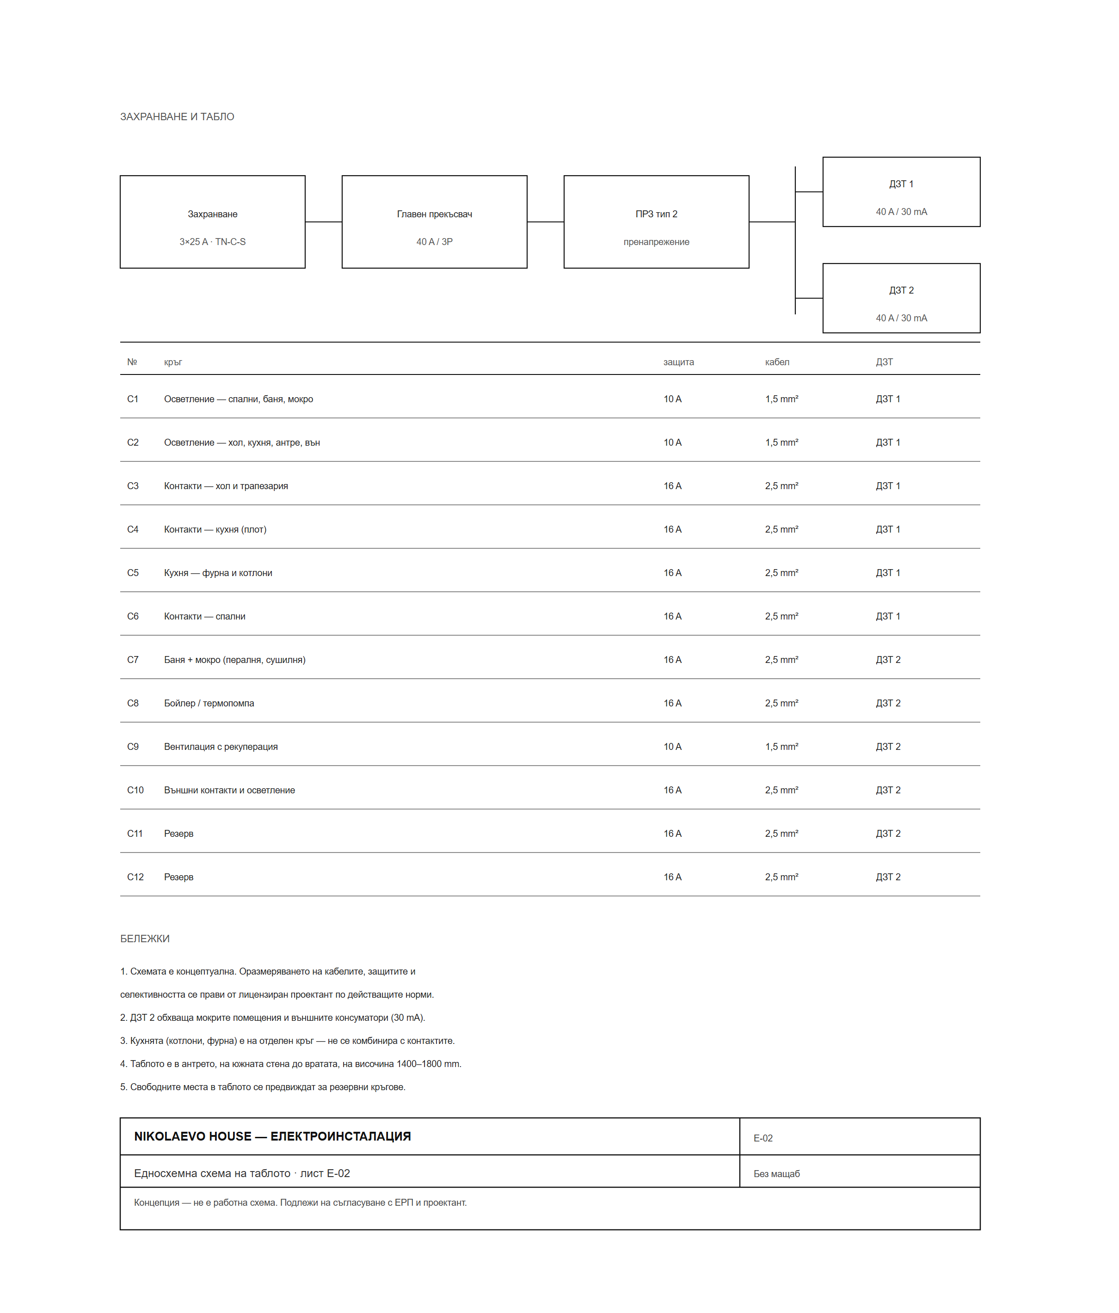
electrical/images/E-02-tablo.png
