metodiev/nikolaevo-house/furniture/images/F-01-obzor.png

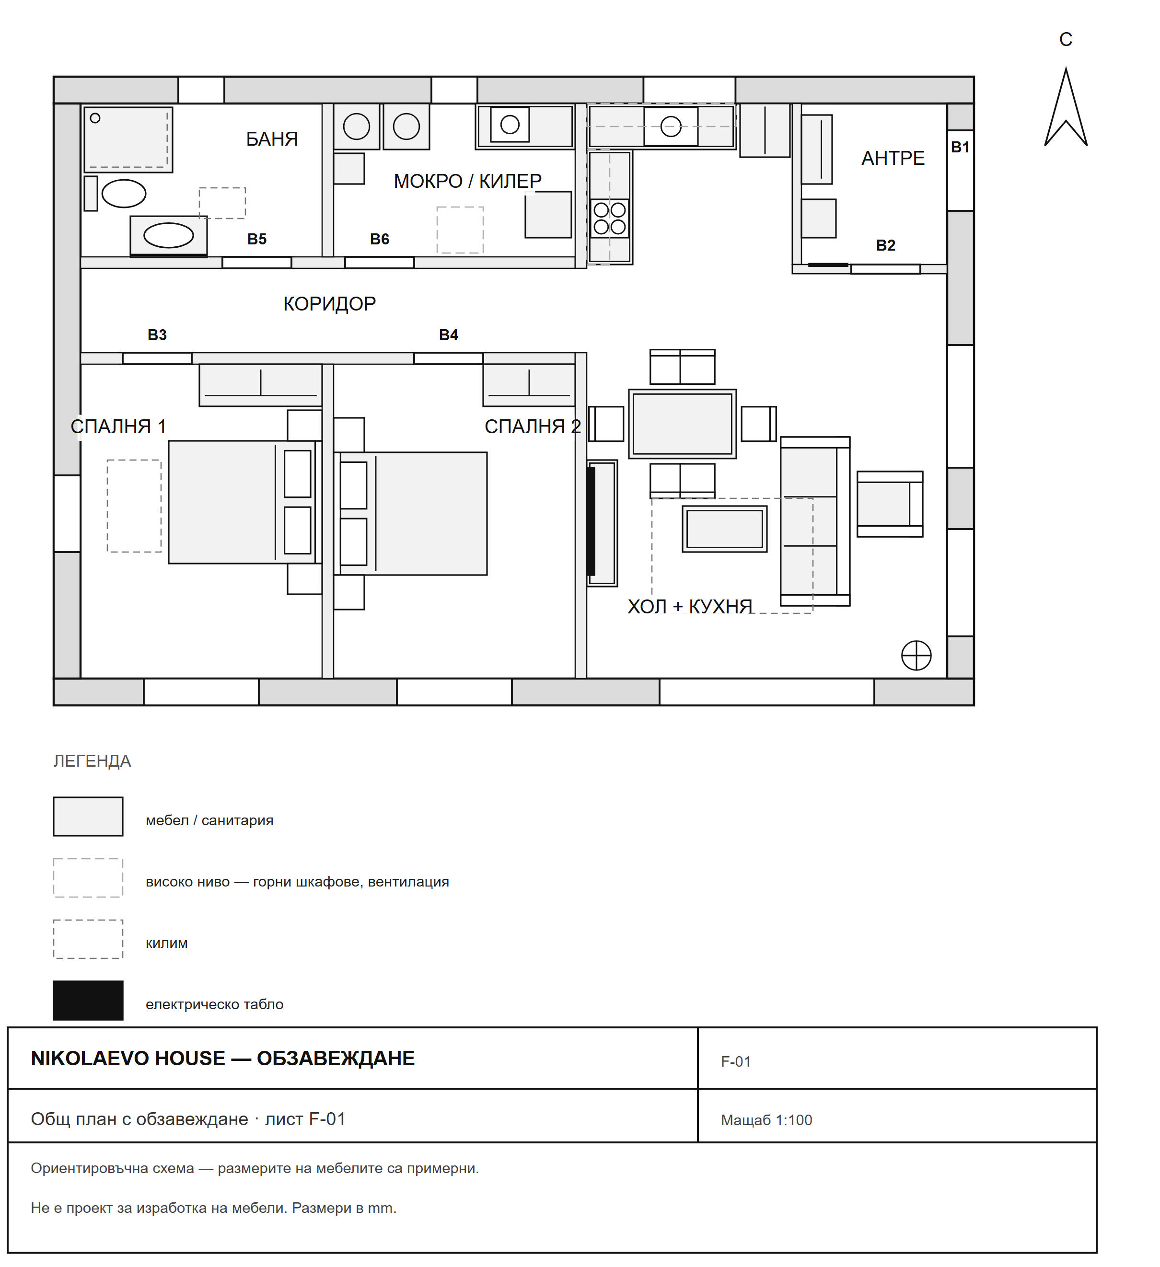
furniture/images/F-01-obzor.png
