metodiev/nikolaevo-house/furniture/images/F-02-dnevna.png

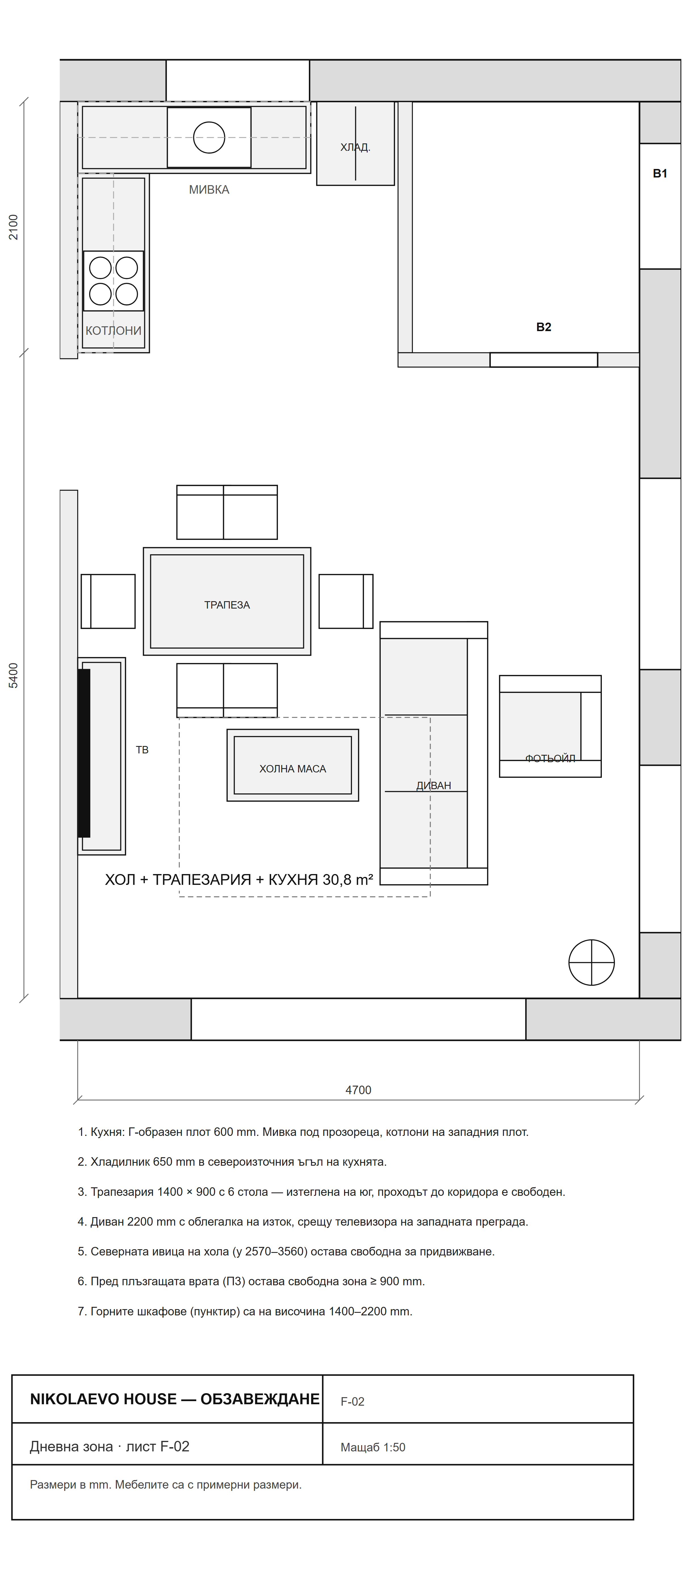
furniture/images/F-02-dnevna.png
