metodiev/nikolaevo-house/furniture/images/F-03-spalni.png

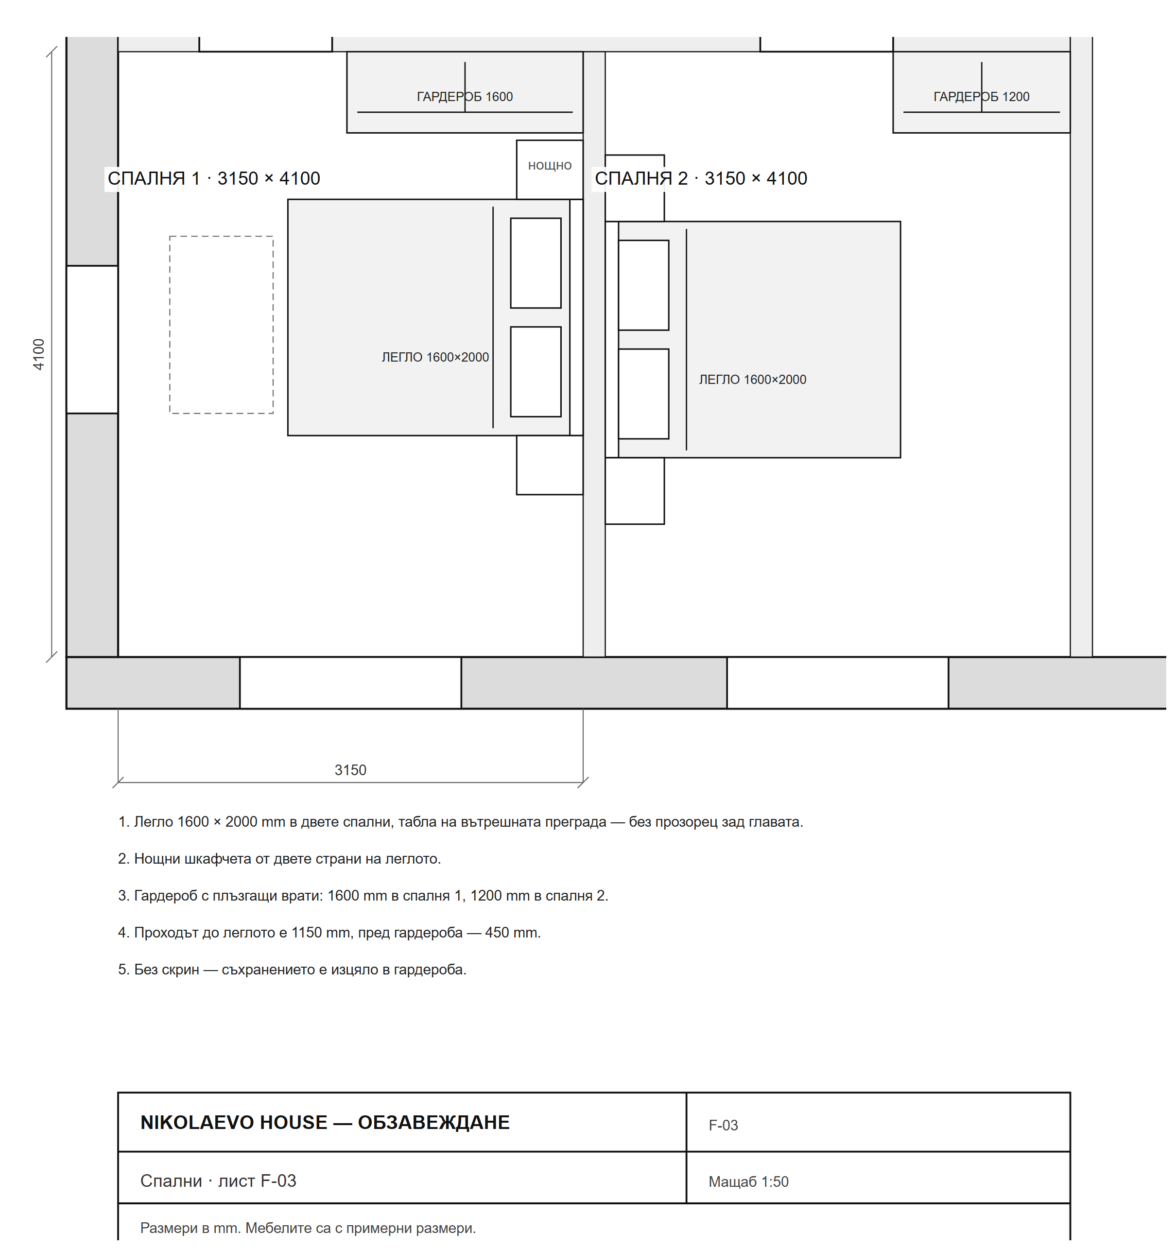
furniture/images/F-03-spalni.png
