metodiev/nikolaevo-house/furniture/images/F-04-mokri.png

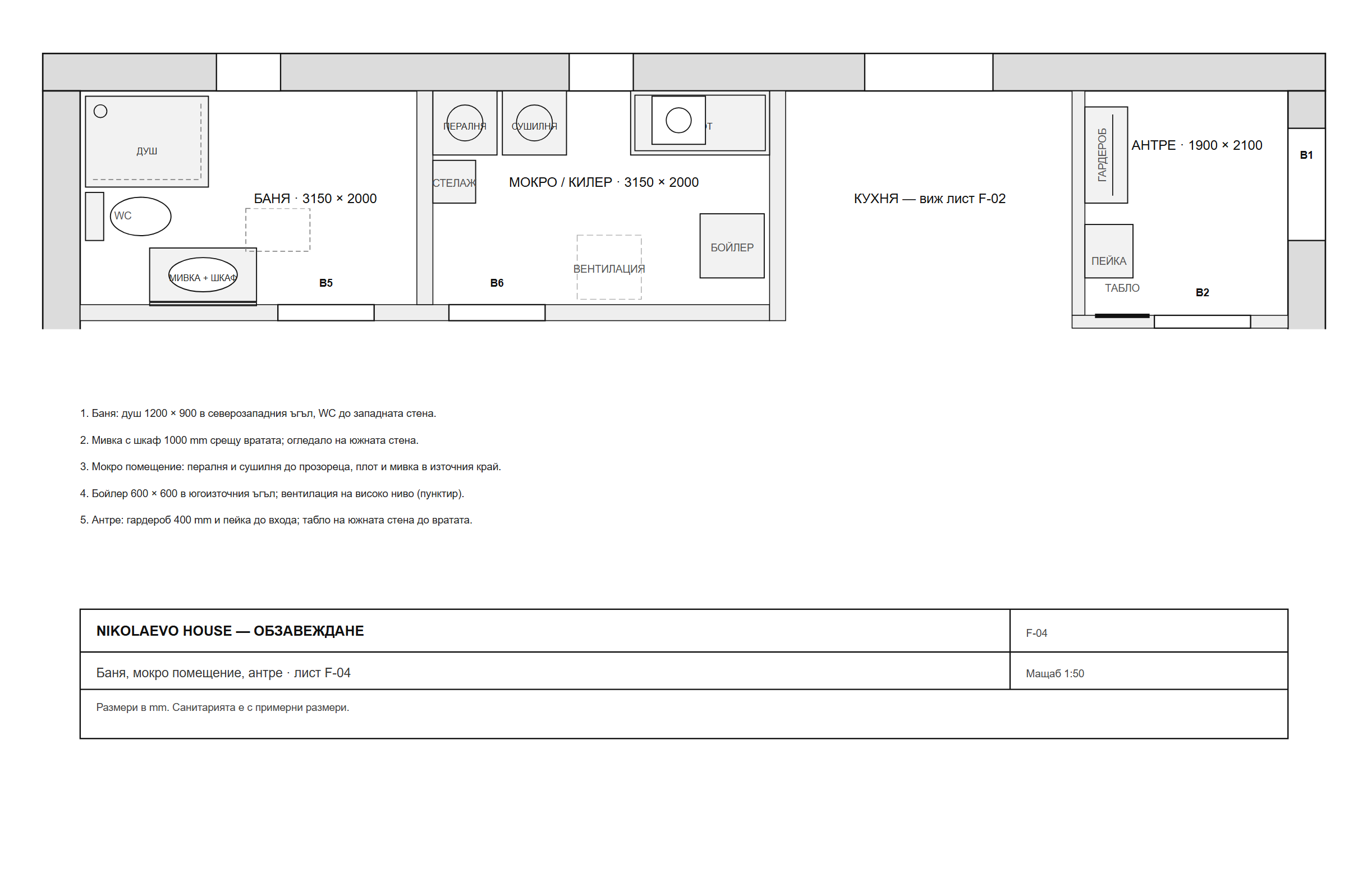
furniture/images/F-04-mokri.png
