metodiev/nikolaevo-house/icf/images/icf-courses.png

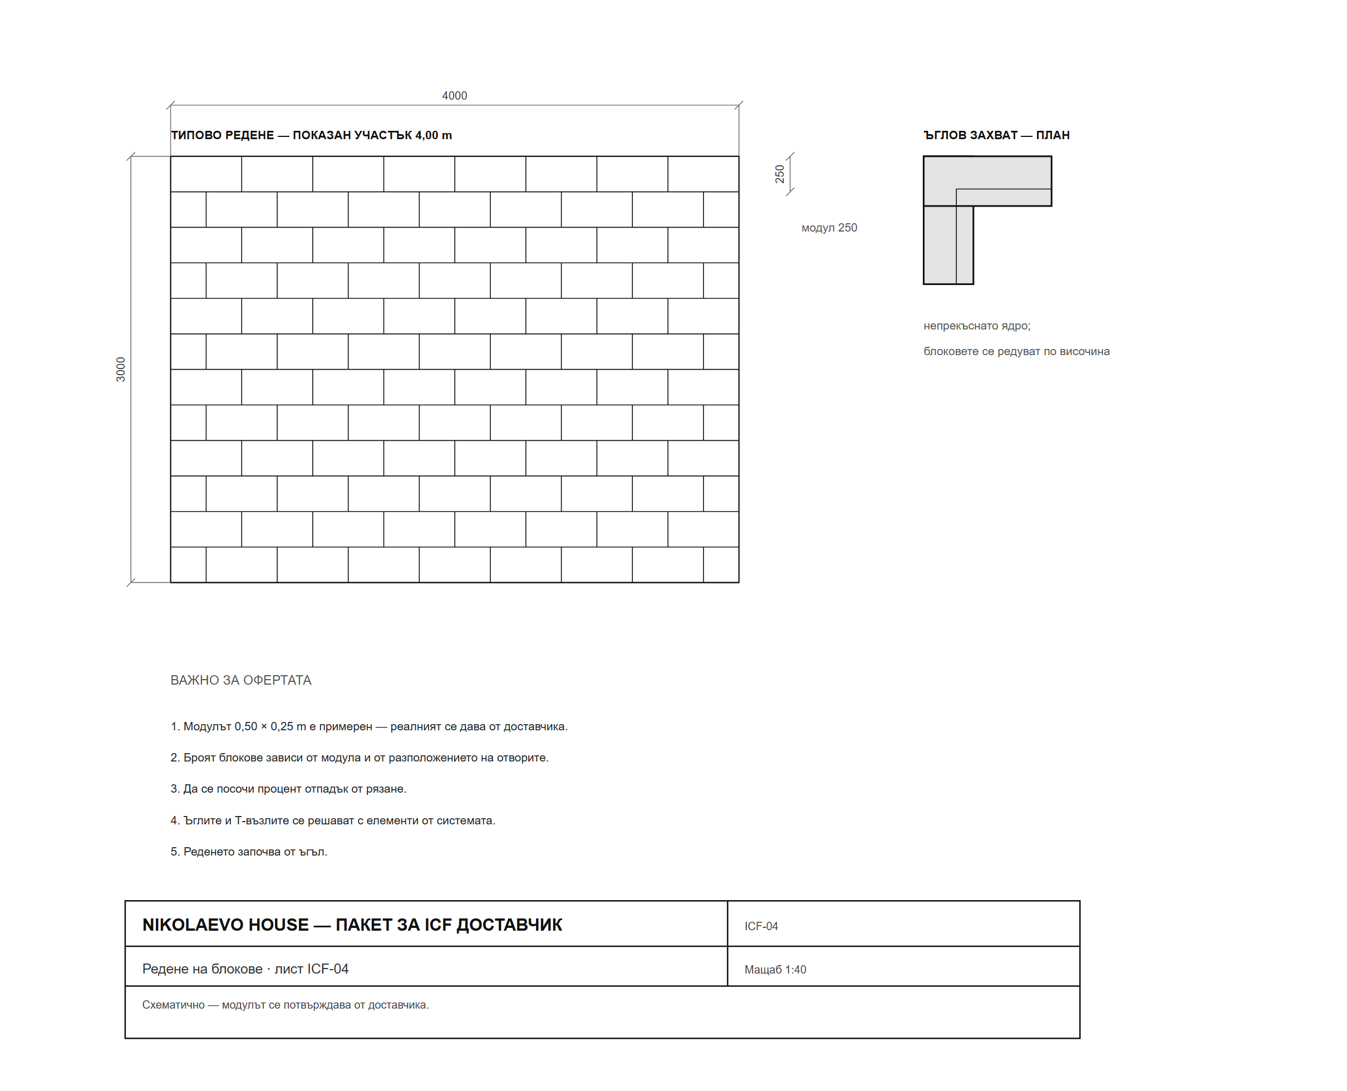
icf/images/icf-courses.png
