metodiev/nikolaevo-house/icf/images/icf-details.png

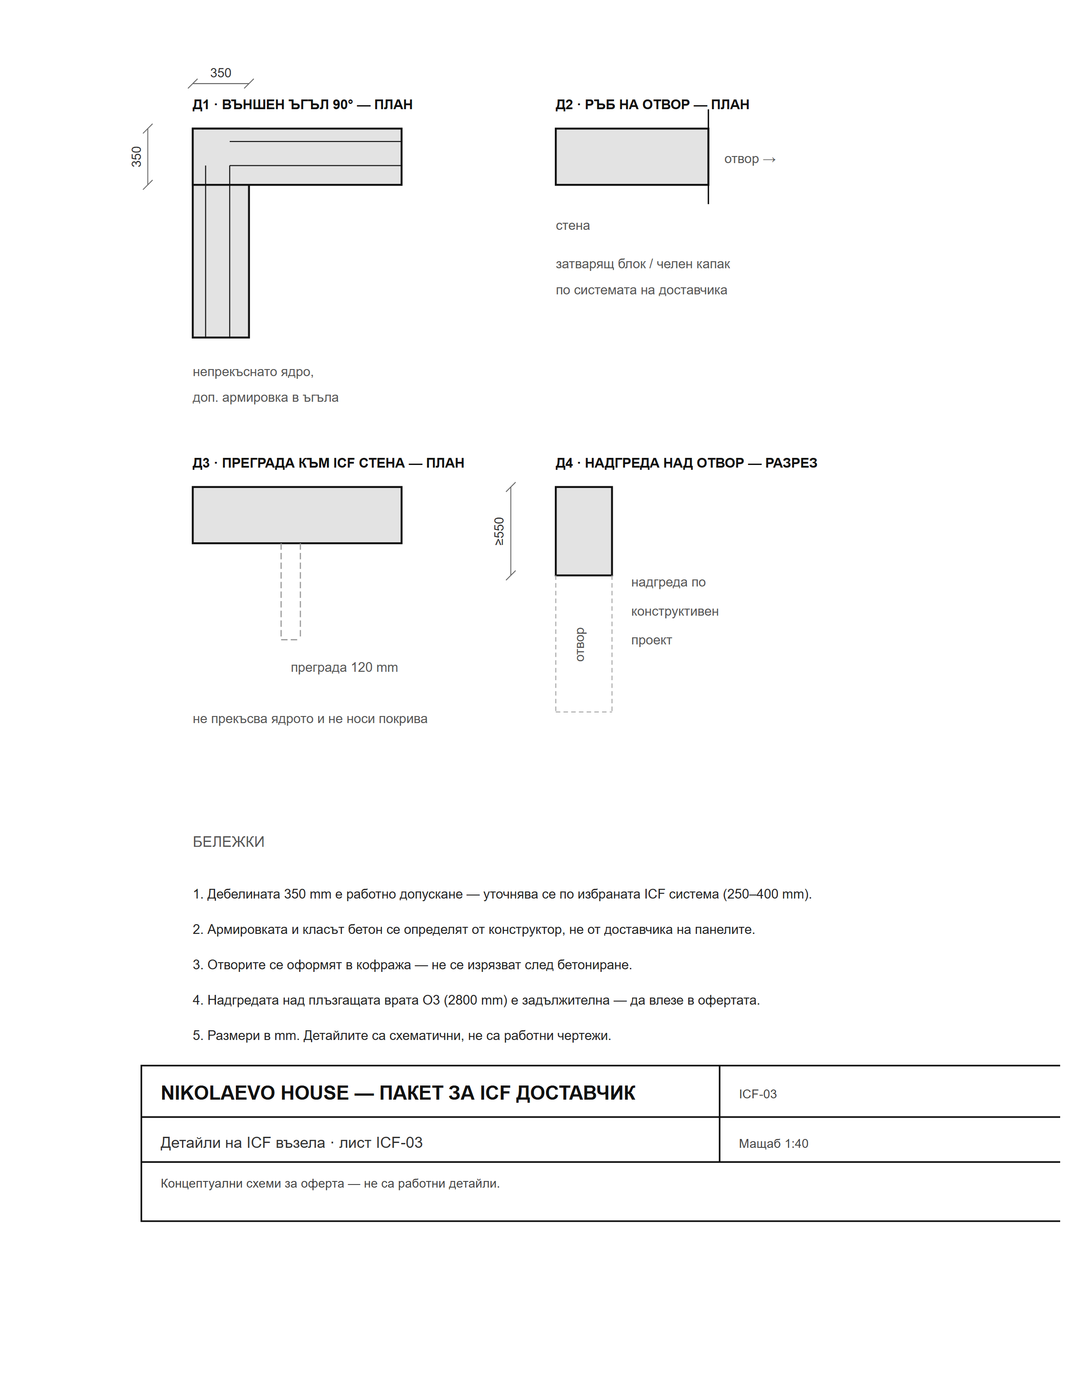
icf/images/icf-details.png
