metodiev/nikolaevo-house/icf/images/icf-elevations.png

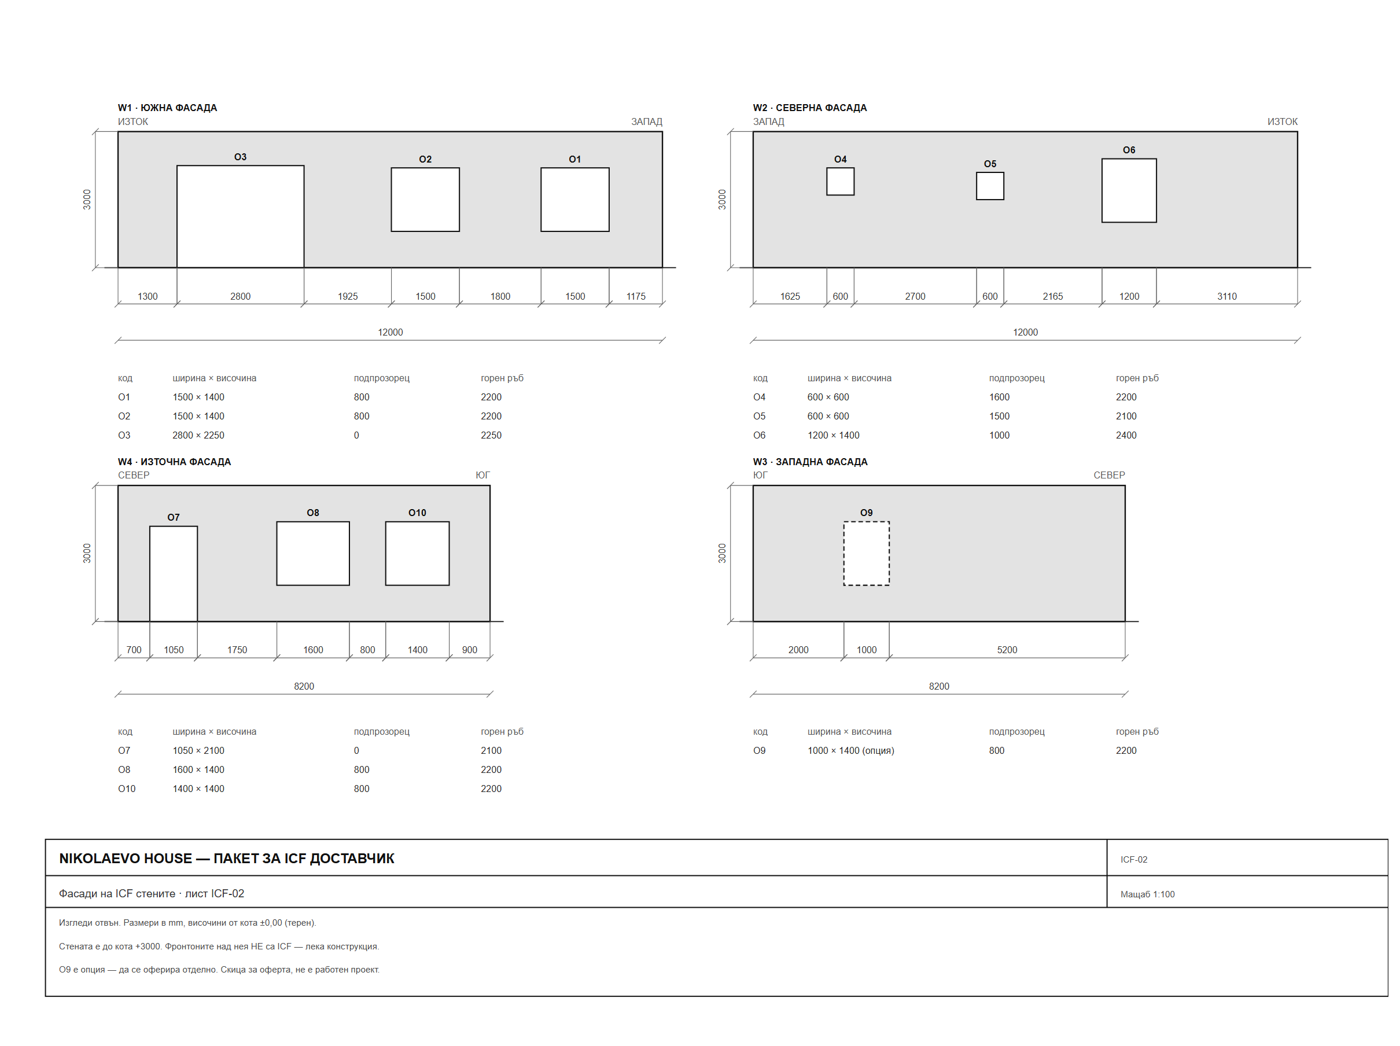
icf/images/icf-elevations.png
