metodiev/nikolaevo-house/icf/images/icf-plan.png

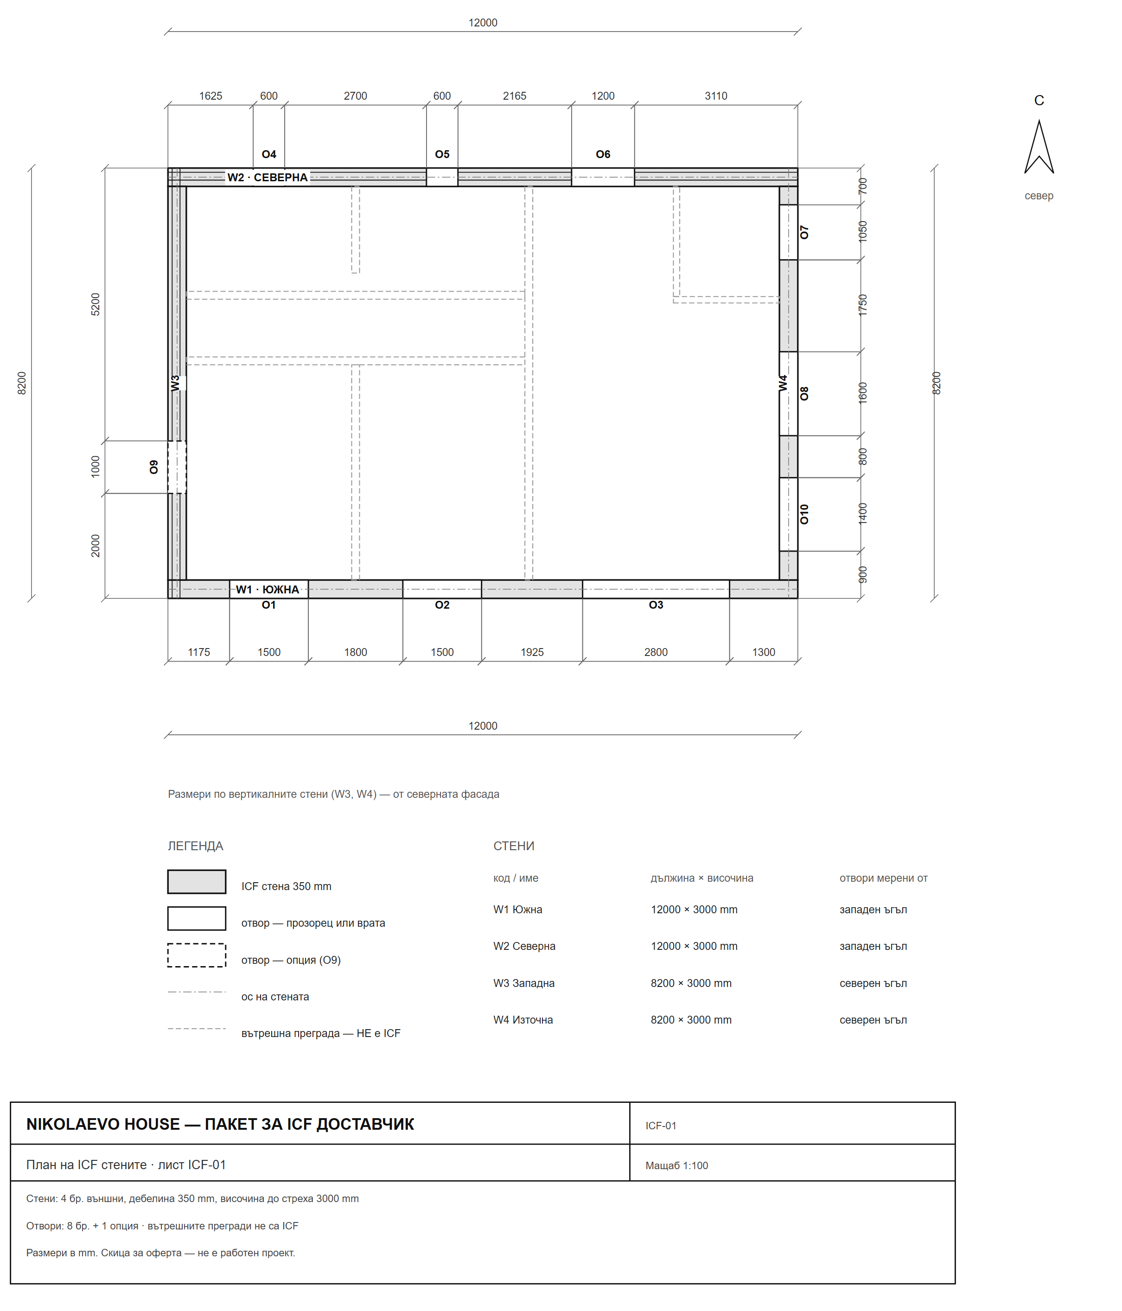
icf/images/icf-plan.png
