metodiev/nikolaevo-house/budget/01-cost-estimate.md

# Ориентировъчна оценка на разходите

За едноетажна ICF къща, **98,4 m² застроена площ**, „конструкция и базова
завършеност“ — без мебели, уреди, тераса, ограда и озеленяване.

> ## ⚠️ Това е само ориентировъчна стойност, действителната цена зависи от местната оферта.
>
> Стойностите по-долу са **широки диапазони**, базирани на общи пазарни наблюдения, а
> не на оферти. Те не са гаранция и не заместват ценово предложение от изпълнител.
> Цените в България варират силно по регион, сезон и наличие на ICF екипи.

Всички стойности са в **евро (€)**, без ДДС. Ако се налага преизчисляване в лева,
курсът е фиксиран: **1 € = 1,95583 лв.**

---

## 1. Обобщение

| Показател | Стойност |
|---|---|
| Застроена площ | 98,4 m² |
| **Общо (без ДДС)** | **≈ 72 000 – 136 000 €** |
| **На m²** | **≈ 730 – 1 380 €/m²** |
| Средна стойност (за ориентир) | ≈ 104 000 € ≈ 1 060 €/m² |

---

## 2. Разбивка по позиции

| № | Позиция | Мин. (€) | Макс. (€) | Бележка |
|---|---|---|---|---|
| 1 | Изкоп, фундаменти, подова плоча с изолация и хидроизолация | 13 000 | 22 000 | зависи от геологията и котата |
| 2 | ICF стени — блокове, бетон, армировка, труд (~100–120 m² стена) | 13 000 | 26 000 | най-чувствителна към цената на труда |
| 3 | Покрив — дървена конструкция, покритие, изолация, улуци | 10 000 | 21 000 | пролет 8,20 m |
| 4 | Дограма — прозорци, плъзгаща врата, входна врата | 8 000 | 15 000 | зависи от профила и стъклопакета |
| 5 | Инсталации — ВиК, електро, отопление/охлаждане, вентилация | 12 000 | 23 000 | вкл. вентилация с рекуперация |
| 6 | Довършителни — замазки, мазилки, настилки, базова завършеност | 16 000 | 29 000 | без мебели и уреди |
| | **Общо** | **72 000** | **136 000** | |

Диаграма на пропорциите: [04-diagrams.md](../architecture/04-diagrams.md#6-ориентировъчно-разпределение-на-разходите)

---

## 3. Какво НЕ е включено

- Архитектурен и конструктивен проект, инженер-геоложки доклад
- Такси, разрешение за строеж, строителен надзор
- Присъединяване към електро, вода, канализация
- ДДС (ако е приложимо за възложителя)
- Южна тераса, навес над входа, ограда, настилки на двора, озеленяване
- Кухня (мебели и уреди), вградени гардероби, мебели, осветителни тела
- Климатизация, соларни панели, камина
- Извозване на земни маси и строителни отпадъци (при специфични условия)
- Закъснения, промени в проекта по време на строежа

Реалистично тези позиции добавят **двуцифрен процент** отгоре — уточняват се с
проектанта и с офертите.

---

## 4. Какво влияе най-силно на цената

| Фактор | Ефект |
|---|---|
| **Труд за ICF** — наличие на опитни екипи | най-голямата несигурност; в райони без ICF екипи цената расте значително |
| Геология / подпочвени води | може да удвои разхода за фундамент |
| Ниво на завършеност | „до шпакловка“ и „до ключ“ са различни светове |
| Дограма | тройният стъклопакет и алуминият с термомост са в горния край |
| Отоплителна система | подово + термопомпа е по-скъпо от радиатори, но по-подходящо за ICF |
| Вентилация с рекуперация | добавка, но при ICF е трудно да се пропусне |
| Покрив | двускатен с керемиди vs. метално покритие vs. плоска — голяма разлика |
| Разстояние до обекта и доставки | транспортът е реален разход |

**Забележка:** ICF не е непременно по-евтина от тухлена конструкция на квадратен
метър. Печалбата е в скоростта на изпълнение, херметичността и ниските разходи за
отопление през годините. Сравнението трябва да се прави за **пълен жизнен цикъл**, а
не само за „цена на m²“.

---

## 5. Как да се получи реална цена

При поискване на оферта е добре да се изиска **разбивка по позиции**, а не обща сума:

1. Изкоп, фундамент, подова плоча — с посочени дебелини и изолация
2. ICF доставка + монтаж + бетониране (отделни редове)
3. Покрив — конструкция, покритие, изолация, улуци
4. Дограма — марка, профил, стъклопакет
5. ВиК — до коя точка (до плочките?)
6. Електро — брой точки, табло, окабеляване
7. Отопление и вентилация — какво точно влиза
8. Довършителни — какво точно е включено (мазилка, замазка, настилки, боя)
9. Срок и график на плащанията
10. Гаранция и кой носи отговорност при дефекти

Полезно е офертите да са по **един и същ обхват** — иначе не са сравними.

---

## 6. Следваща стъпка

Преди да се търсят оферти е нужно:

- [ ] Проверка на парцела по ПУП (отстояния, височина, плътност)
- [ ] Геоложки доклад
- [ ] Избор на ICF система
- [ ] Идеен проект и **количествени сметки** (по тях се прави оферта)

Пълна информация за обхвата: [Задание за проектанта](../documentation/01-design-brief.md)

---

*Оценката е съставена на 24.10.2026 г. и не е актуализирана автоматично.*
