metodiev/nikolaevo-house/3d/house-full.obj

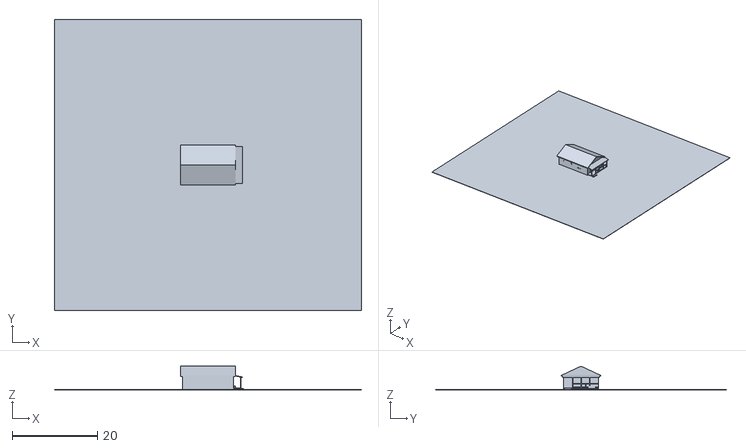
[picture p31: CAD file, 2026-10-24]
3d/house-full.obj
72.0 x 68.2 x 5.54
