metodiev/nikolaevo-house/3d/house-shell.obj

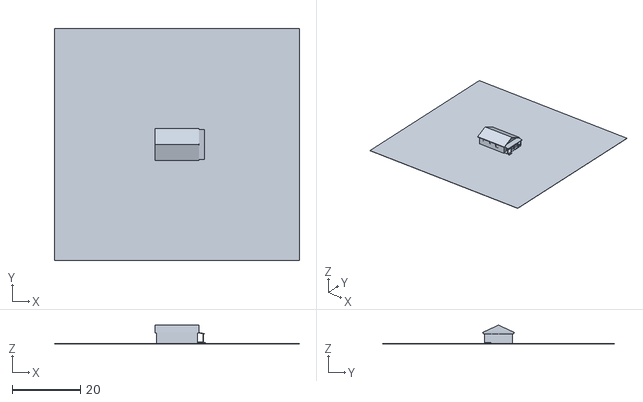
[picture p32: CAD file, 2026-10-24]
3d/house-shell.obj
72.0 x 68.2 x 5.54
