metodiev/nikolaevo-house/architecture/cad/house.dxf

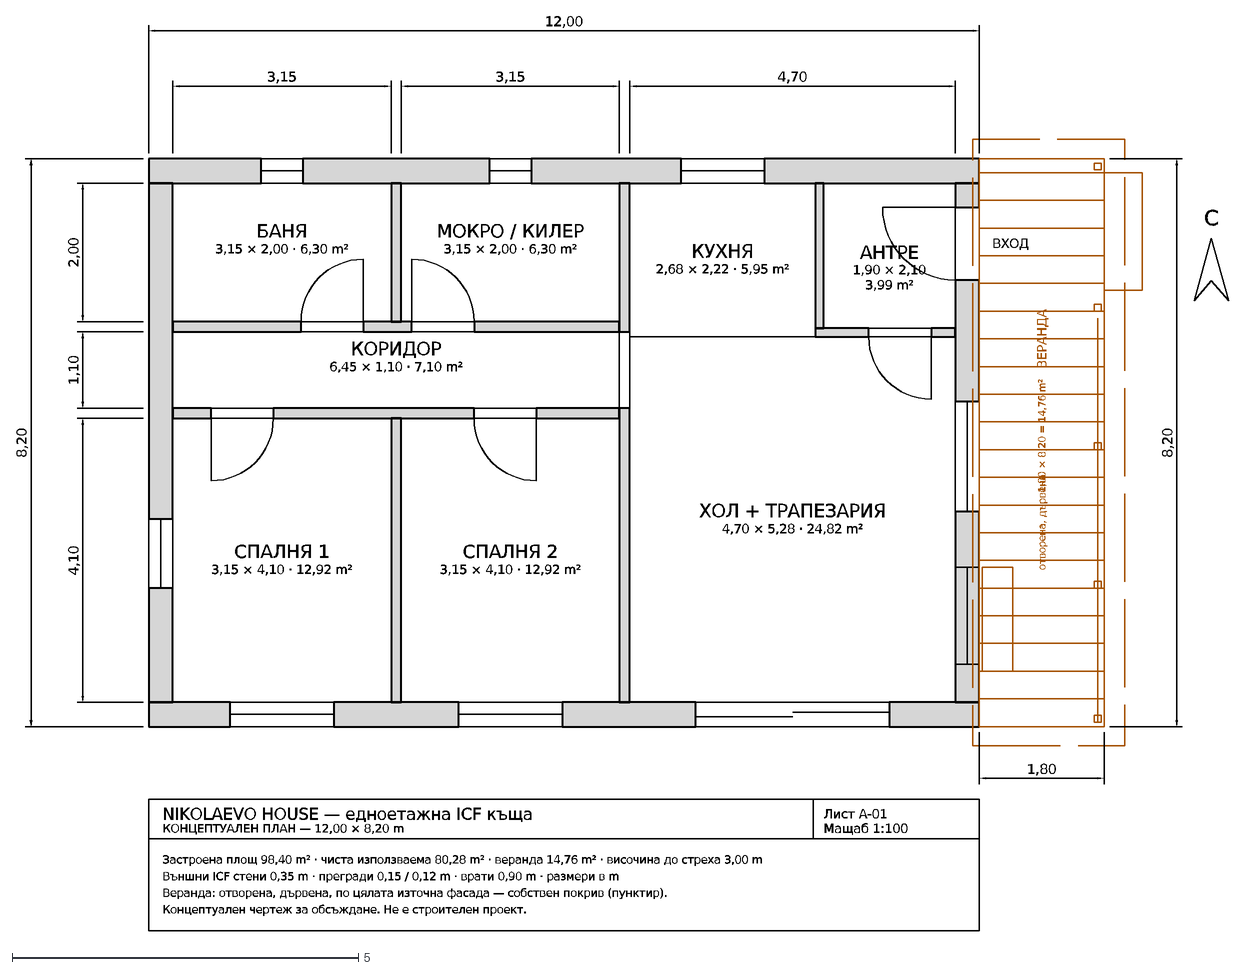
[picture p33: CAD file, 2026-10-24]
architecture/cad/house.dxf
СПАЛНЯ 1
3,15 × 4,10 · 12,92 m²
СПАЛНЯ 2
ХОЛ + ТРАПЕЗАРИЯ
4,70 × 5,28 · 24,82 m²
КУХНЯ
2,68 × 2,22 · 5,95 m²
КОРИДОР
6,45 × 1,10 · 7,10 m²
БАНЯ
3,15 × 2,00 · 6,30 m²
МОКРО / КИЛЕР
АНТРЕ
1,90 × 2,10
3,99 m²
ВХОД
ВЕРАНДА
1,80 × 8,20 = 14,76 m²
отворена, дървена
3,15
4,70
12,00
2,00
1,10
4,10
8,20
1,80
NIKOLAEVO HOUSE — едноетажна ICF къща
КОНЦЕПТУАЛЕН ПЛАН — 12,00 × 8,20 m
Лист A-01
Мащаб 1:100
Застроена площ 98,40 m² · чиста използваема 80,28 m² · веранда 14,76 m² · височина до стреха 3,00 m
Външни ICF стени 0,35 m · прегради 0,15 / 0,12 m · врати 0,90 m · размери в m
Веранда: отворена, дървена, по цялата източна фасада — собствен покрив (пунктир).
Концептуален чертеж за обсъждане. Не е строителен проект.
С
