metodiev/nikolaevo-house/site/measurements/README.md

# Измервания

Ръчни и геодезични измервания на терена.

## Какво трябва да има

- [ ] Денивелация на терена (коти по ъглите)
- [ ] Позиция на съществуващи дървета и сгради
- [ ] Трасета на подземни комуникации (ток, вода, канал)
- [ ] Отстояния до съседните огради
- [ ] Посока и ширина на достъпа от изток

## Формат

Данните се записват като таблица (точка, x, y, кота) или като снимка на
теренния дневник. Файловете се качват в тази папка.

**Все още няма качени измервания.**
