metodiev/nikolaevo-house/(commit log)

2026-10-24 nikolaevo architecture
    [house.dxf]
2026-10-24 edit bedrooms
    [house.dxf]
2026-10-24 add veranda
    [house-full.obj, house-shell.obj, house.dxf]
